Fjmoya-uba/Taller-de-Circuitos-Grupo-5/Checkpoint 5/Informe/main.tex

\documentclass[a4paper,12pt]{article}

%\documentclass[draft, 12pt]{article}
% ================================================== DATOS ==================================================

% Información de la materia
\newcommand{\codMateria}{TA138}
\newcommand{\nombreMateria}{Taller de Diseño de}
\newcommand{\cuatrimestre}{1.\textsuperscript{er} Cuatrimestre}

% Información del TP
\newcommand{\TpTitulo}{Proyecto Integrador -- Checkpoint 5}
\newcommand{\fecha}{\today}
\newcommand{\group}{Grupo 5}

% Información de alumnos
\newcommand{\nombreA}{Lautaro García Vitale}
\newcommand{\padronA}{110.028}
\newcommand{\emailA}{lagarciav@fi.uba.ar}

\newcommand{\nombreB}{Santiago Manuel Cabrera}
\newcommand{\padronB}{110.445}
\newcommand{\emailB}{smcabrera@fi.uba.ar}

\newcommand{\nombreC}{Francisco Javier Moya}
\newcommand{\padronC}{109.899}
\newcommand{\emailC}{fjmoya@fi.uba.ar}

% ================================================== PAQUETES =================================================

% Codificación y lenguaje
\usepackage[utf8]{inputenc}
\usepackage{siunitx}
\usepackage[ddmmyy]{datetime}
\usepackage[language=spanish]{lipsum}
\usepackage[spanish]{datetime2}
\usepackage[T1]{fontenc}
\usepackage[spanish,es-nodecimaldot]{babel}

% -------- CAMBIAR "CUADRO" POR "TABLA" --------
\addto\captionsspanish{
    \renewcommand{\tablename}{Tabla}
}

\usepackage[a4paper,margin=2.5cm]{geometry}
\usepackage{amsmath,amssymb,amsthm,mathtools}
\usepackage{bm}
\usepackage{setspace}
\usepackage{hyperref}
\usepackage{enumitem}

% Márgenes y página
\usepackage{geometry}
\usepackage{fancyhdr}
\usepackage{emptypage}
%\usepackage{parskip}

% Encabezado personalizado
\pagestyle{fancy}
\fancyhf{}
\rhead{\group}
\lhead{\TpTitulo}
\cfoot{\thepage}
\setlength{\headheight}{14.5pt}

% Tipografía matemática
\usepackage{mathtools}
\usepackage{amssymb}
\usepackage{amsfonts}
\usepackage{amsthm}
\usepackage{yhmath}
\usepackage{dsfont}
\usepackage{esdiff}
\usepackage{xfrac}
\usepackage{upgreek}
\usepackage{siunitx}
\sisetup{output-decimal-marker = {,}} % Configura la coma como separador
\sisetup{per-mode=reciprocal, separate-uncertainty=true}

% Gráficos y tablas
\usepackage{graphicx}
\usepackage{float}
\usepackage{booktabs}
\usepackage{caption}
\usepackage{subcaption}
\usepackage{multirow}
\usepackage{adjustbox}
\usepackage{hyperref}

% TikZ y gráficos avanzados
\usepackage{pgfplots}
\pgfplotsset{compat=1.18}
\usepackage{tikz}

% Código fuente y resaltado
\usepackage{minted}
\usepackage{tcolorbox}
\definecolor{codebg}{rgb}{0.95,0.95,0.95}  % Color de fondo del código
\usemintedstyle{friendly}                  % Estilo del resaltado de sintaxis
\setminted{
    linenos=true,                          % Numeración de líneas
    bgcolor=codebg,                        % Color de fondo del código
    fontsize=\footnotesize,                % Tamaño de la fuente
    frame=lines,                           % Estilo del marco
    framesep=2mm,                          % Separación del marco
    baselinestretch=1.2,                   % Espaciado entre líneas
    breaklines=true,                       % Romper líneas largas automáticamente
    encoding=utf8,                         % Codificación del archivo
    tabsize=4,                             % Tamaño de la tabulación
}

% Misceláneo
\usepackage{anyfontsize}
\usepackage{xcolor}
\usepackage{url}
\usepackage{comment}
\usepackage{multicol}
\usepackage[numbers,square]{natbib}

% Estilo de bibliografía
\bibliographystyle{IEEEtran}

% ==============================================================================================================
% ==============================================================================================================

\begin{document}

% ================================================== CARÁTULA ==================================================

\pagenumbering{arabic} % Comienza la numeración

\vspace{-1 cm} % La primera hoja tiene que tener menos espaciado

\begin{center}
  \begin{minipage}{0.8 cm}
    
  \end{minipage}
  \begin{minipage}{\widthof{\large{\textsc{Universidad de Buenos Aires}}}}
    \centering
    \large{\textsc{Universidad de Buenos Aires}}\\
    \large{\textsc{Facultad de Ingeniería}}\\
    \small{Año 2026 -- \cuatrimestre}
  \end{minipage}
\end{center}
\vspace{10mm}
\begin{center}
  \huge{\underline{\textsc{\nombreMateria}}} \\
  \huge{\underline{\textsc{Circuitos Electrónicos}}} \\
  \vspace{7 pt}
  \Large{\TpTitulo \\}
  \vspace{3mm}
  \large{\group}
\end{center}

\newcommand{\anchopadron}{\widthof{000 000}}
\begin{center}
  \begin{tabular}{l l l}
    \nombreA & \parbox{\anchopadron}{\raggedleft \padronA} & \texttt{\emailA} \\
    \nombreB & \parbox{\anchopadron}{\raggedleft \padronB} & \texttt{\emailB} \\
    \nombreC & \parbox{\anchopadron}{\raggedleft \padronC} & \texttt{\emailC} 
  \end{tabular}
\end{center}
\vspace{8mm}

\begin{center}
\renewcommand{\arraystretch}{1.3}
\begin{tabular}{@{}r p{0.62\textwidth}@{}}
\textbf{Tutor:} & Ing. Federico Gabriel D'Angiolo. \\ 
\textbf{Docentes:} & Ing.Julio Guillermo Zola, Ing. Marcelo Adrián Bruno, Ing. Sergio Quinteros e Ing. Juan Guido Salaya.
\end{tabular}
\end{center}

\vspace{2em}
\thispagestyle{empty}

\begin{abstract}
En este informe se presenta el diseño, implementación y validación experimental de una fuente conmutada tipo \textit{buck} a lazo cerrado, desarrollada como etapa final del proyecto integrador. Se aborda la caracterización del inductor, el ajuste del generador PWM, la selección de componentes de la etapa de potencia, la implementación del \textit{gate driver}, el diseño de la red de compensación y la fabricación del PCB. También se incluyen simulaciones de estabilidad y mediciones sobre el prototipo final, junto con la integración de la etapa reguladora LDO. Los resultados obtenidos verifican un funcionamiento estable de la fuente, con buena regulación de línea y de carga, eficiencias superiores al $90\%$ para $V_{in}=12\,$V en el rango ensayado y un desempeño adecuado frente a variaciones de entrada y carga. A partir de la comparación entre el modelo teórico, las simulaciones y las mediciones experimentales, se identificaron y corrigieron diferencias propias de la implementación práctica, obteniéndose finalmente una fuente funcional, eficiente y experimentalmente validada.
\end{abstract}

\newpage
\tableofcontents
\newpage

\section{Introducción}
\input{sections/intro.tex}

\section{Caracterización del inductor}
% Incluir recálculos del inductor y sus mediciones.
\input{sections/inductor.tex}

\section{Diseño de la \textit{buck} a lazo cerrado}
\subsection{Modificación del circuito generador del PWM}
\input{sections/diseño_buck/modif_pwm.tex}
% Indicar la medición del tiempo de propagación del comparador y su debida corrección en LTspice. Indicar nuevos valores de resistencia y/o capacitor para obtener una frecuencia de 120-140 kHz. Indicar modificaciones en el circuito (se cambia el potenciómetro por Vc). No hace falta una nueva etapa que garantice 4 V < Vc < 5 V porque como el comparador integra el error, en algun momento llegara a los valores de la triangular.
\subsection{Diodos de rueda libre}
% Incluir análisis de los diodos en el switching.
\input{sections/diseño_buck/diodos.tex}
\subsection{Carga fantasma}
% Mencionar para qué sirve y el agregado del led.
\input{sections/diseño_buck/fantasma.tex}
\subsection{Capacitores}
% Incluir gráfico de la capacidad vs. la frecuencia. Mencionar que se escoge un capacitor más grande. Incluir capacitor cerámico en paralelo para disminuir la ESR.
\input{sections/diseño_buck/capacitores.tex}
\subsection{\textit{Gate driver}}
% Explicar para que funciona e incluir los cálculos del diodo y capacitor de boostrap.

\input{sections/diseño_buck/Gate driver.tex}

\subsection{Red de compensación}
% Hablar de la red de compensación tipo III y cómo se calcularon sus componentes (Agregar en un apéndice los cálculos matriciales).
\input{sections/diseño_buck/compensacion.tex}
\subsection{Circuito final}
% Incluir un esquemático del diseño final del circuito.
\input{sections/diseño_buck/circuito-final.tex}

\section{Simulaciones}
% Incluir gráficos de simulaciones.
\input{sections/Simulaciones.tex}

\section{Diseño e implementación del PCB}
\input{sections/PCB.tex}

\section{Mediciones}
% Incluir gráficos de mediciones.
\input{sections/mediciones.tex}

\section{Integración final con el LDO}
\input{sections/ldo.tex}

\section{Conclusiones}
\input{sections/conclusiones.tex}

\input{sections/bibliografia.tex}

\end{document}
