Fjmoya-uba/Taller-de-Circuitos-Grupo-5/Checkpoint 5/Informe/sections/bibliografia.tex

\begin{thebibliography}{9}

\bibitem{CosmoFerrites_CF196}
Cosmo Ferrites Ltd.,
\textit{Material Specifications CF196},
Material Data Sheet,
4 August 2017.

\bibitem{CosmoFerrites_EE3007}
Cosmo Ferrites Ltd.,
\textit{Product Data Sheet: Core EE3007},
Product Data Sheet.

\bibitem{Zhang2015}
H. J. Zhang,
``Modelado y diseño de compensación de lazo en fuentes de alimentación conmutadas. Parte 1ª'',
\textit{Revista Española de Electrónica (REE)},
n.º 96, pp. 96--101, octubre de 2015.
Artículo cedido por Linear Technology.

\bibitem{IR2104_datasheet}
International Rectifier,
\textit{IR2104(S) \& IR2104S(PbF) Half-Bridge Driver Datasheet},
Data Sheet No. PD60046-S, Abril 2004.

\bibitem{LM2576_datasheet}
Texas Instruments,
\emph{LM2576, LM2576HV SIMPLE SWITCHER (R) 3-A Step-Down Voltage Regulator Datasheet},
Document No.~SNVS107G,
Revision~G, March~2023.

\bibitem{Vishay_030031AS}
Vishay BCcomponents,
\textit{030/031 AS Aluminum Electrolytic Capacitors, Axial Standard},
Document Number~28327,
Revision: 16 September 2016.

\end{thebibliography}
