Fjmoya-uba/Taller-de-Circuitos-Grupo-5/Checkpoint 5/Informe/sections/diseño_buck/circuito-final.tex

En base a todo lo comentado en las secciones anteriores, el circuito final queda como se observa en la Figura~\ref{fig:circuito-final}.

\newpage

\begin{figure}[H]
    \centering
    
    \caption{Circuito final hecho en KiCad.}
    \label{fig:circuito-final}
\end{figure}

\newpage
