Fjmoya-uba/Taller-de-Circuitos-Grupo-5/Checkpoint 5/Informe/sections/diseño_buck/fantasma.tex

Con el fin de garantizar una corriente mínima de salida durante los ensayos experimentales, se incorporó una carga fantasma compuesta por un diodo LED y su correspondiente resistencia limitadora de corriente. En los convertidores \textit{buck}, especialmente cuando operan en lazo cerrado, una carga mínima contribuye a mantener una regulación estable de la tensión de salida y evita comportamientos indeseados asociados al funcionamiento en vacío, como oscilaciones o una regulación deficiente. Además, el LED proporciona una indicación visual inmediata del correcto funcionamiento de la fuente, permitiendo verificar de manera sencilla la presencia de tensión en la salida durante las pruebas.
