Fjmoya-uba/Taller-de-Circuitos-Grupo-5/Checkpoint 5/Informe/img/Mediciones imagenes/Regulación de carga.pdf

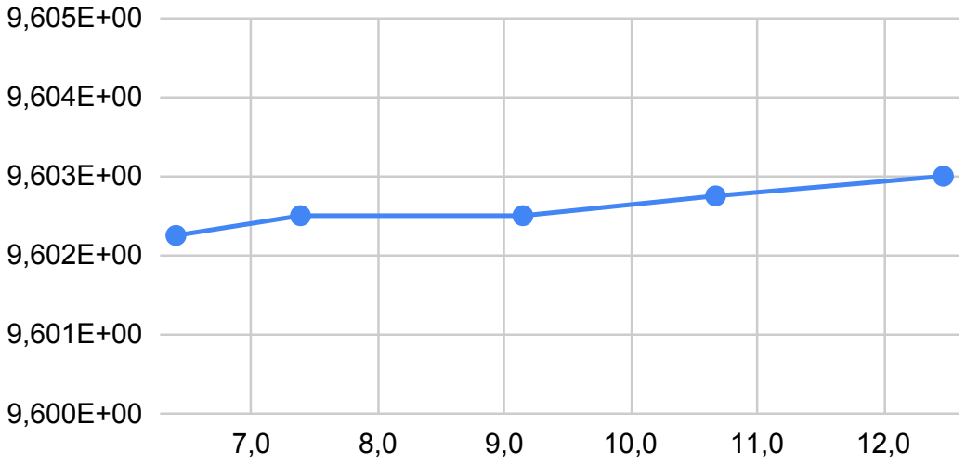
[picture p64: figure]

RL [Ohm]

Vo[V]

## Regulación de carga
