Fjmoya-uba/Taller-de-Circuitos-Grupo-5/Checkpoint 5/Mediciones imagenes/Eficiencia vs. corriente de salida.pdf

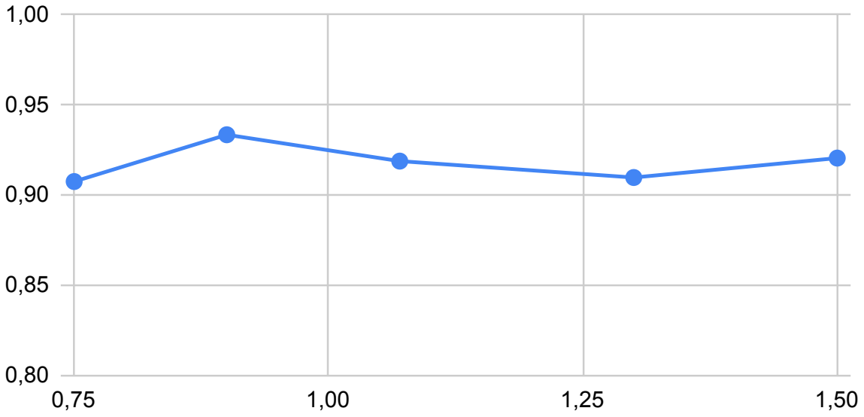
[picture p65: figure]

Io[A]

Eficiencia

## Eficiencia vs. corriente de salida
