Fjmoya-uba/Taller-de-Circuitos-Grupo-5/Checkpoint 5/Mediciones imagenes/Regulacion de carga.pdf

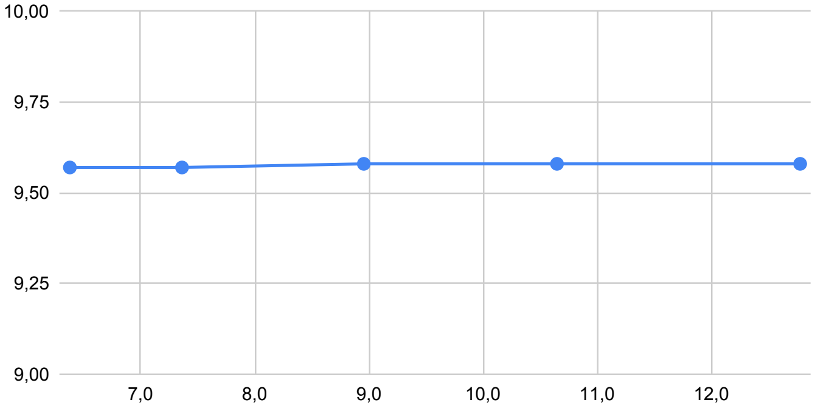
[picture p66: figure]

RL [Ohm]

Vo[V]

## Regulación de carga
