Fjmoya-uba/Taller-de-Circuitos-Grupo-5/Checkpoint 5/Mediciones imagenes/Eficiencia vs. tensión de entrada.pdf

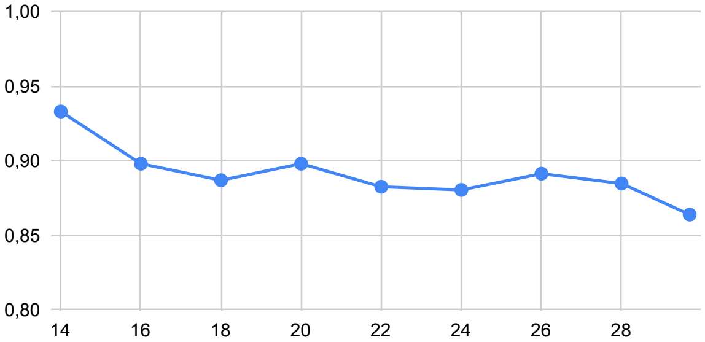
[picture p67: figure]

Vin[V]

Eficiencia

## Eficiencia vs. tensión de entrada
