Fjmoya-uba/Taller-de-Circuitos-Grupo-5/Checkpoint 5/Mediciones imagenes/Regulación de linea.pdf

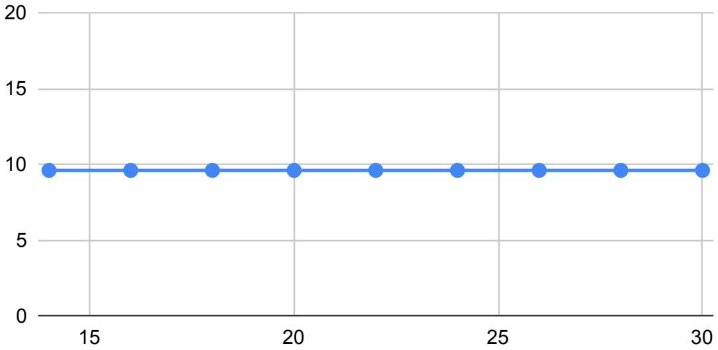
[picture p68: figure]

Vin[V]

Vout[V]

## Regulación de línea
