Fjmoya-uba/Taller-de-Circuitos-Grupo-5/Checkpoint 5/Compensación - Cuentas.pdf

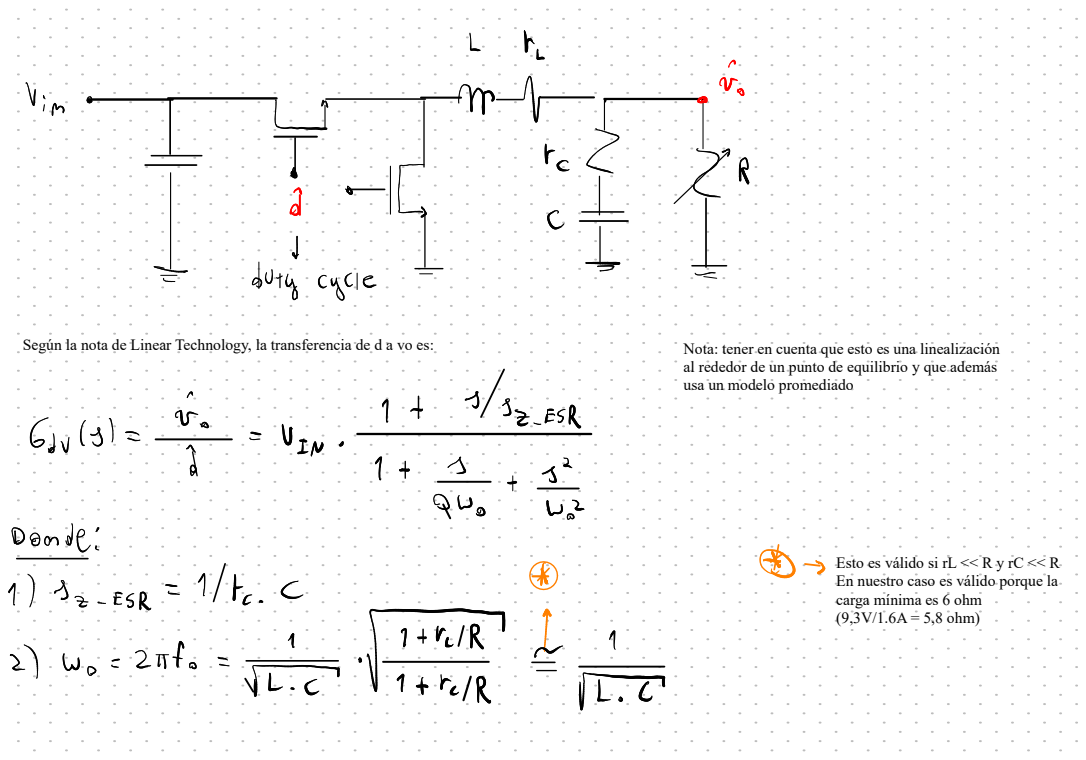
[picture p69: page 1]
Según la nota de Linear Technology, la transferencia de d a vo es:; Nota: tener en cuenta que esto es una linealización

al rededor de un punto de equilibrio y que además
usa un modelo promediado

Esto es válido si rL << R y rC << R
En nuestro caso es válido porque la
carga mínima es 6 ohm
(9,3V/1.6A = 5,8 ohm)

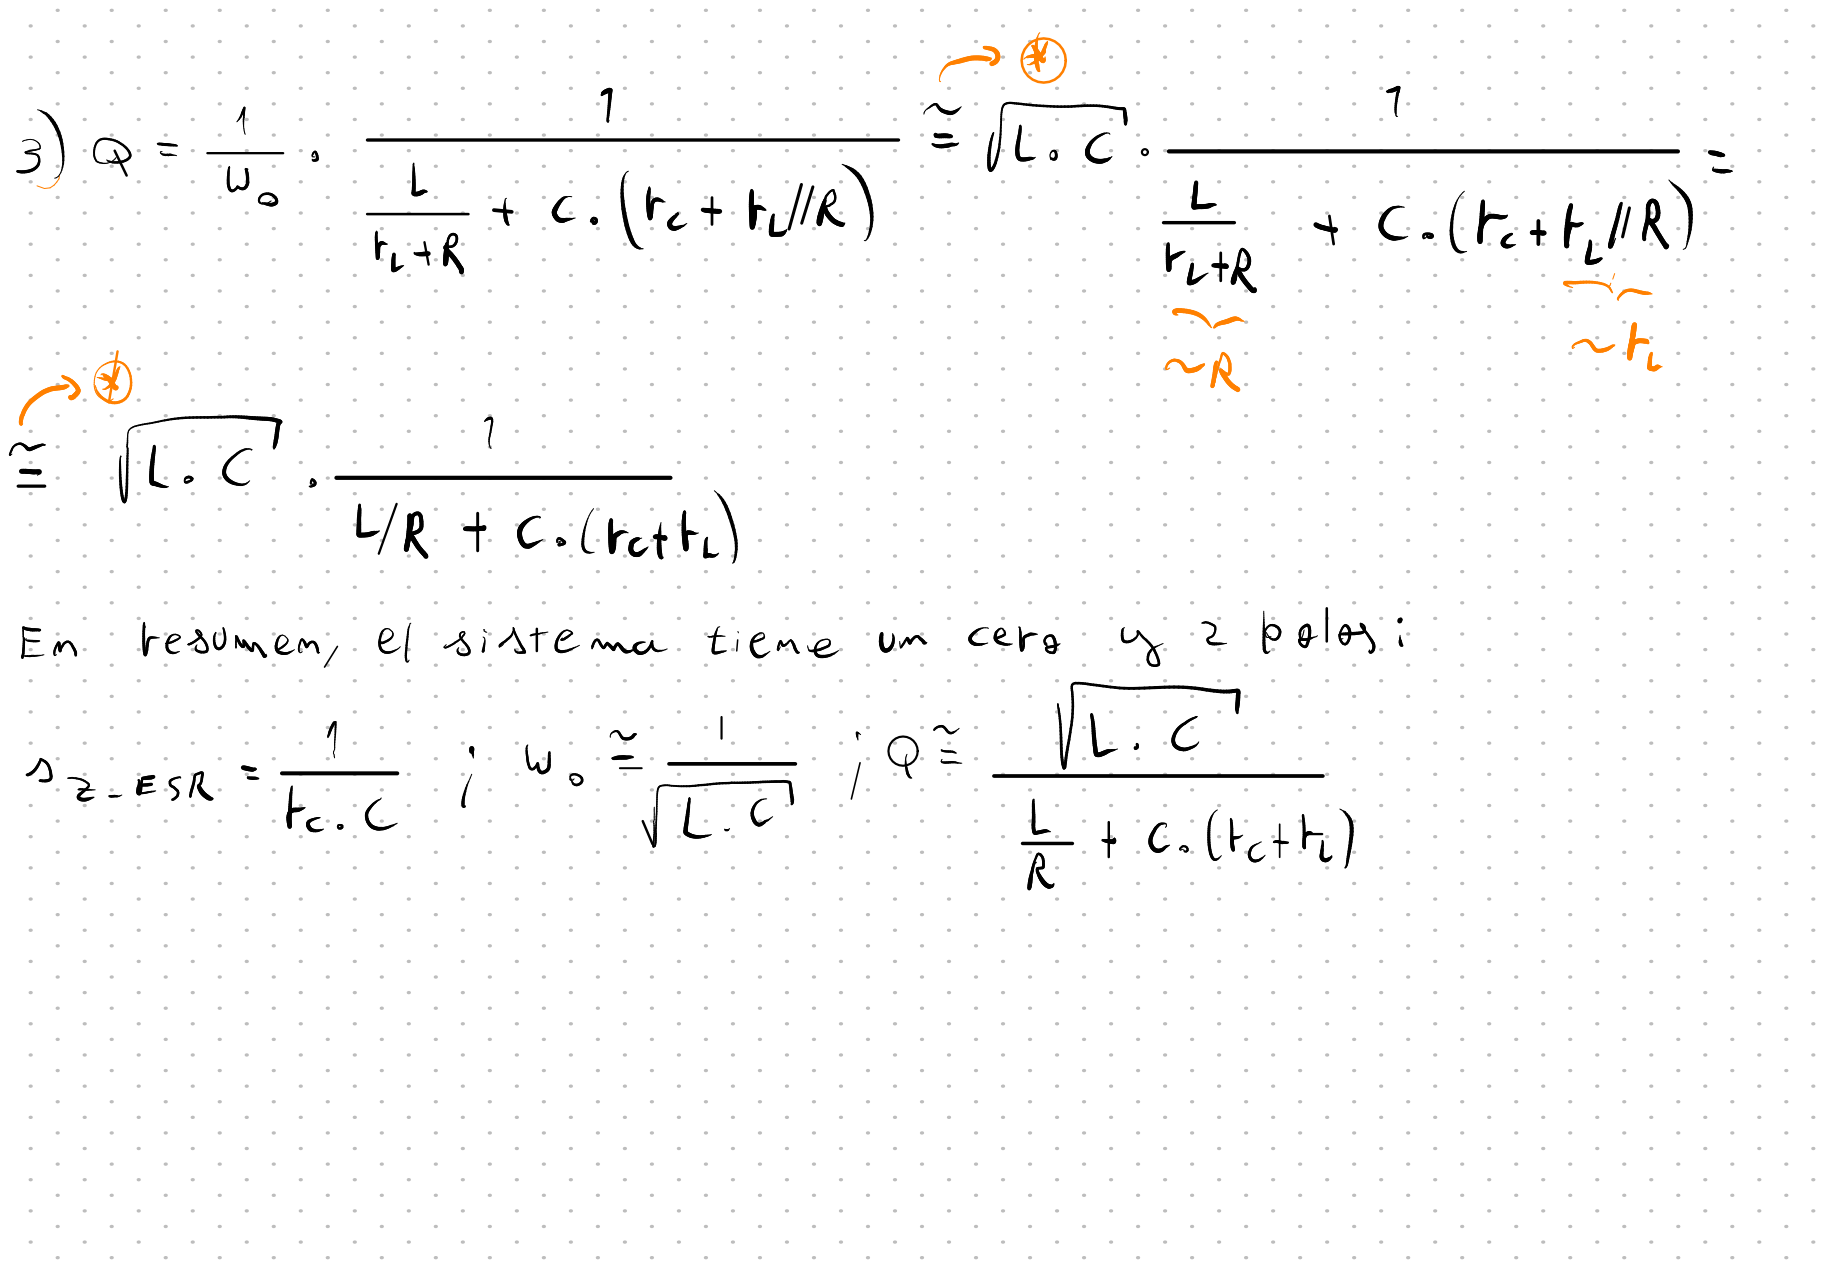
[picture p70: page 2]

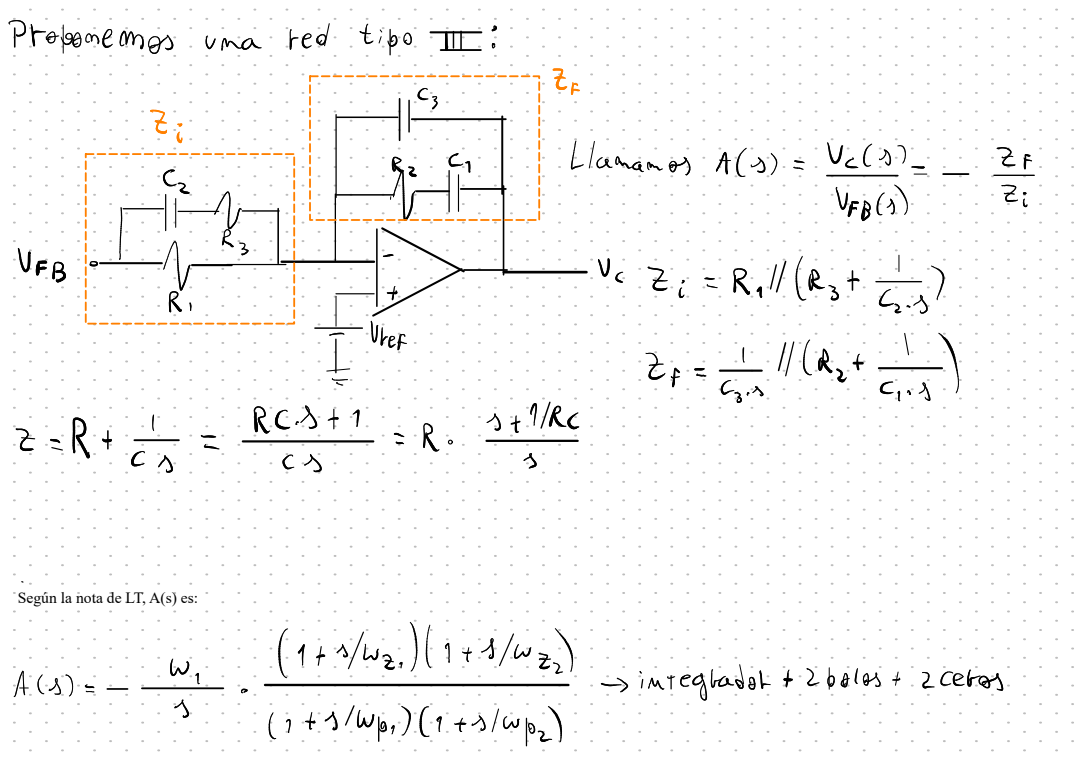
[picture p71: page 3]

Según la nota de LT, A(s) es:

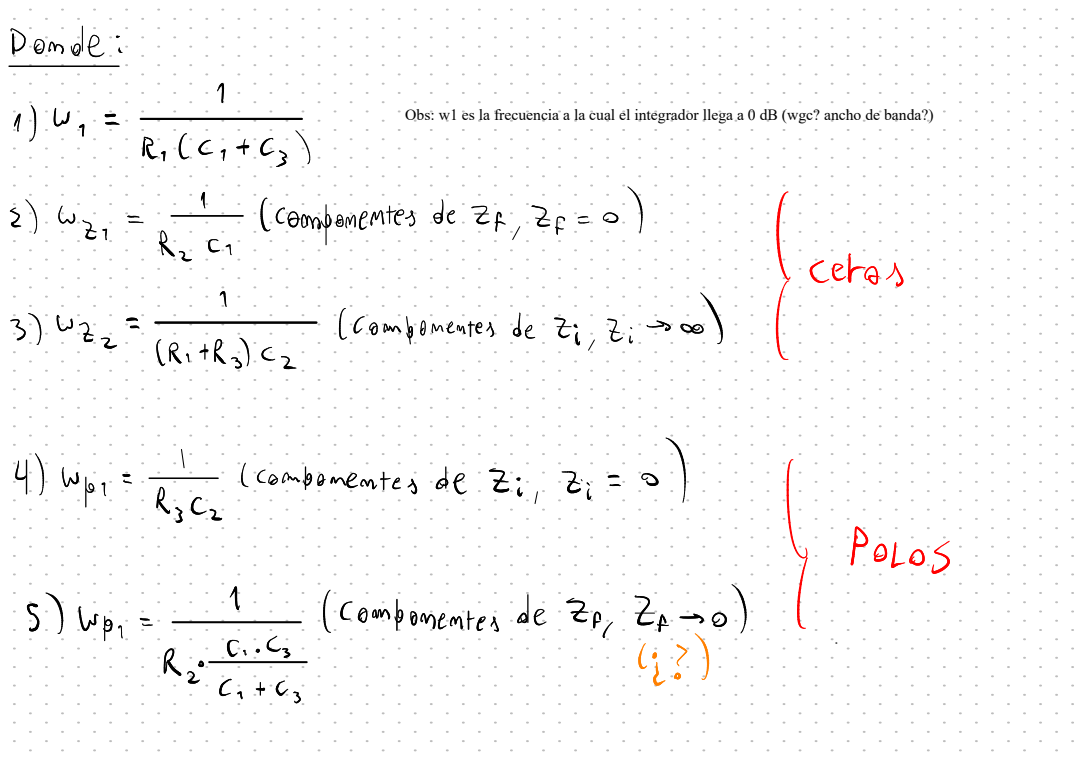
[picture p72: page 4]

Obs: w1 es la frecuencia a la cual el integrador llega a 0 dB (wgc? ancho de banda?)

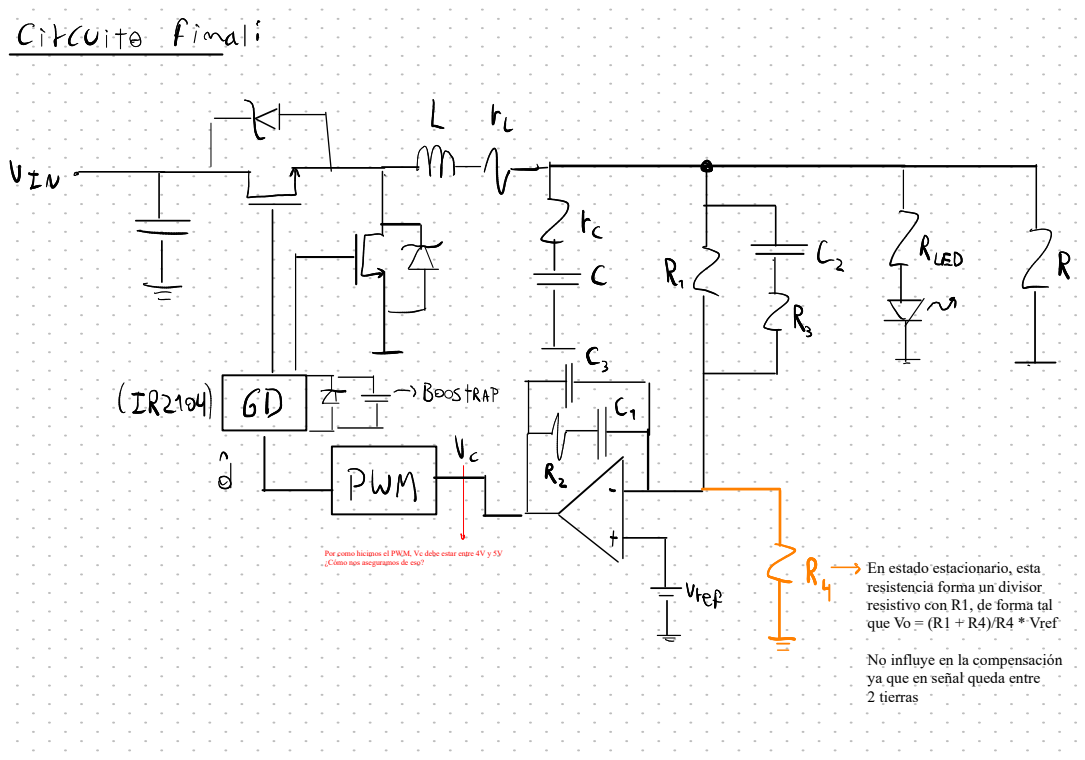
[picture p73: page 5]
¿Cómo nos aseguramos de eso?; En estado estacionario, esta

Por como hicimos el PWM, Vc debe estar entre 4V y 5V

resistencia forma un divisor
resistivo con R1, de forma tal
que Vo = (R1 + R4)/R4 * Vref

No influye en la compensación
ya que en señal queda entre
2 tierras

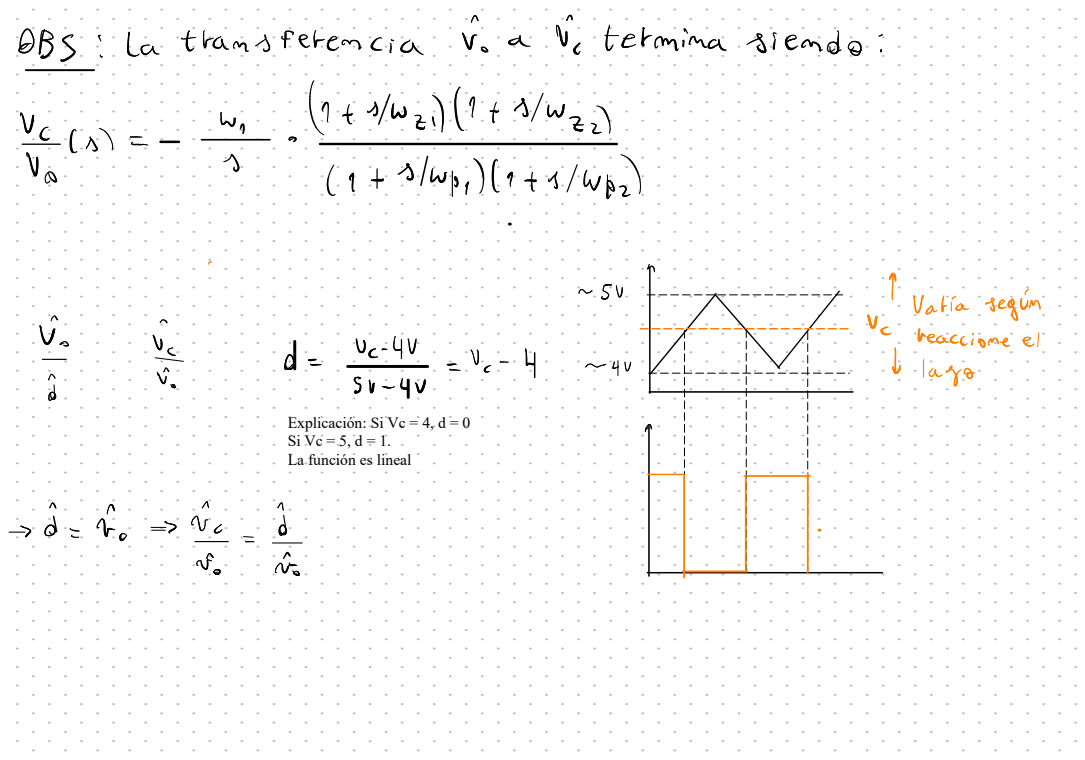
[picture p74: page 6]

Explicación: Si Vc = 4, d = 0
La función es lineal

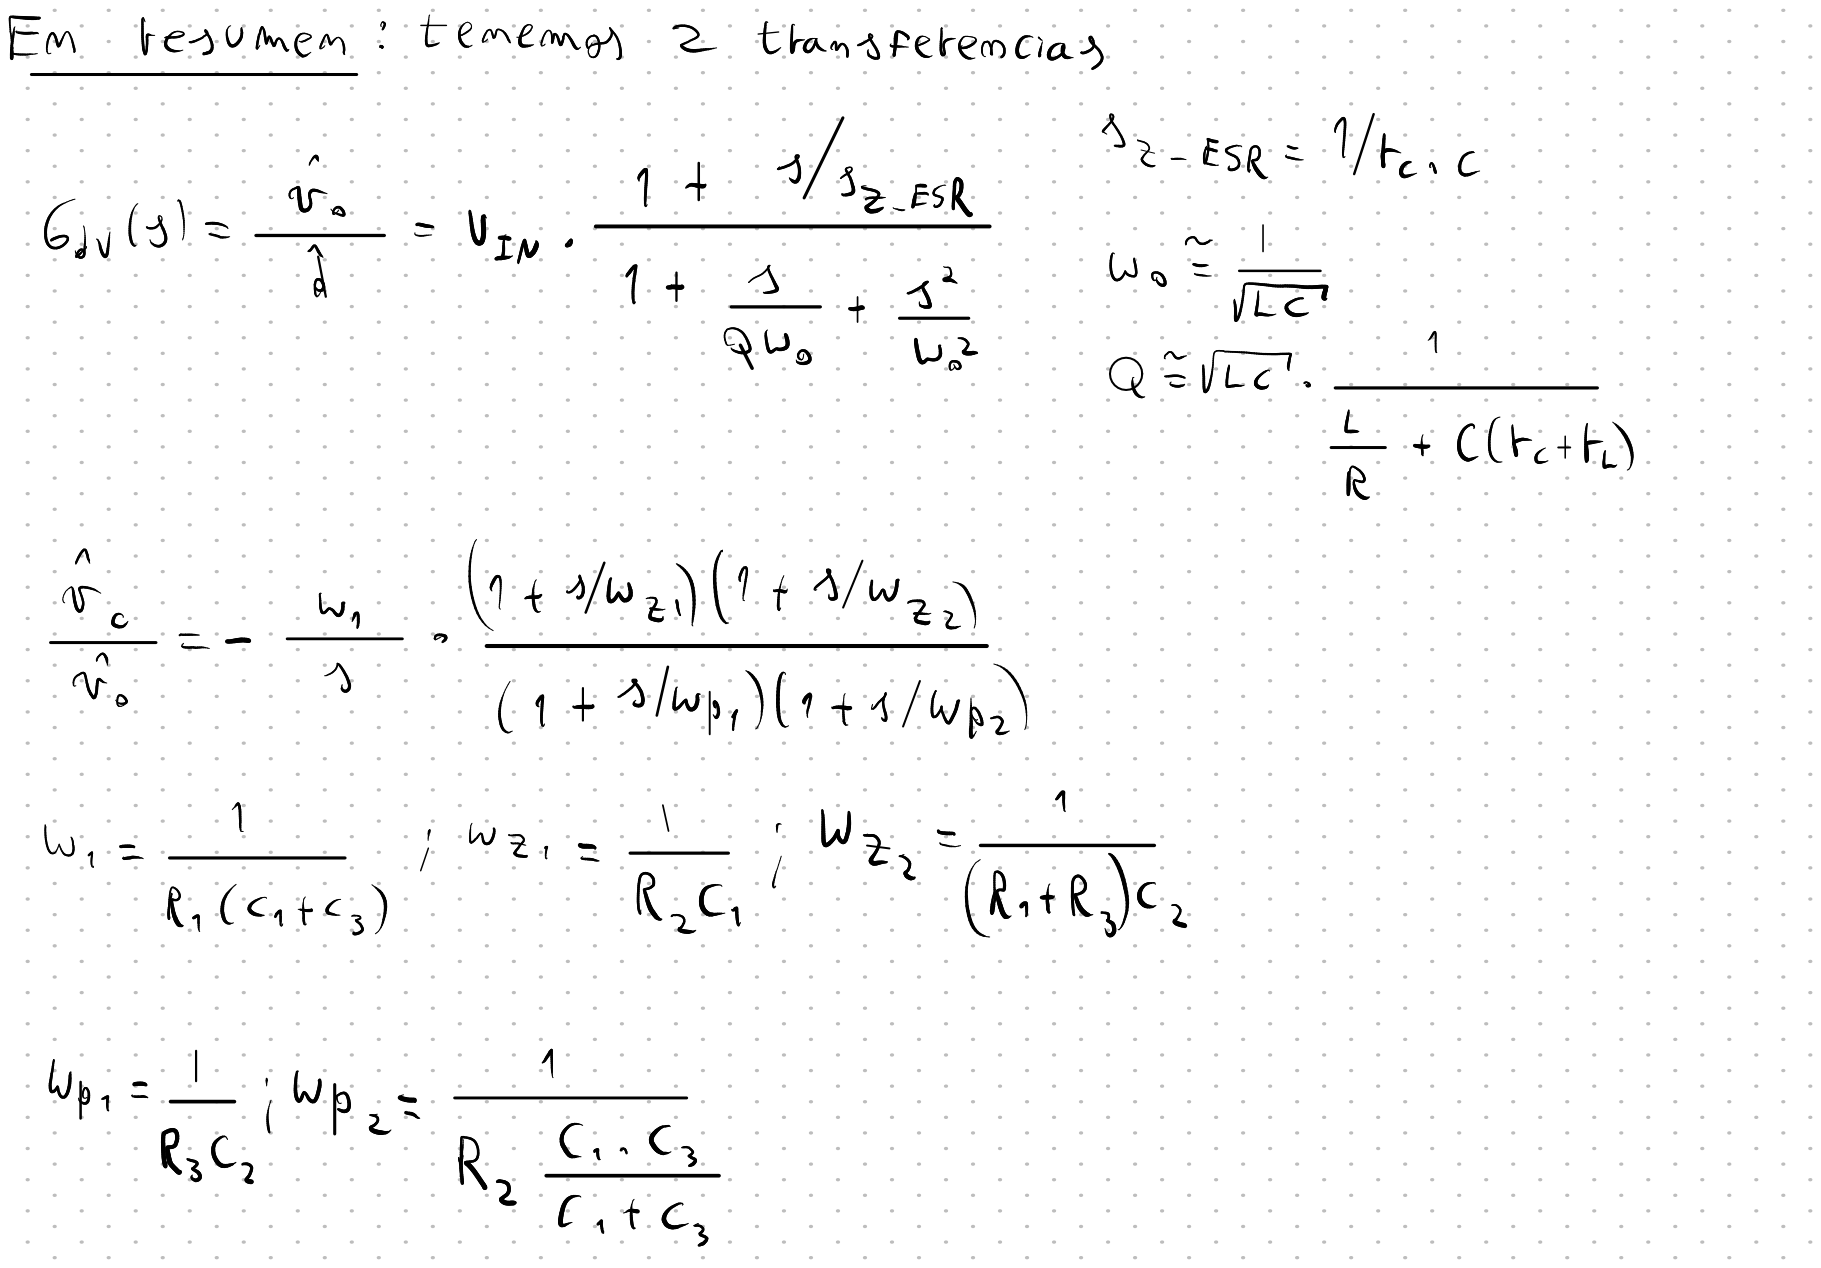
[picture p75: page 7]

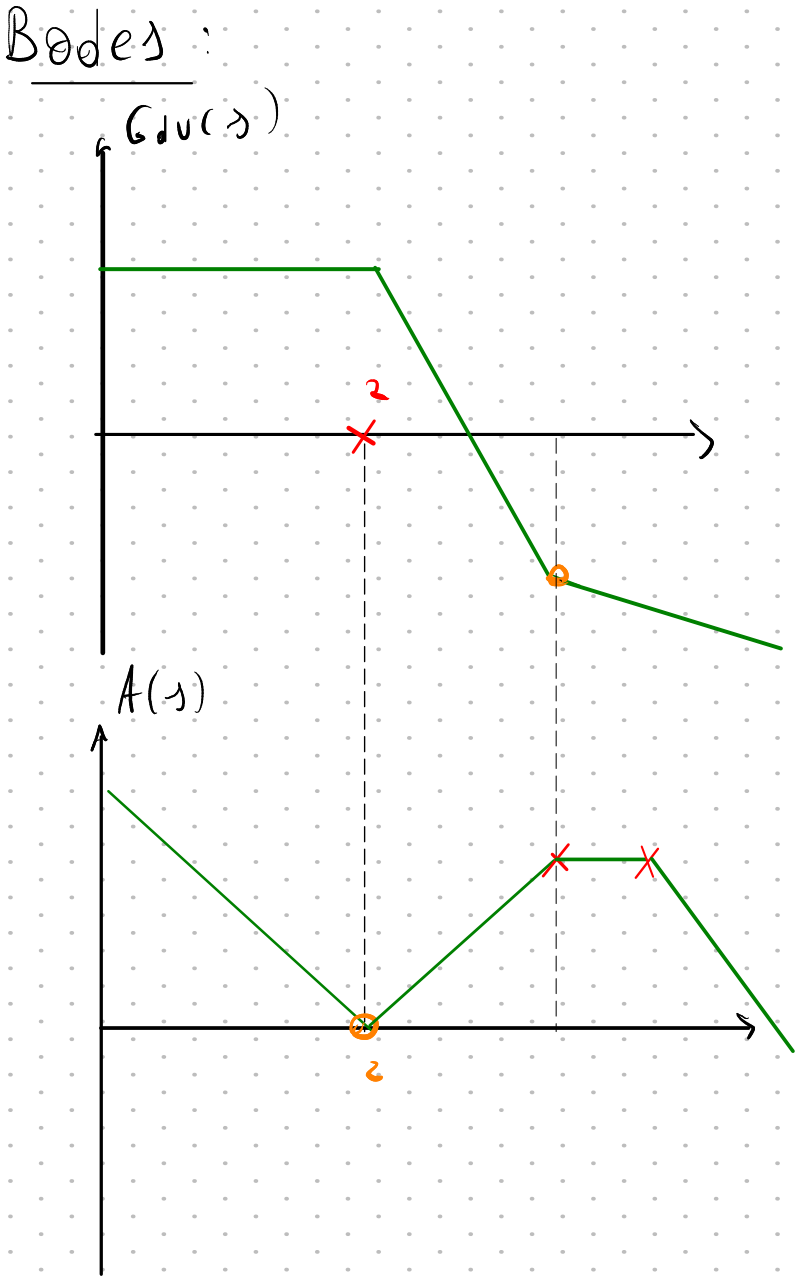
[picture p76: figure]

Estrategia de compensación:

1)Con los dos ceros del controlador, cancelar los 2 polos de la planta (los polos
de resonancia) Estos polos los conocemos si tenemos L y C
2) Con el primer polo del controlador, cancelar el cero de la rC
OJO: Primero hay que conocer con precisión el valor de rC ¿Cómo? ¿Lo medimos?
3) Con el segundo polo del controlador, establecer la frecuencia de corte y el
ancho de banda. Reducir el ruido de la conmutación.

Los pasos más fáciles son el 1) y el 3)

Preguntas: ¿qué componentes conviene elegir primero? ¿Hay alguno que se pueda despreciar frente a otro?

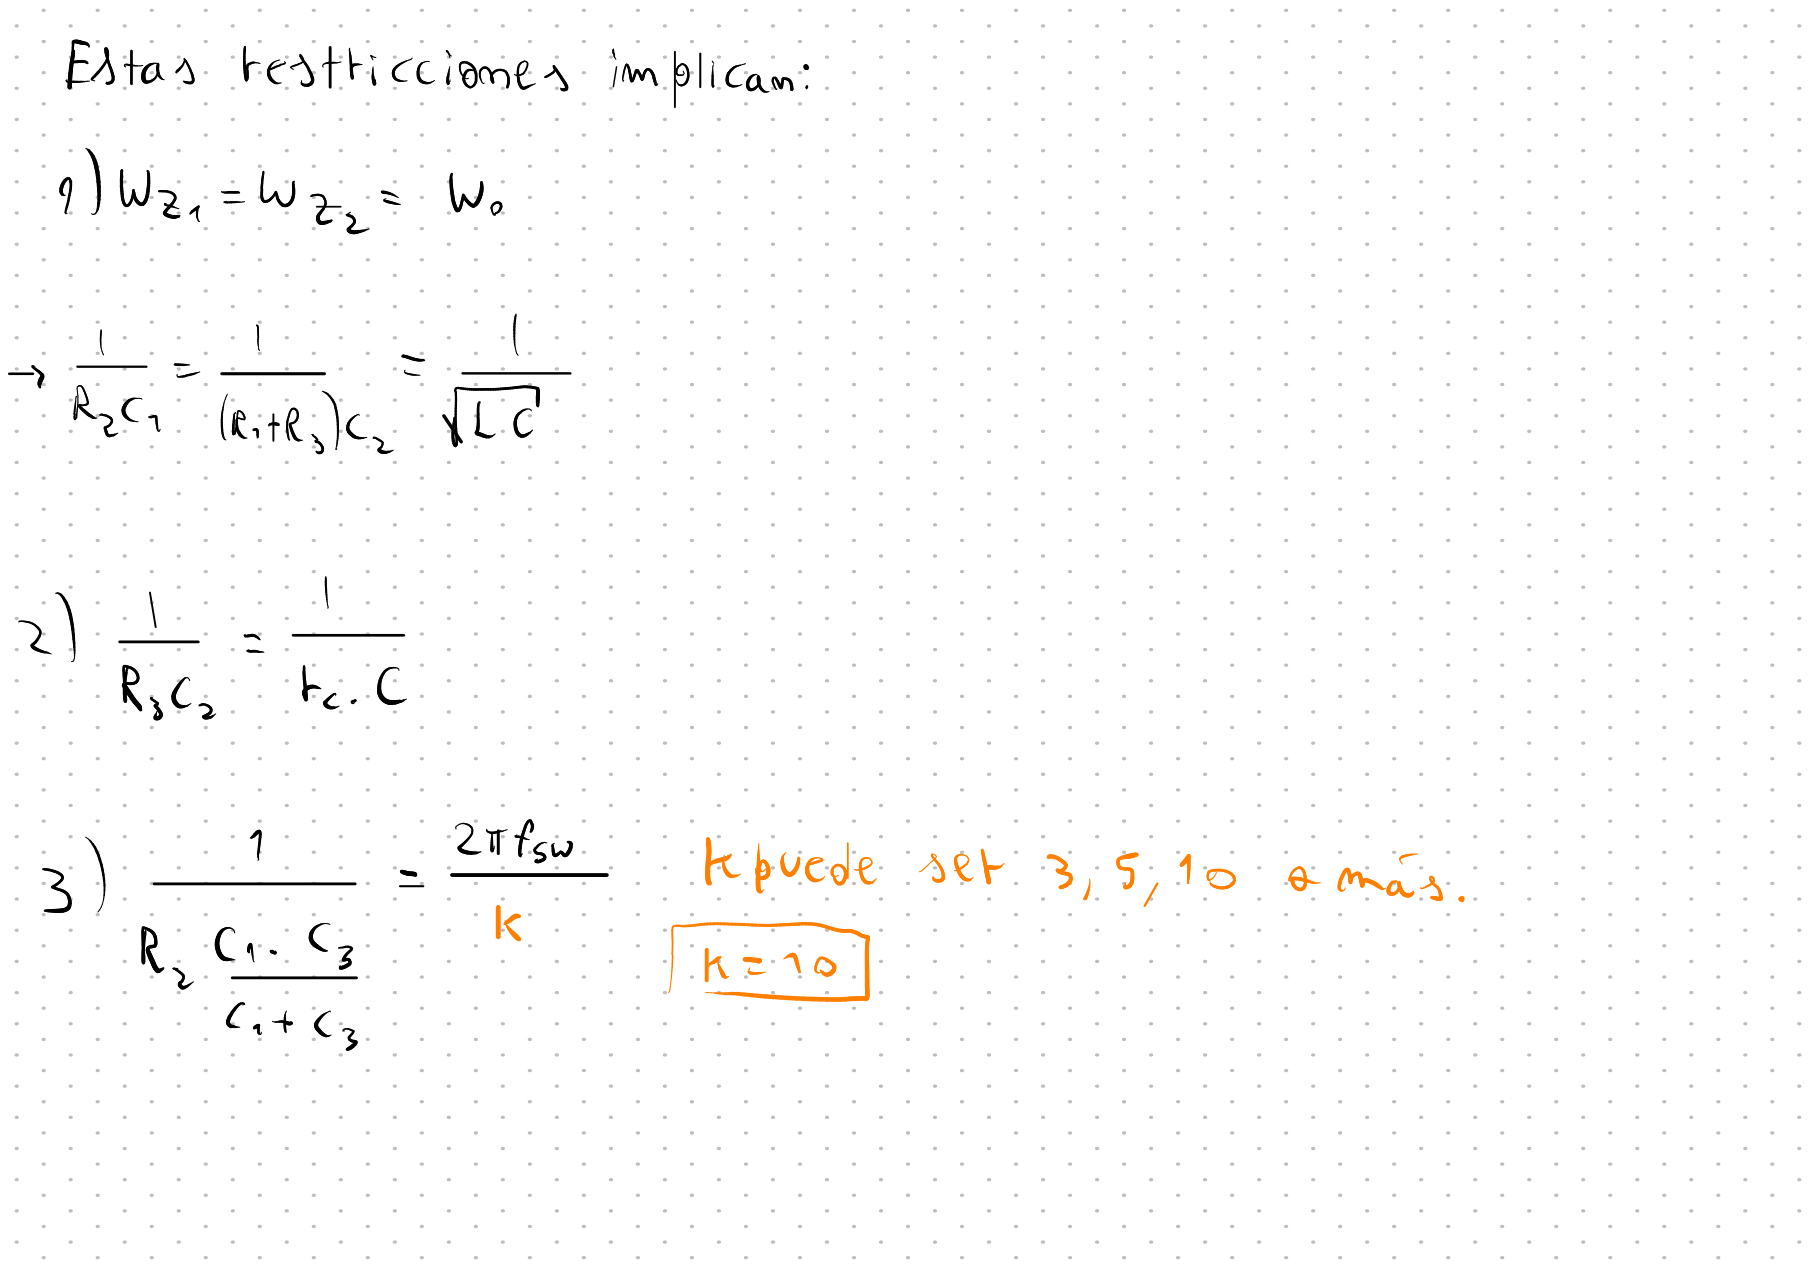
[picture p77: page 9]

Idea: hacer un script de python que tome los valores de los polos y ceros que quiero y devuelva los valores (¿comerciales?) de los componentes

Entradas:
1) w1: ancho de banda o ganancia del integrador
2) wz1: primer cero
3) wz2: segundo cero. Los ceros cancelan el polo doble de la planta
4) wp1: primer polo
5) wp2: segundo polo, define el ancho de banda y filtra ruido de switching.

Salidas:

C1, C2, C3, R1, R2, R3

5 restricciones, 6 variables, 1 grado de libertad?

Advertencia: no mezclar radianes/s con Hz!!!!!

Idea: puedo hacer el problema lineal aplicando un logaritmo?

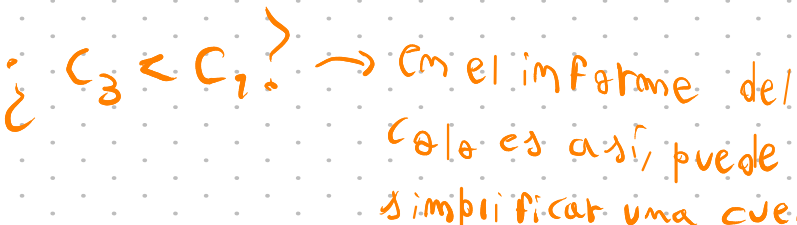
[picture p78: figure]

Quisera hacer las siguientes aproximaciones: R1 >> R3 o R1 << R3

y

C1 >> C3 o C1 << C3

Obs: Si R1 << R3, Wz2 y Wp1 coinciden y se cancelan. ¿Indeseable?

Es indeseable porque rompe con la estrategia de compensación.

Podría pensar que me conviene elegir R1 >> R3, pero si hiciera esa aproximación Wz2 << Wp1. Eso también es indeseable, ya que el cero de la ESR (que debe ser cancelado por Wp1) podría ser del orden de magnitud del polo doble, que debe ser cancelado por Wz2

O sea, no conviene ninguna de las dos aproximaciones. R1 y R3 deben ser similares

Obs2: Si C1 << C3, Wz1 y Wp2 se cancelan ¿Indeseable? Es indeseable por la misma razón.

Si en cambio elijo C1 >> C3, es necesario que Wz1 << Wp2
Yo necesito Wp2 = 2*pi*fsw/10 = 82 000 rad/s
y wz1 = 2*pi * 10kHz (aprox) = 62 000 rad/s
Wp2 tiene que ser 10 veces inferior a la frecuencia de switching, así que podría estar en el orden de magnitud de Wz1

Otra vez, pareciera que ninguna de las 2 aproximaciones conviene. C1 y C3 deben ser similares

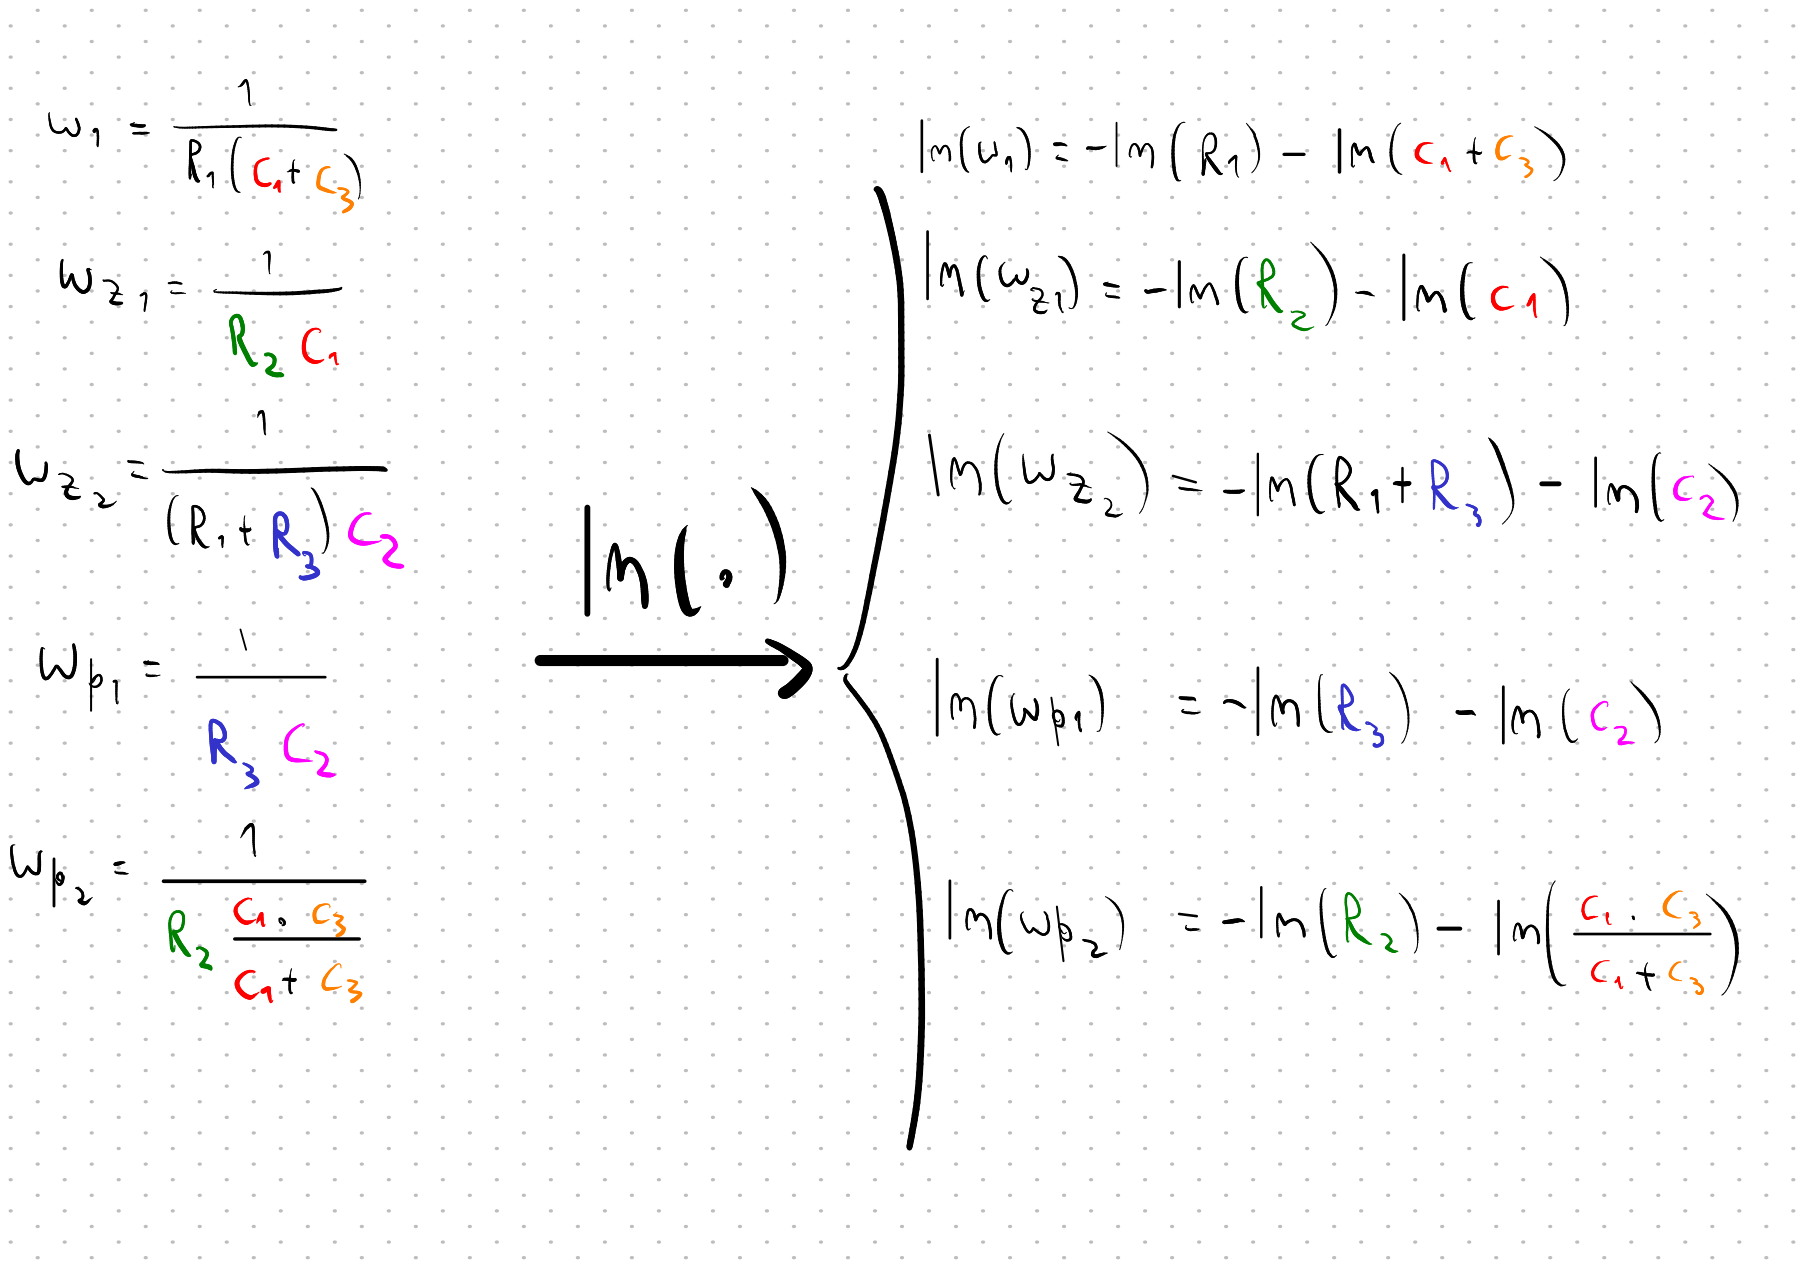
[picture p79: page 12]

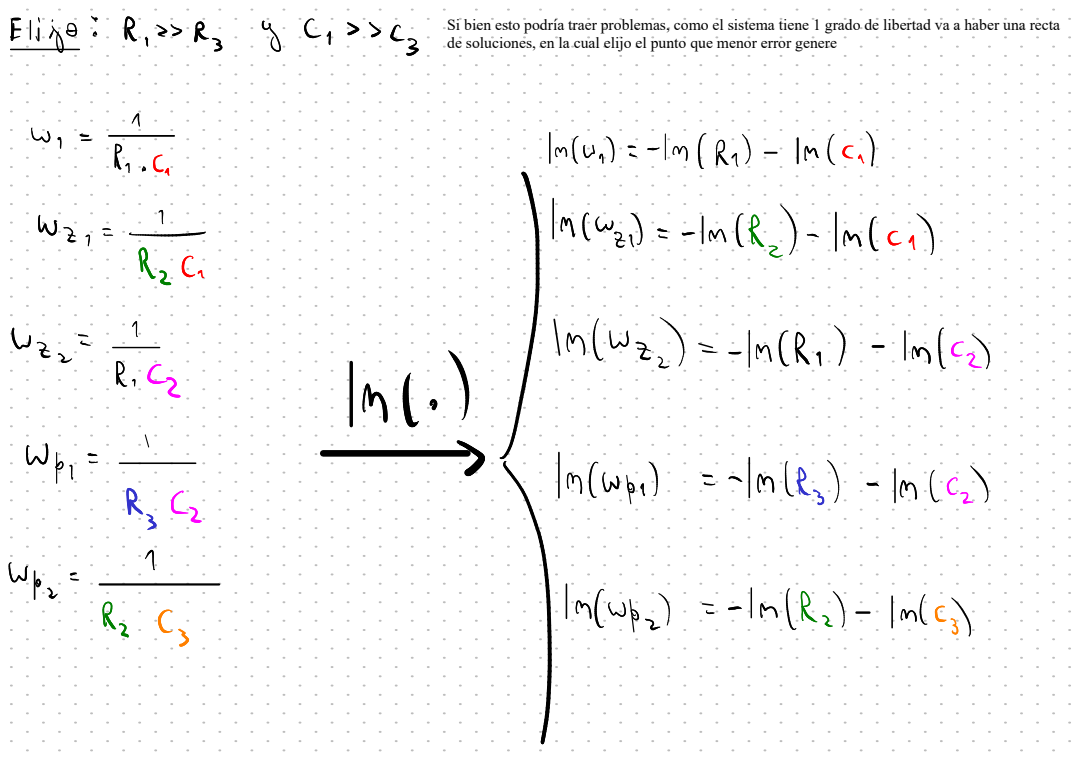
[picture p80: page 13]

Si bien esto podría traer problemas, como el sistema tiene 1 grado de libertad va a haber una recta
de soluciones, en la cual elijo el punto que menor error genere

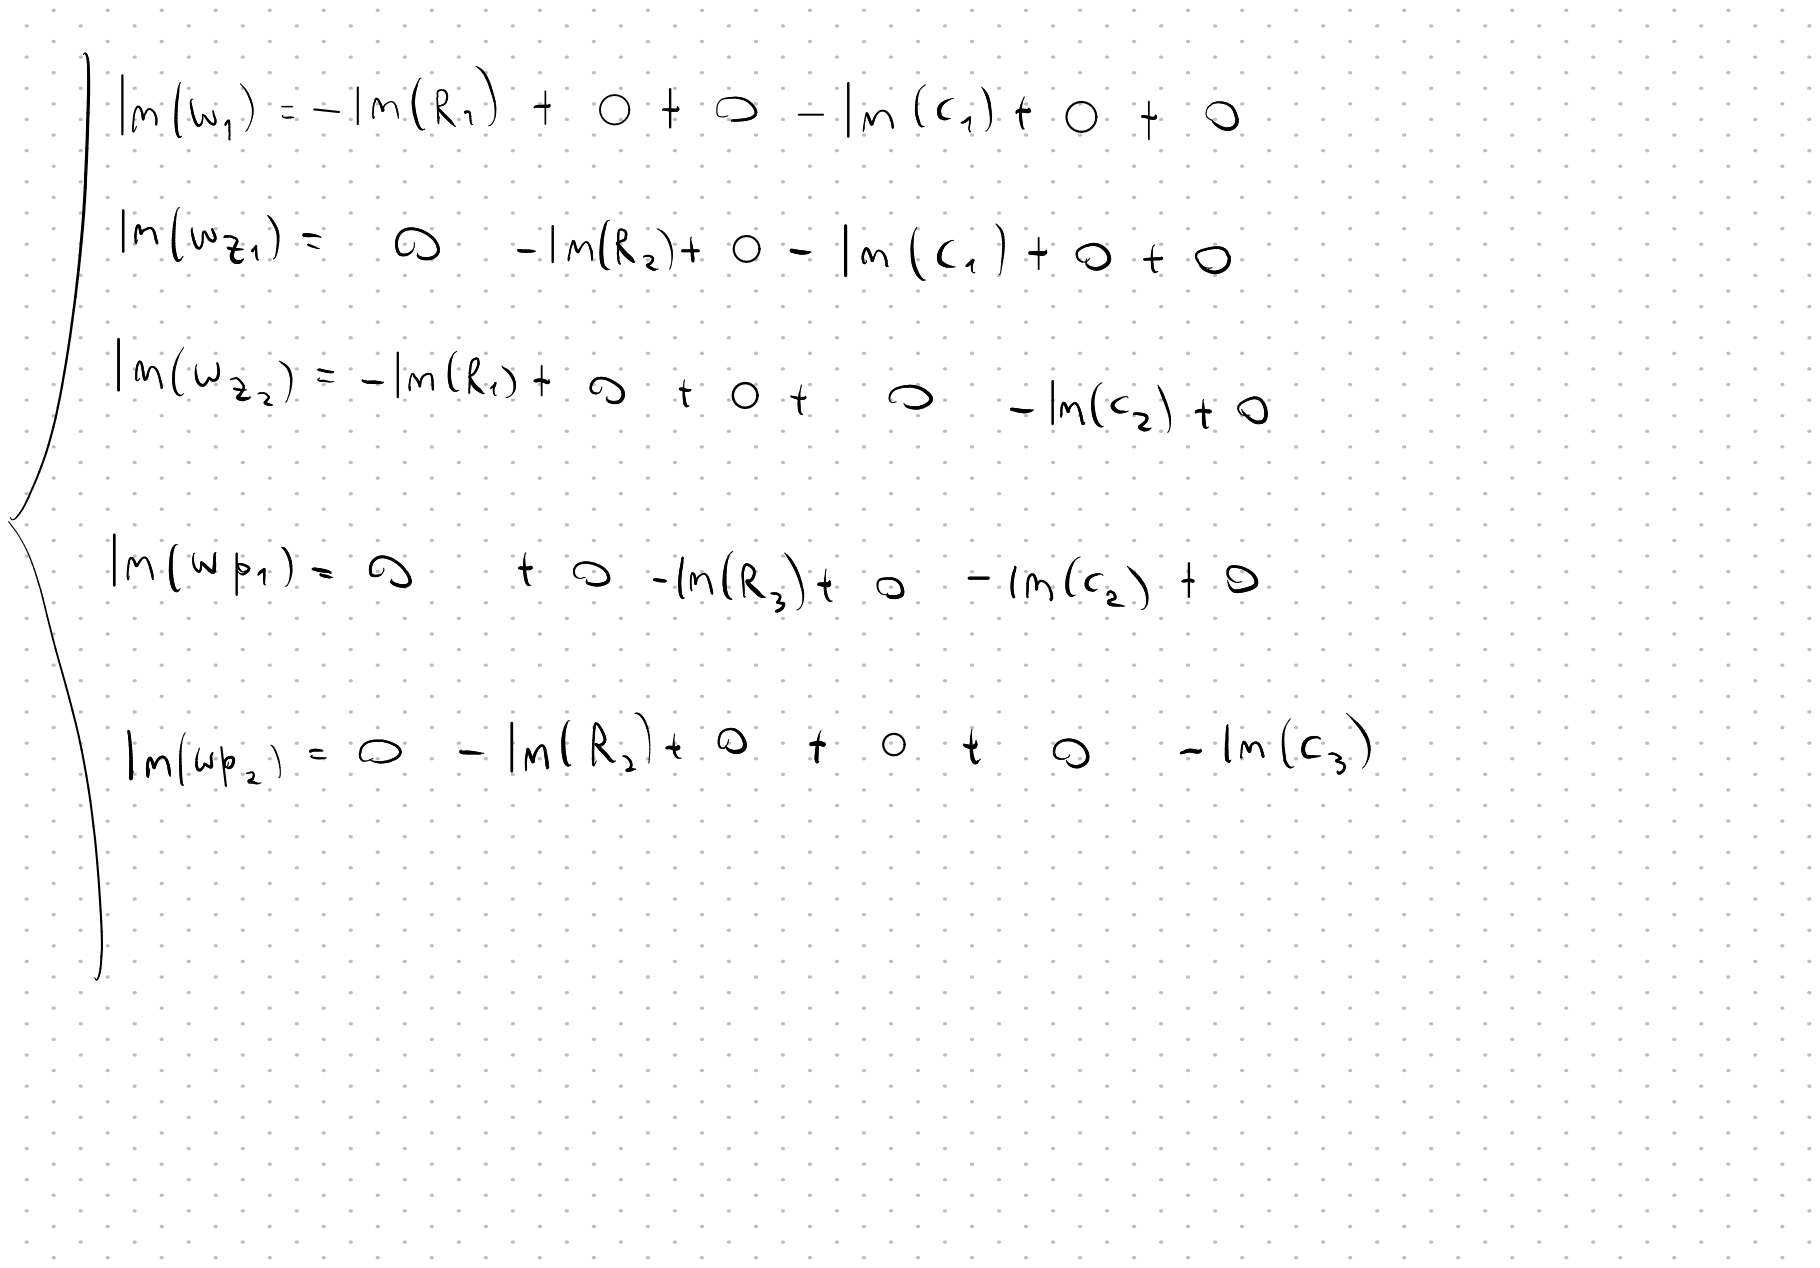
[picture p81: page 14]

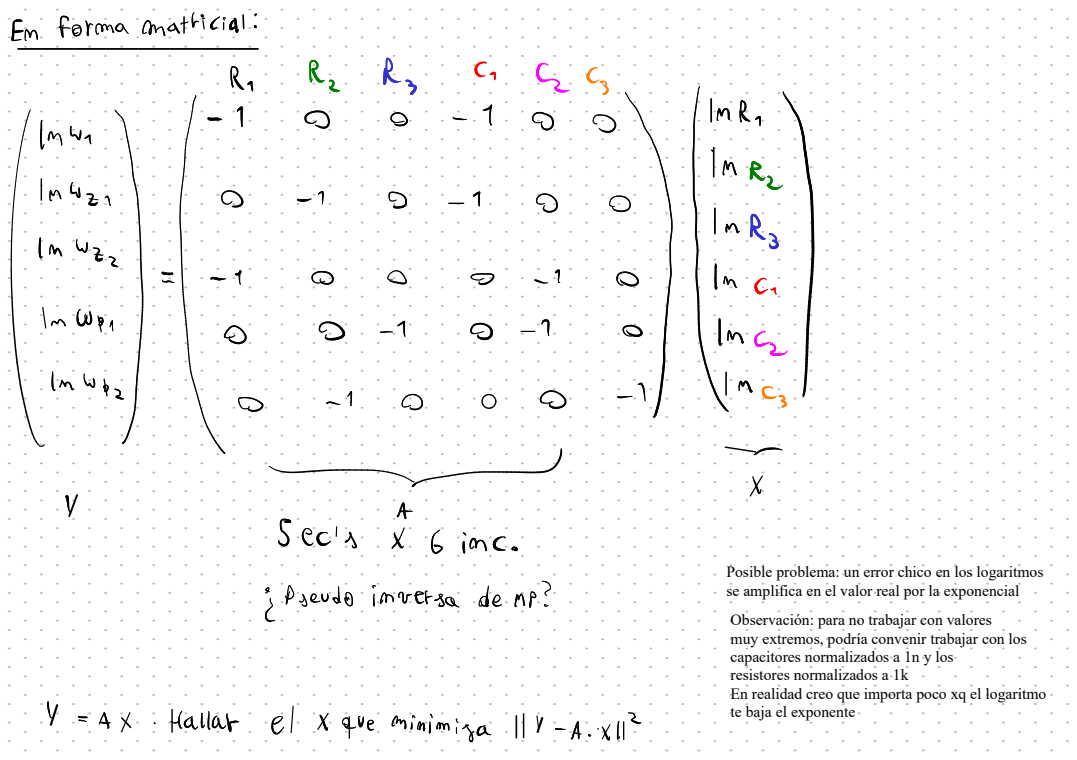
[picture p82: page 15]

Posible problema: un error chico en los logaritmos
se amplifica en el valor real por la exponencial
Observación: para no trabajar con valores
muy extremos, podría convenir trabajar con los
capacitores normalizados a 1n y los
resistores normalizados a 1k
En realidad creo que importa poco xq el logaritmo
te baja el exponente

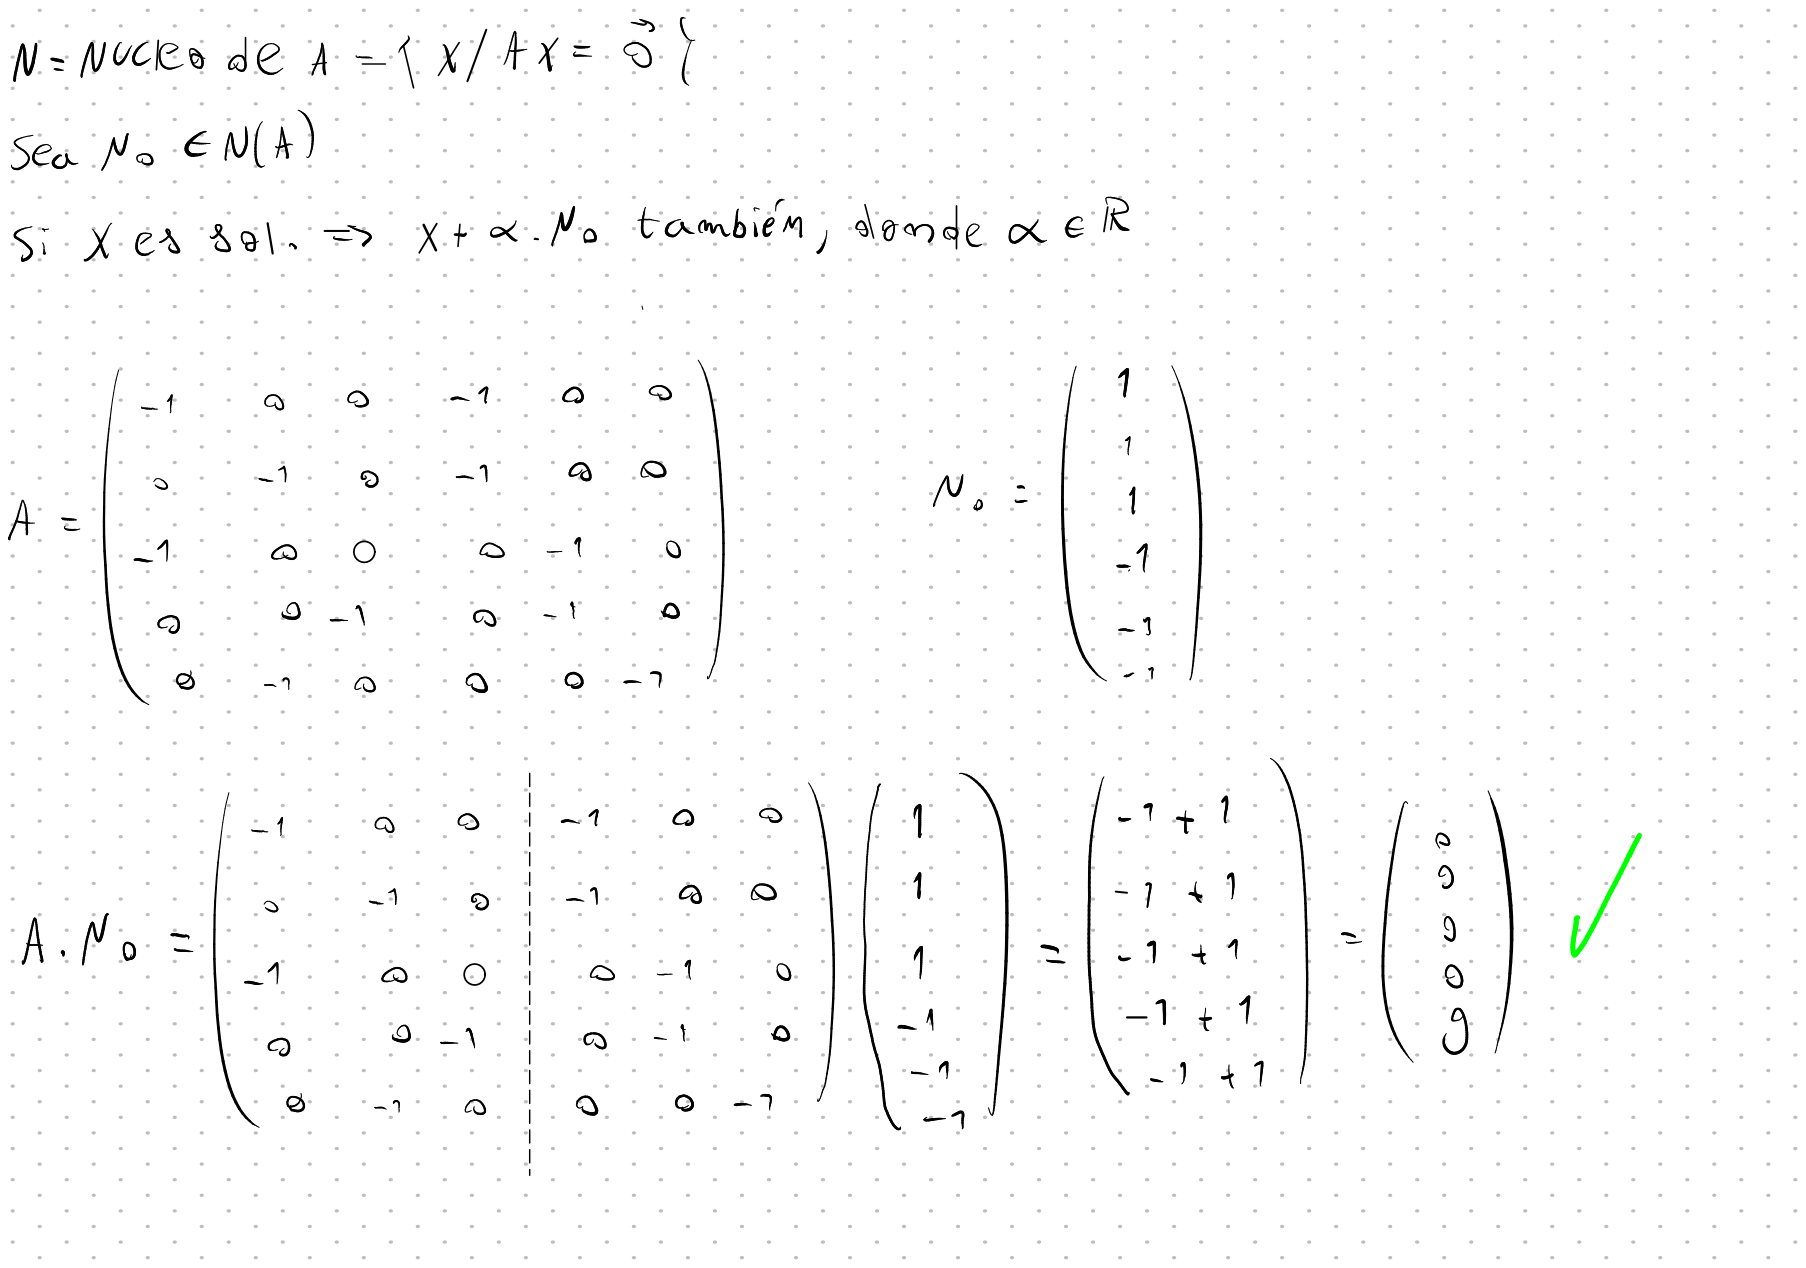
[picture p83: page 16]

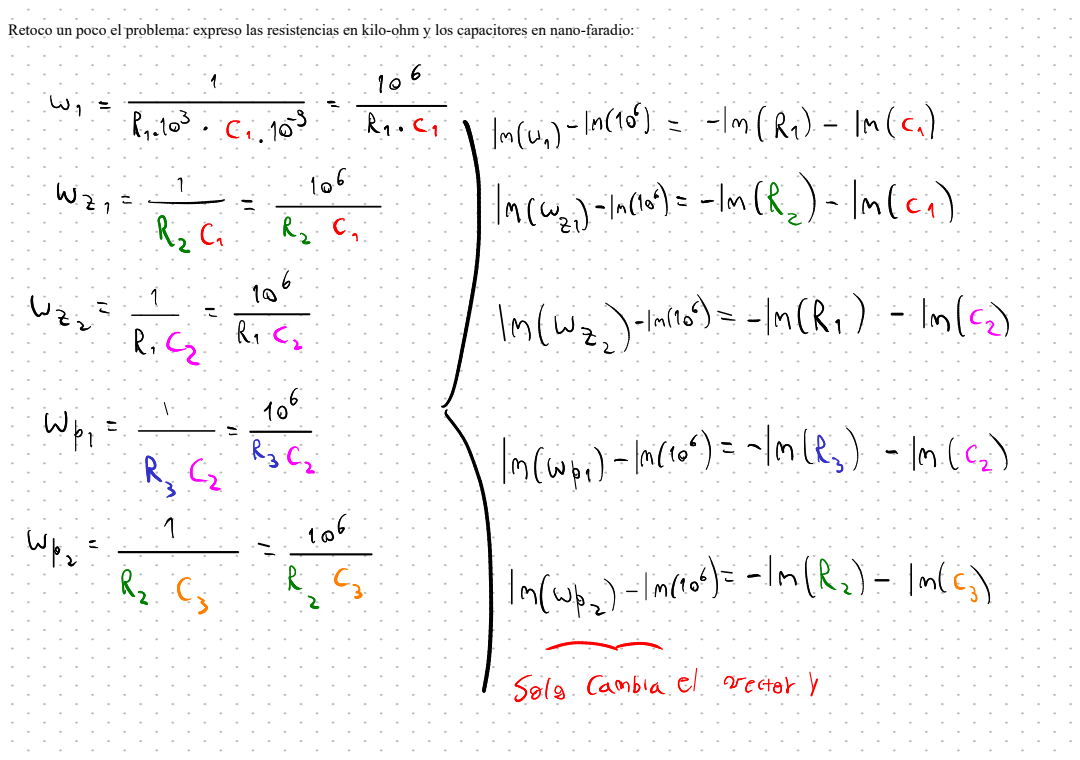
[picture p84: page 17]

Retoco un poco el problema: expreso las resistencias en kilo-ohm y los capacitores en nano-faradio:

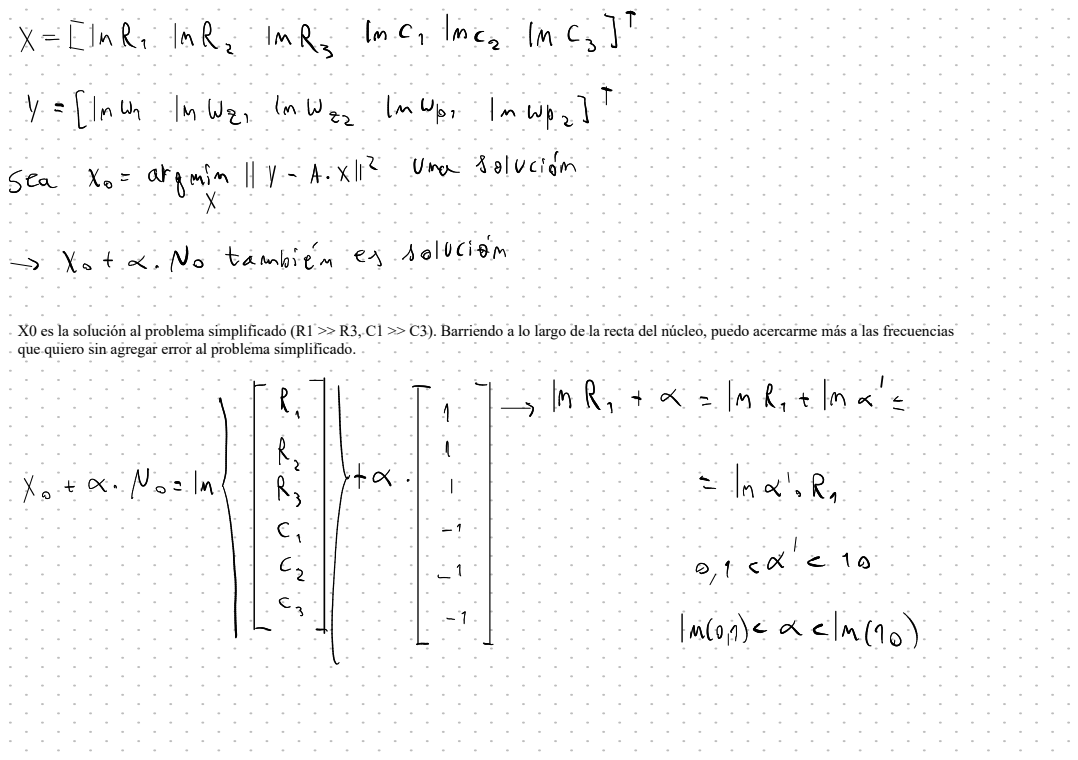
[picture p85: page 18]

X0 es la solución al problema simplificado (R1 >> R3, C1 >> C3). Barriendo a lo largo de la recta del núcleo, puedo acercarme más a las frecuencias
que quiero sin agregar error al problema simplificado.
