Fjmoya-uba/Taller-de-Circuitos-Grupo-5/Ckeckpoint 1/KiCAD/esquematico/esquematico.pdf

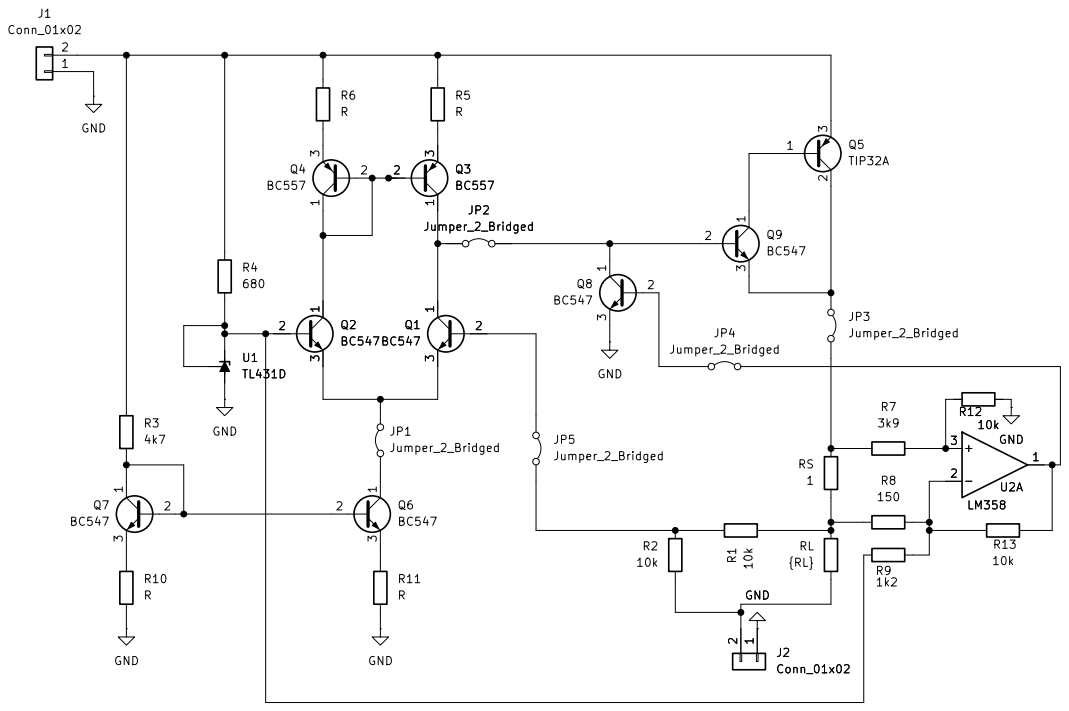
[picture p86: page 1]

Francisco Javier Moya - Padrón: 109899
Santiago Manuel Cabrera - Padrón: 110445
Lautaro García Vitale - Padrón: 110028
FIUBA - TA138
Sheet: /
D Date: 2026-04-10 KiCad E.D.A. 10.0.0
File: esquematico.kicad_sch
Title: Fuente Regulada con Protección Foldback - Grupo 5

Size: A4 | Rev:
