Fjmoya-uba/Taller-de-Circuitos-Grupo-5/Checkpoint 5/Informe/img/PCB/Circuito final.pdf

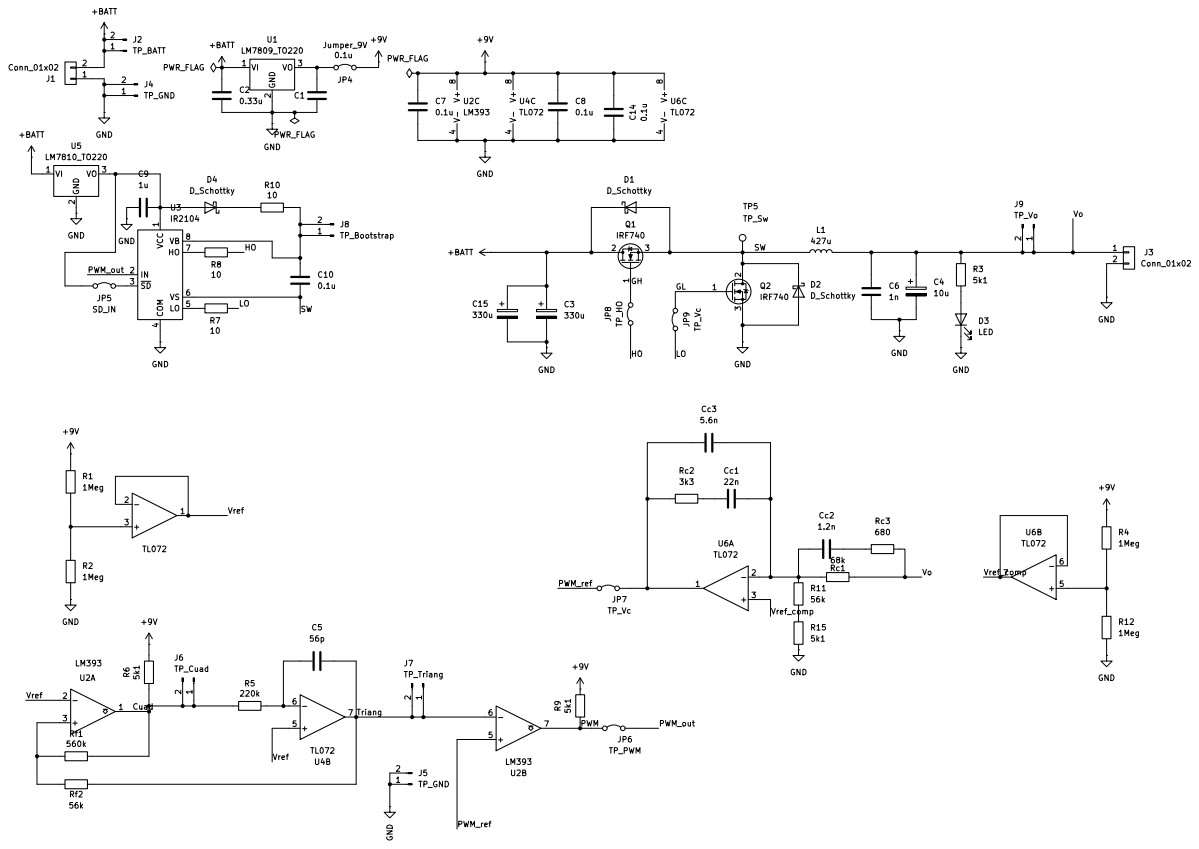
[picture p87: page 1]
