Fjmoya-uba/Taller-de-Circuitos-Grupo-5/Ckeckpoint 1/Foldback.pdf

# Regulador lineal

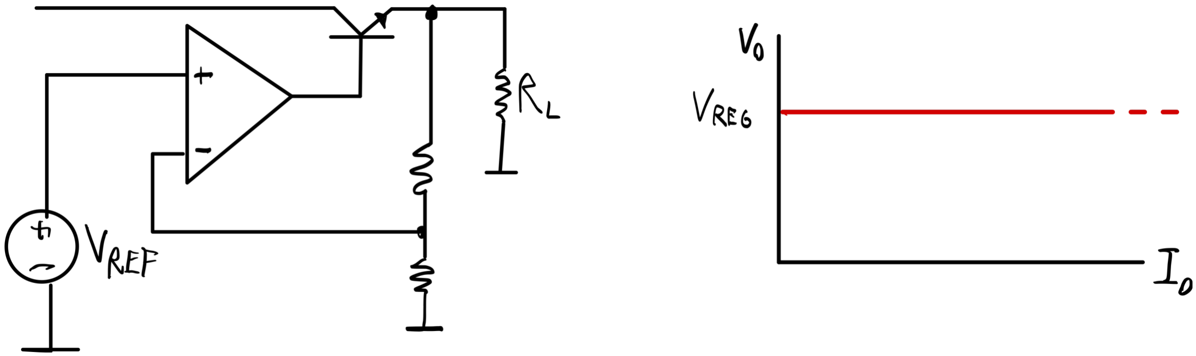
[picture p88: figure]

# Limitador de corriente

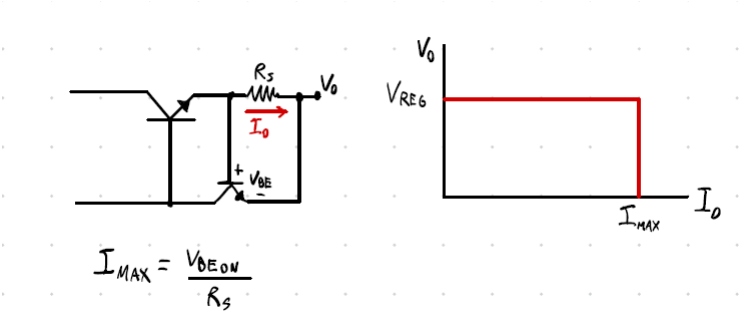
[picture p89: figure]

# Foldback

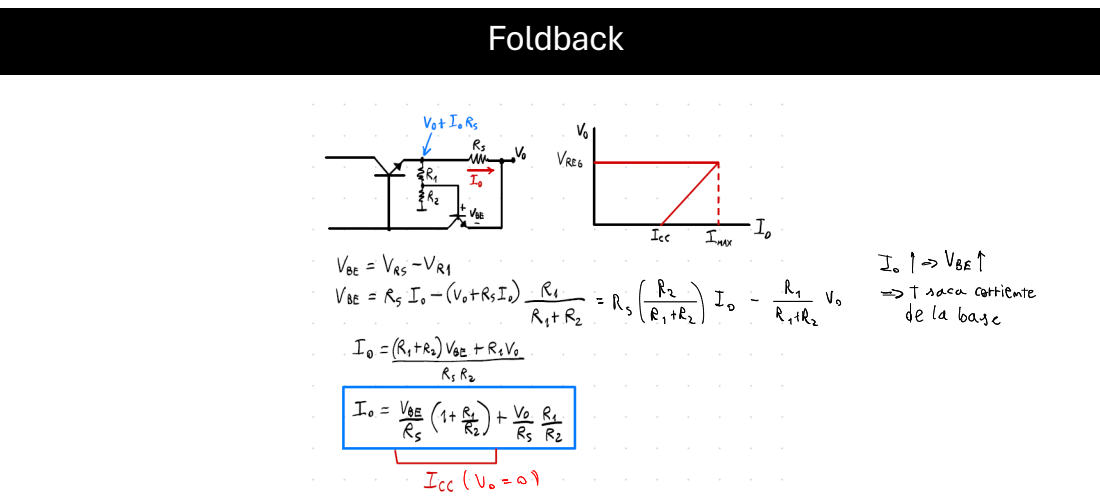
[picture p90: page 3]

# Calculos

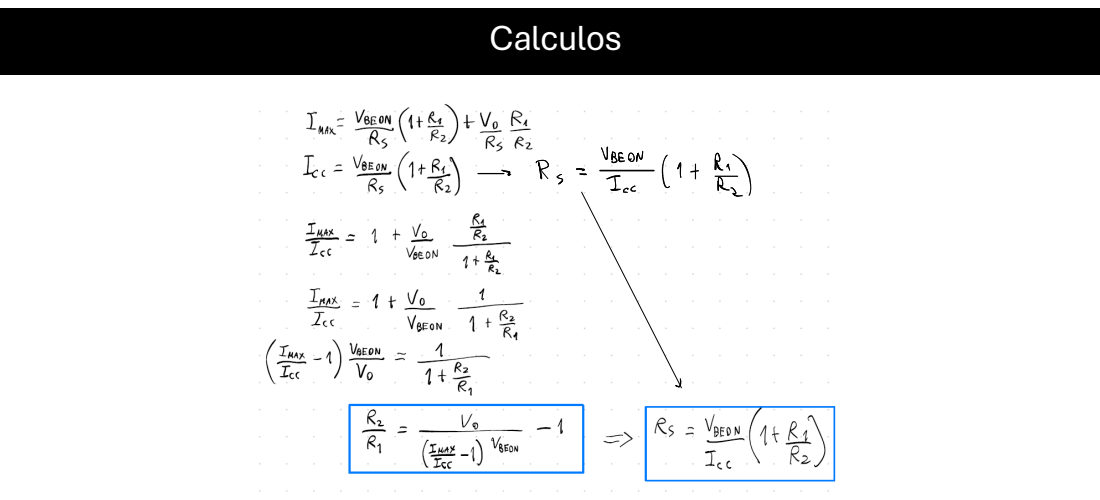
[picture p91: page 4]

# Sensor de corriente

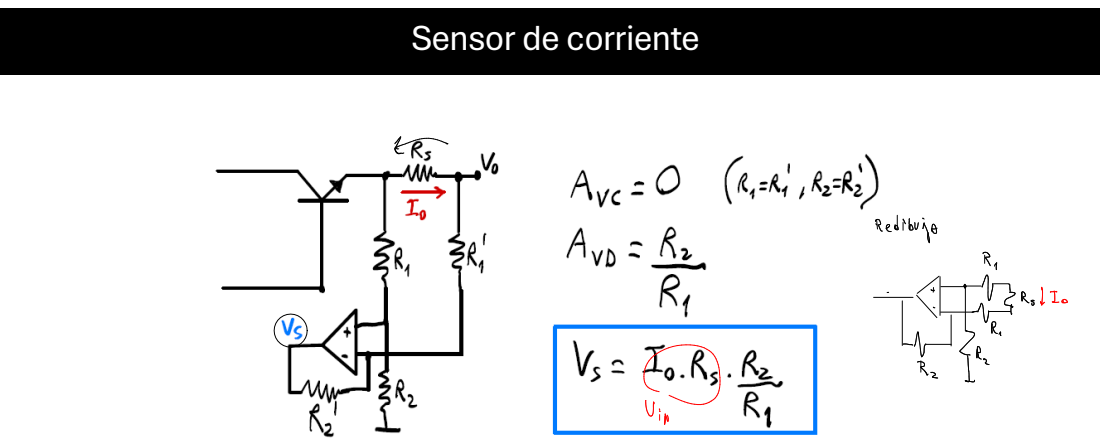
[picture p92: page 5]

# Limitador de corriente

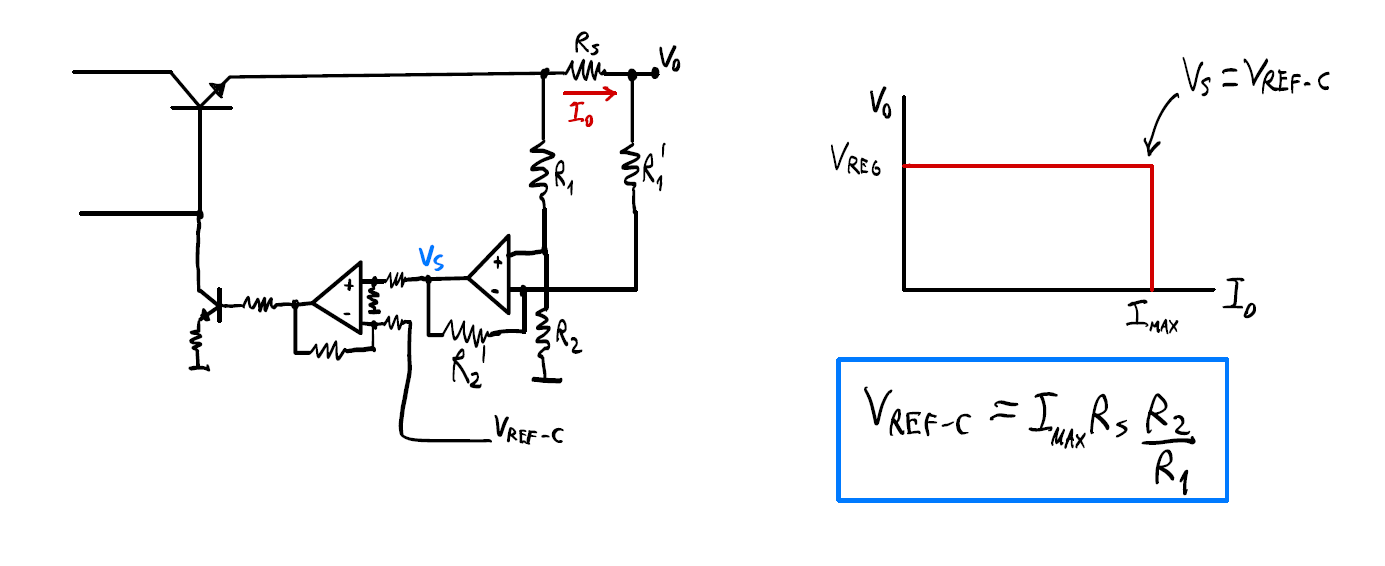
[picture p93: figure]

# Foldback

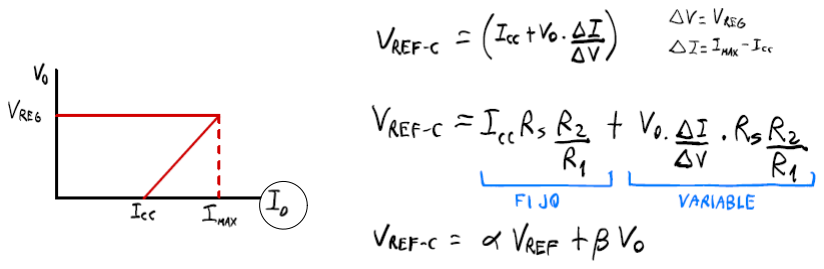
[picture p94: figure]

# Ejemplo

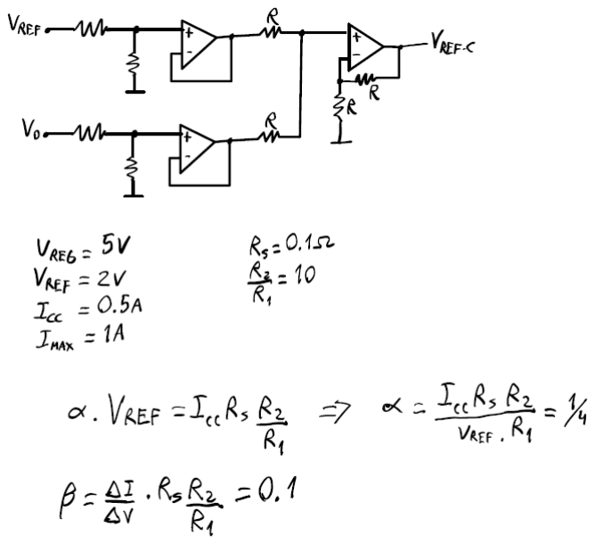
[picture p95: figure]

# Implementacion

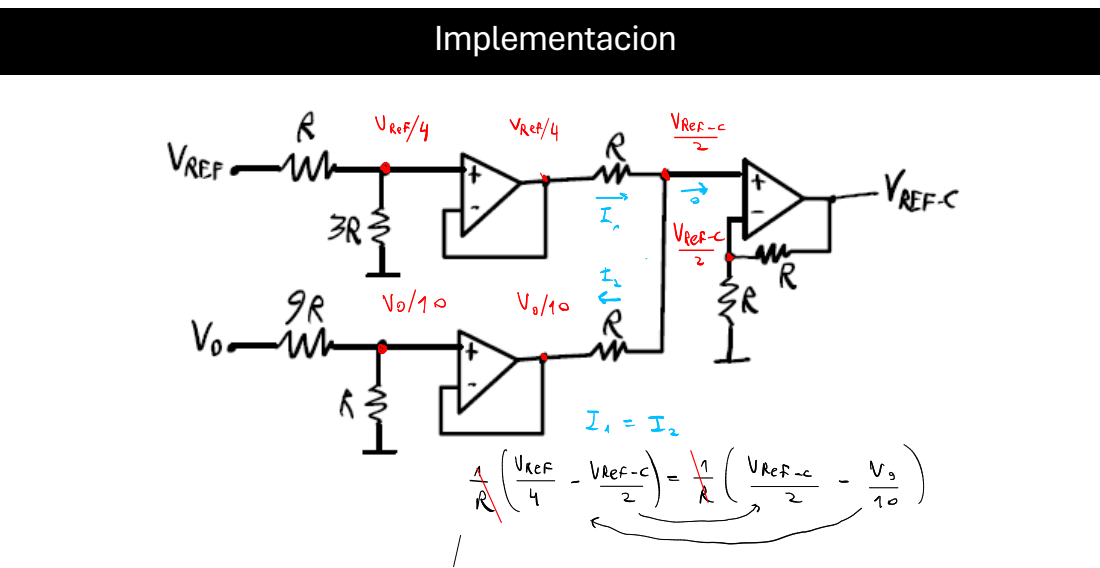
[picture p96: page 9]

# Consideraciones

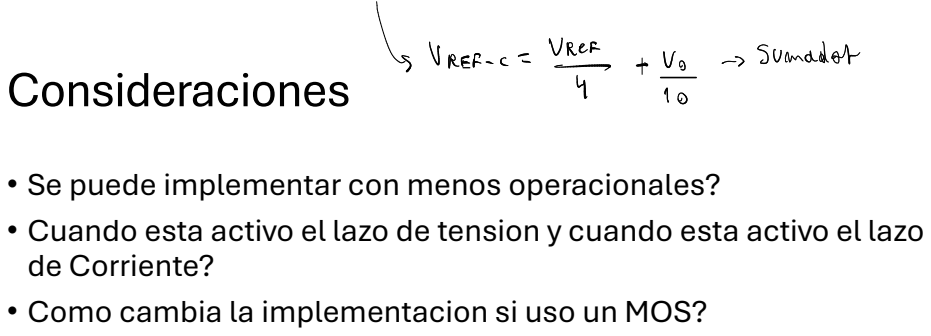
[picture p97: page 10]

• Se puede implementar con menos operacionales?
• Cuando esta activo el lazo de tension y cuando esta activo el lazo
de Corriente?
• Como cambia la implementacion si uso un MOS?

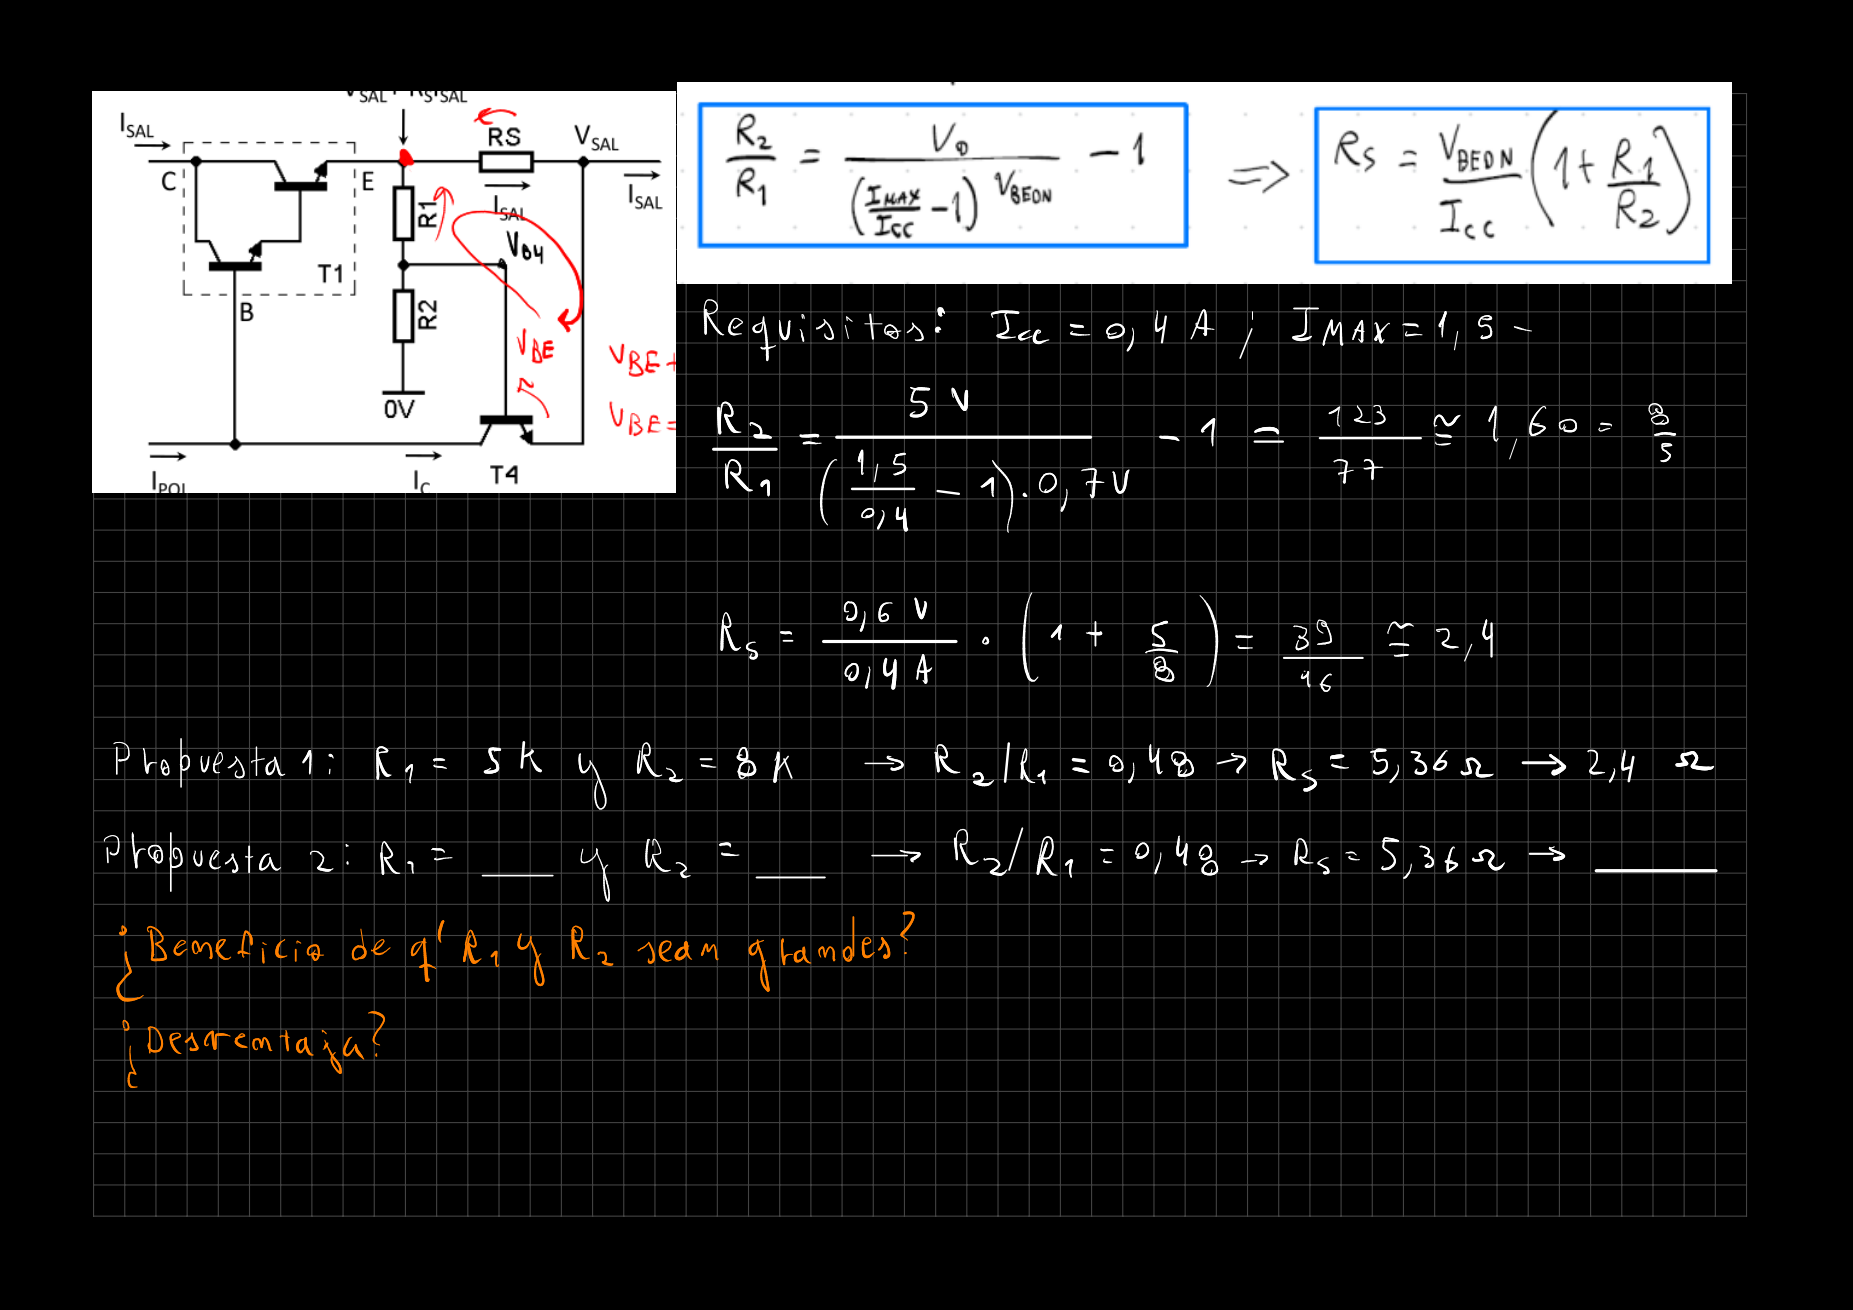
[picture p98: page 11]

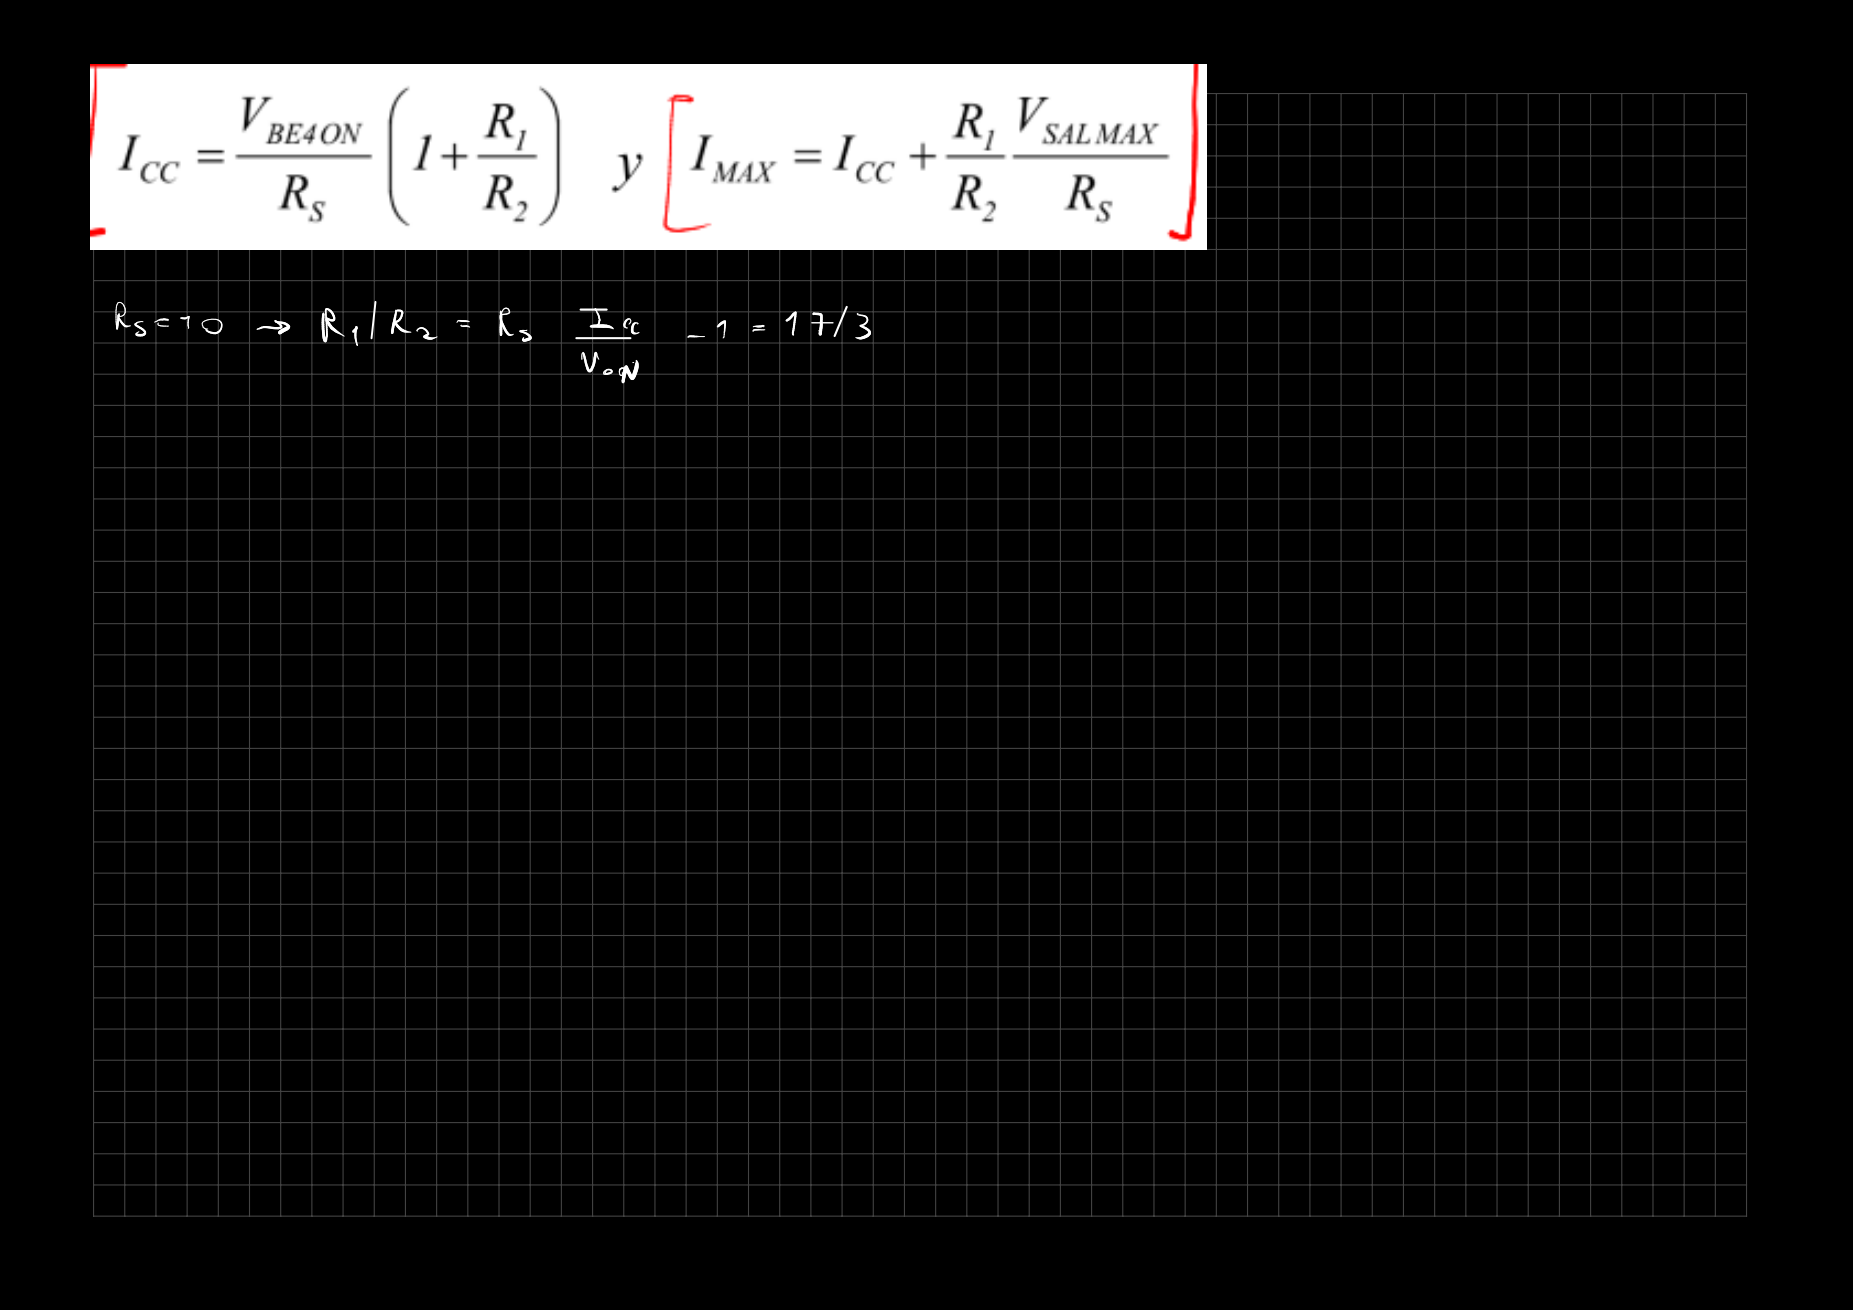
[picture p99: page 12]

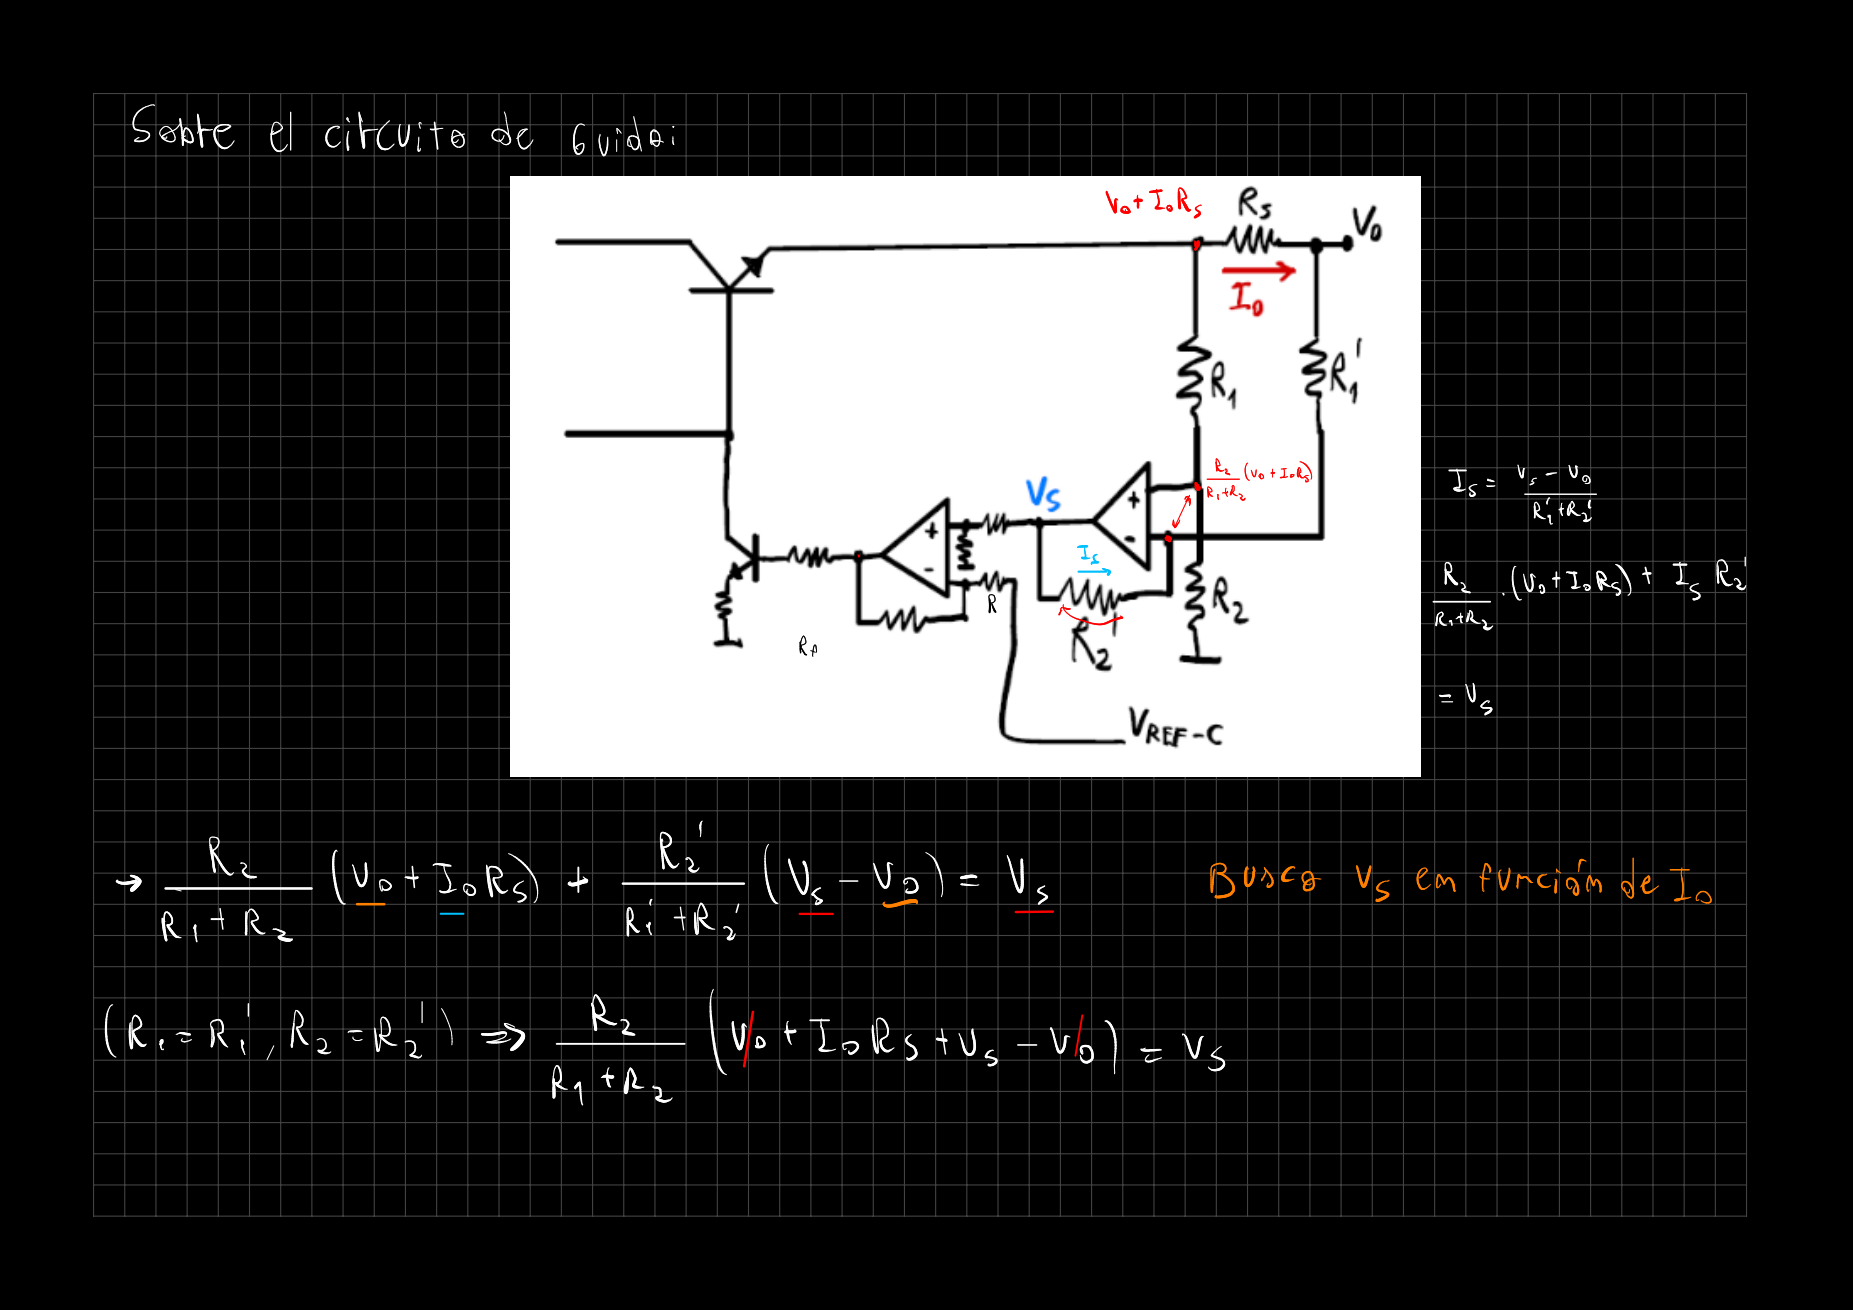
[picture p100: page 13]

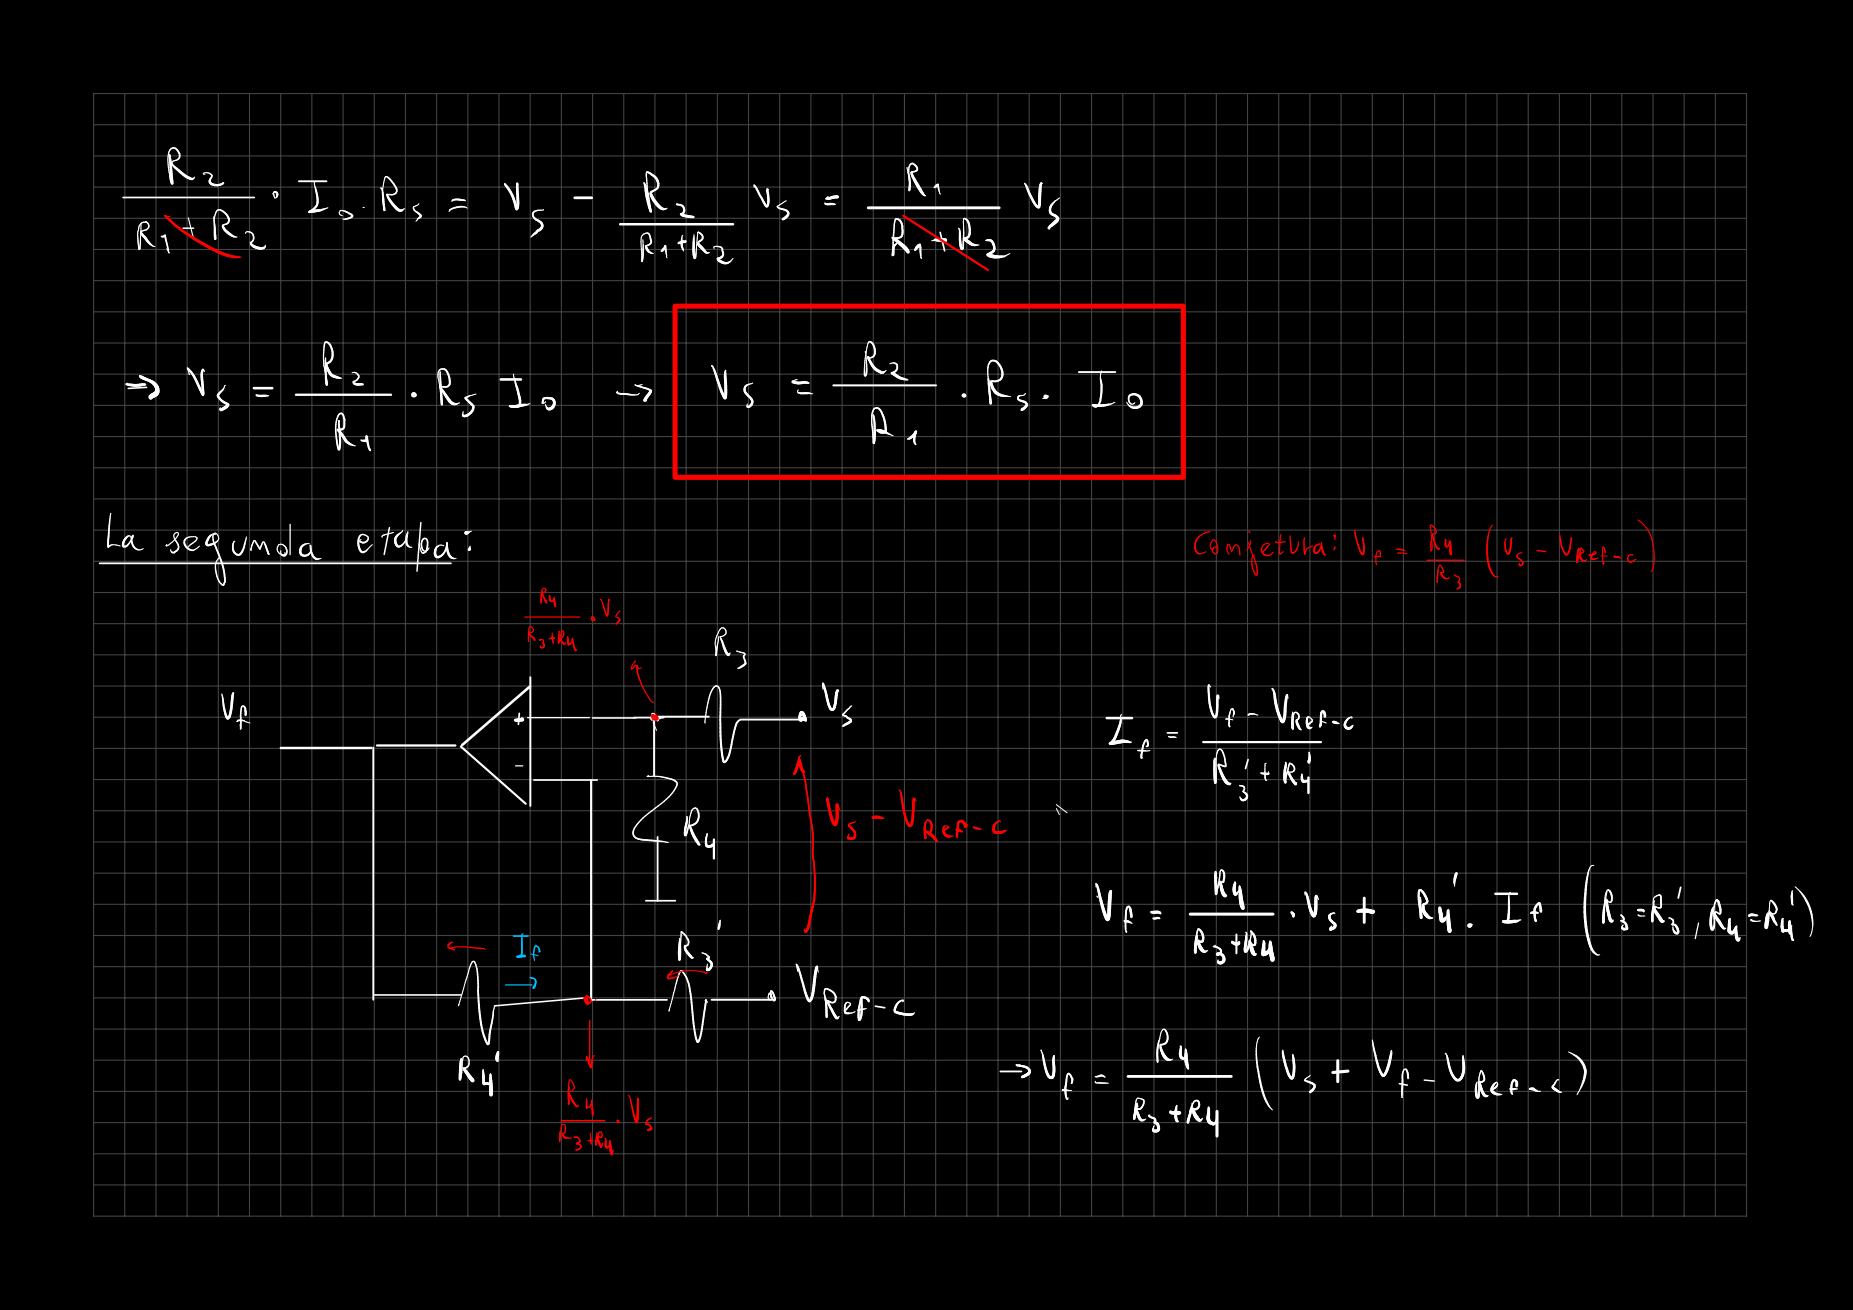
[picture p101: page 14]

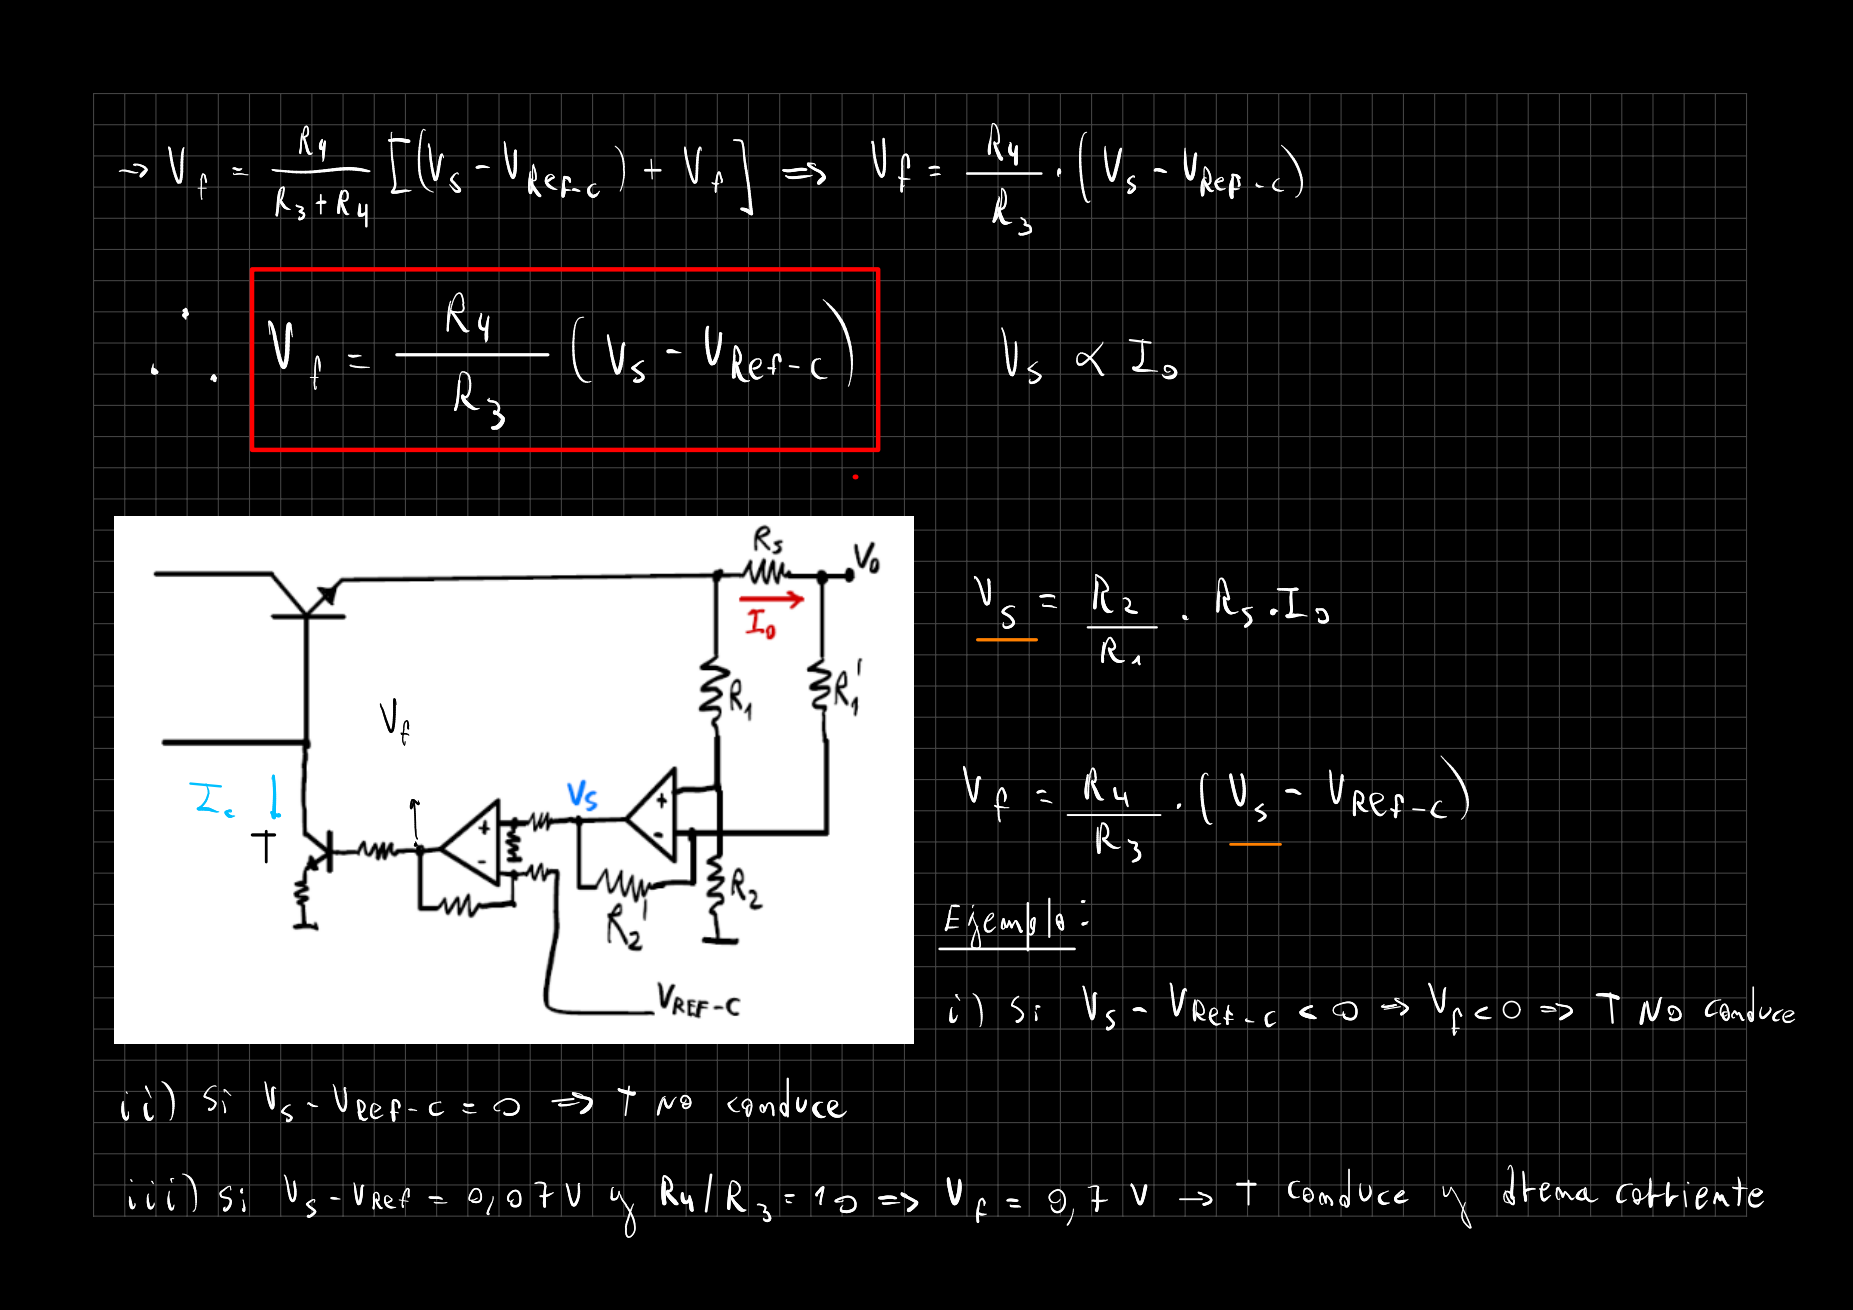
[picture p102: page 15]

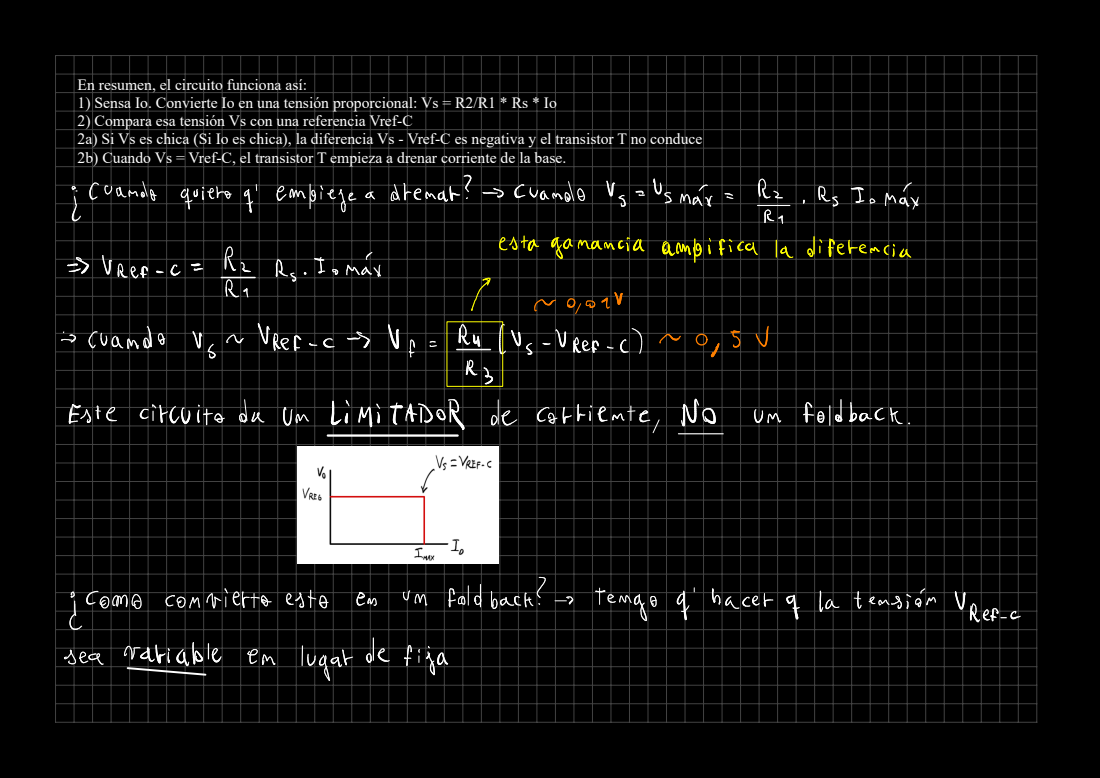
[picture p103: page 16]

En resumen, el circuito funciona así:
1) Sensa Io. Convierte Io en una tensión proporcional: Vs = R2/R1 * Rs * Io
2) Compara esa tensión Vs con una referencia Vref-C
2a) Si Vs es chica (Si Io es chica), la diferencia Vs - Vref-C es negativa y el transistor T no conduce
2b) Cuando Vs = Vref-C, el transistor T empieza a drenar corriente de la base.

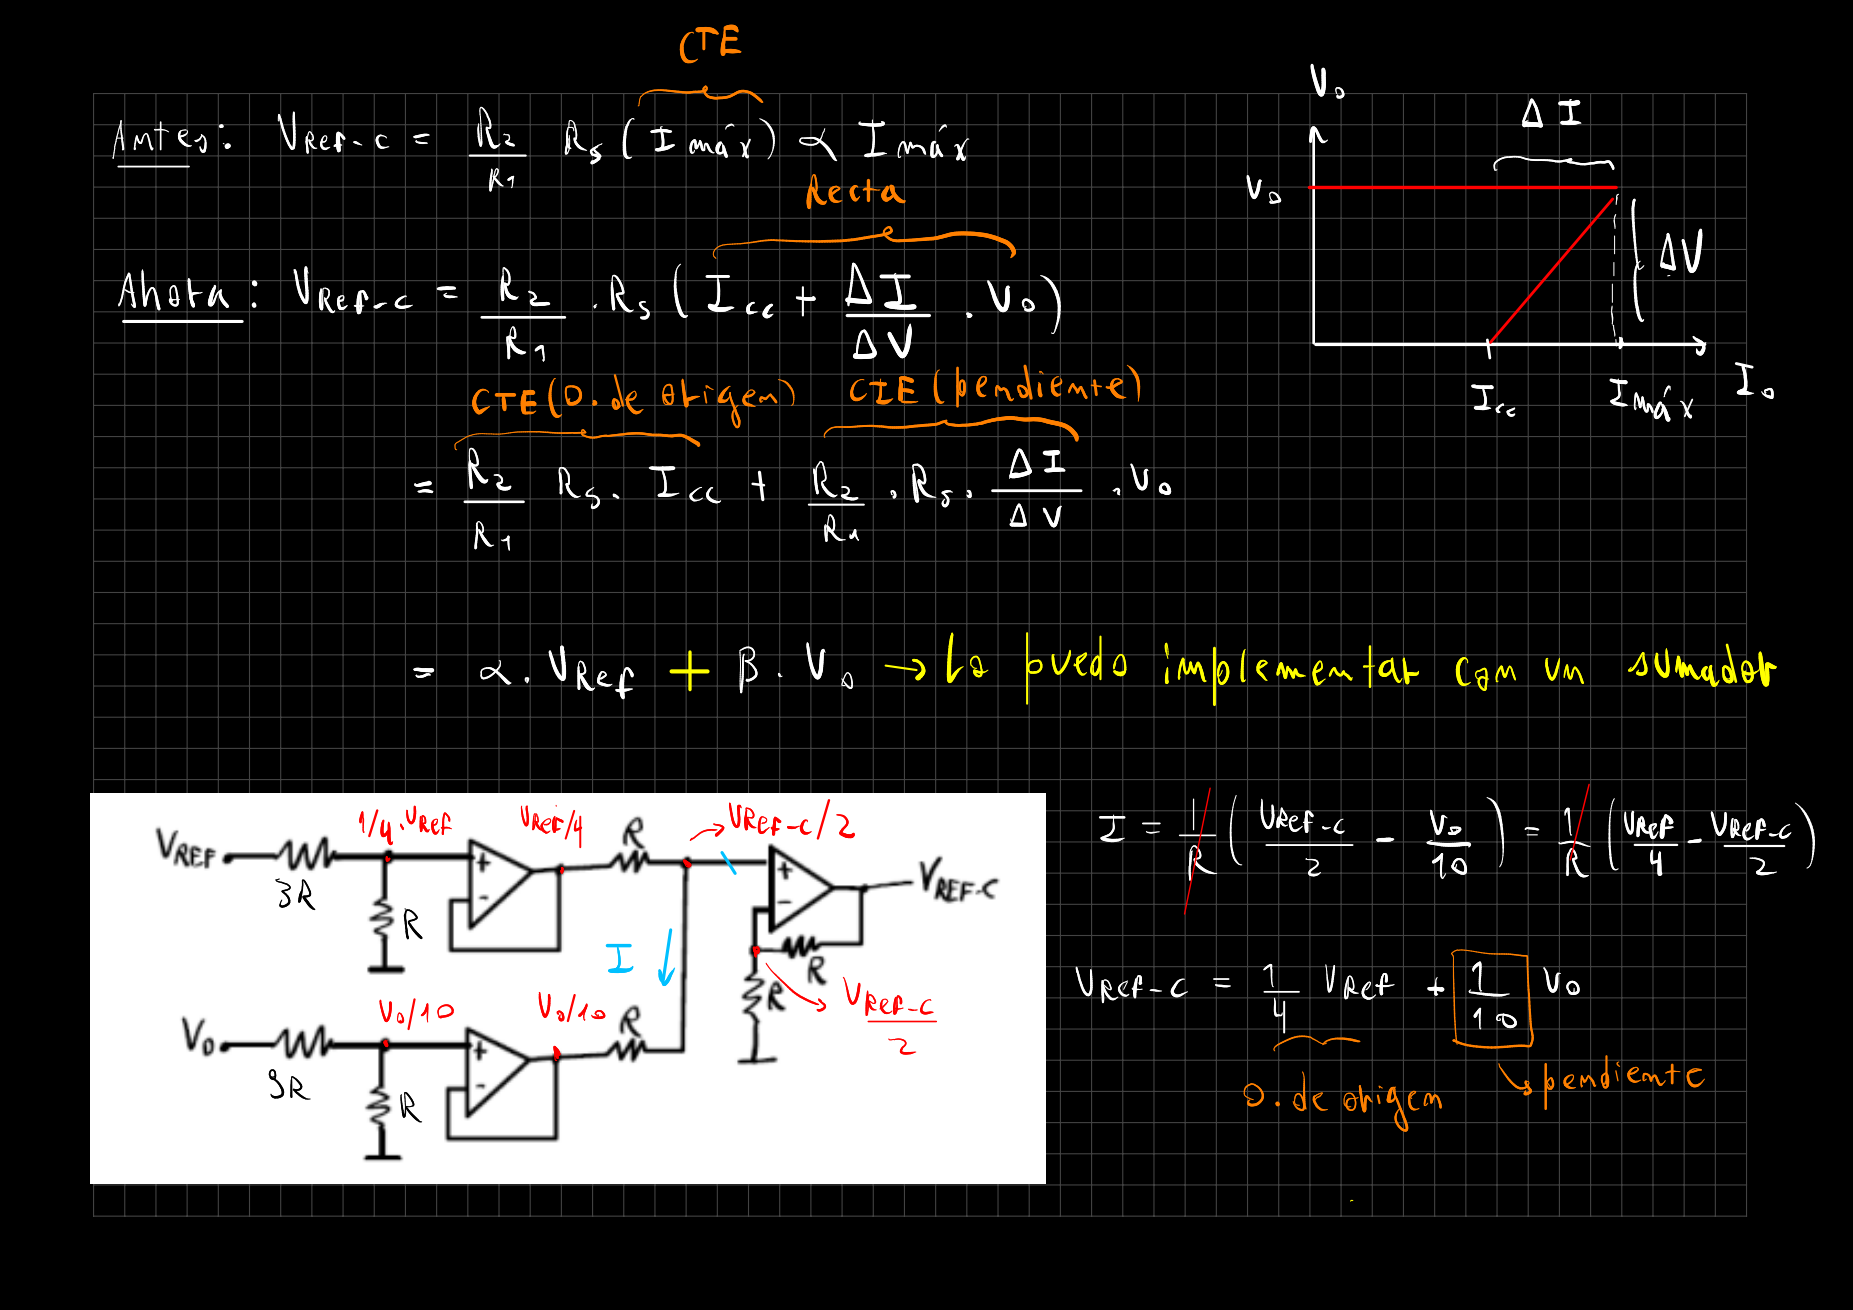
[picture p104: page 17]

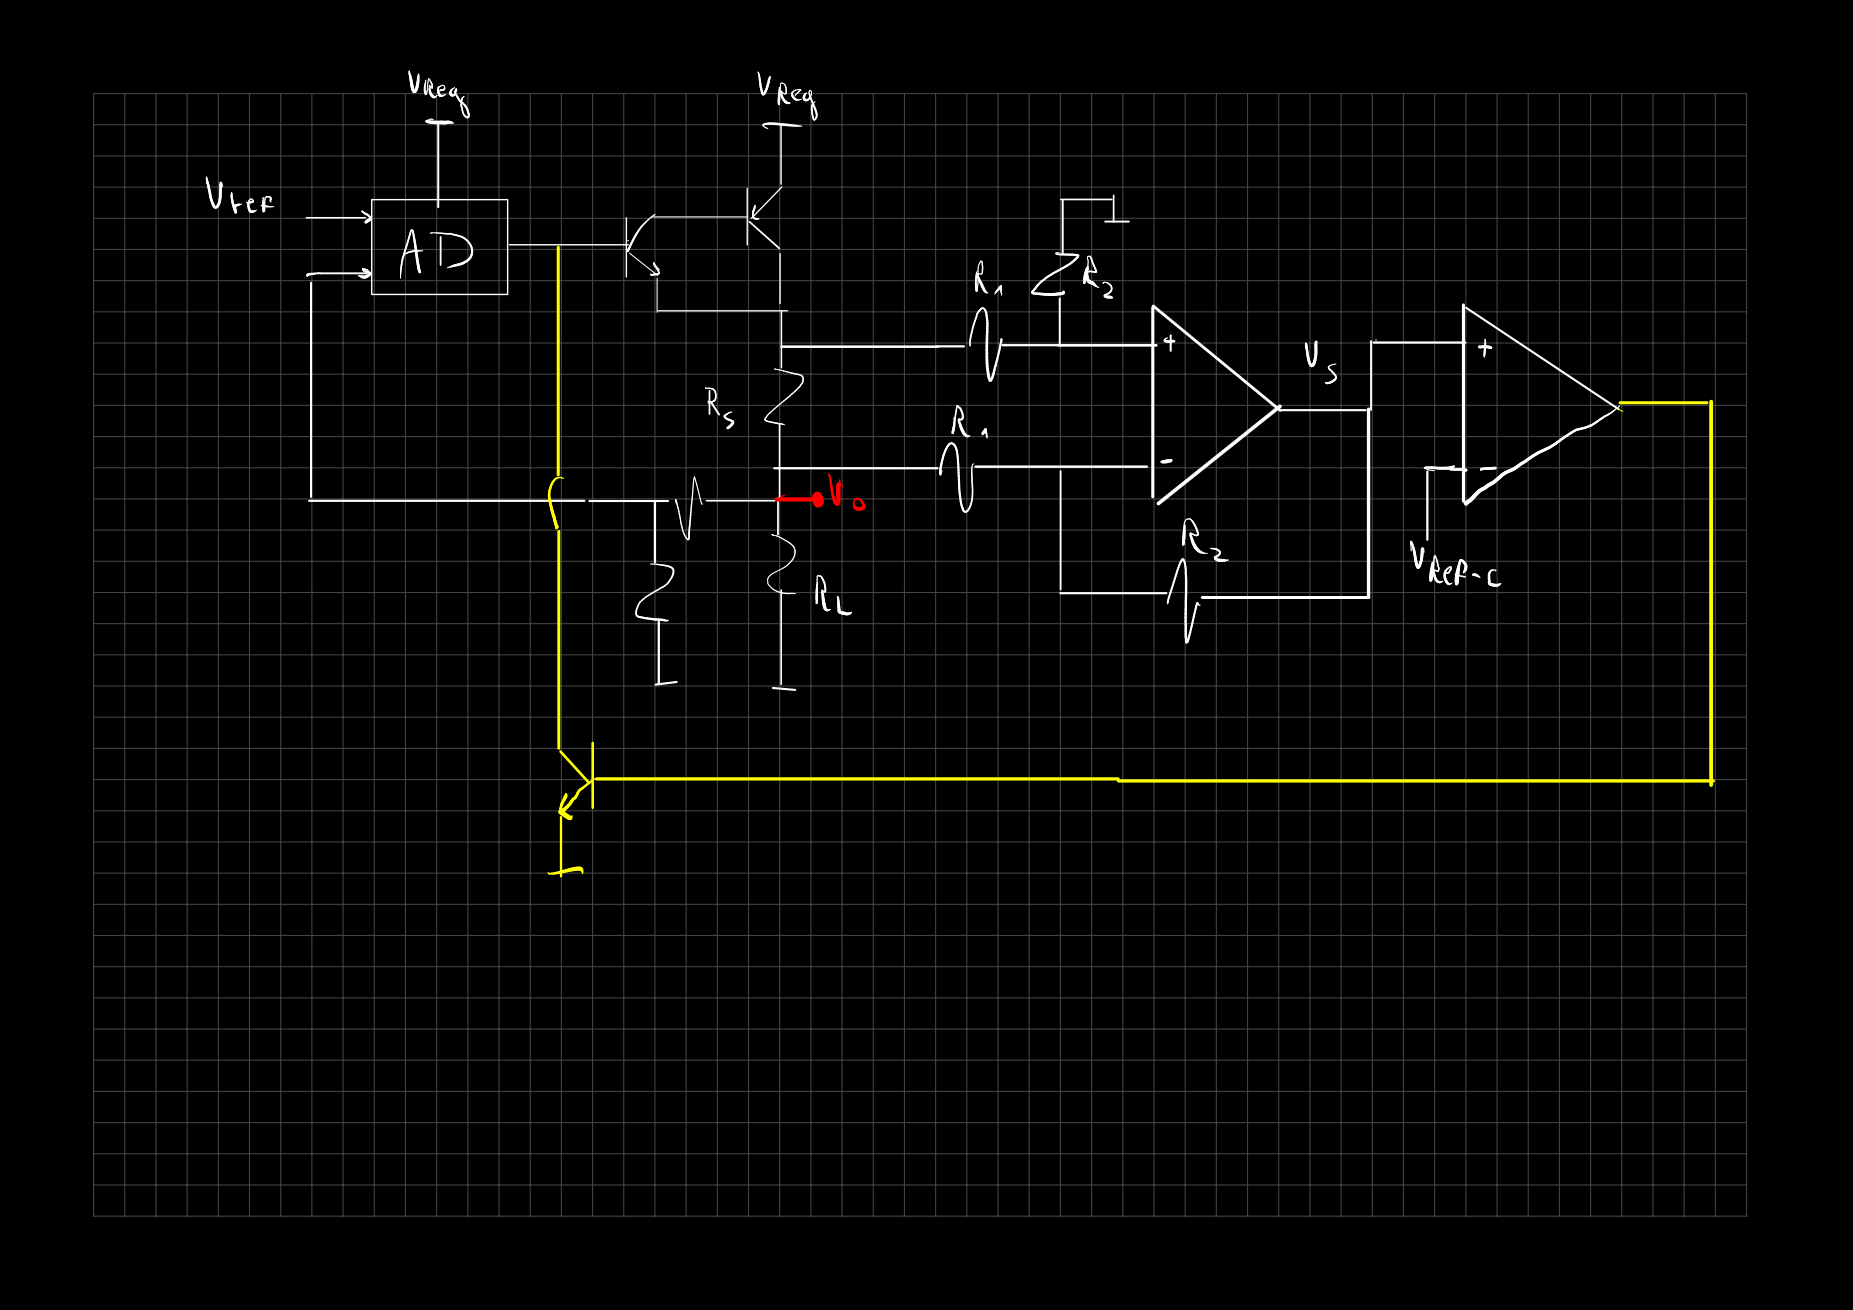
[picture p105: page 18]

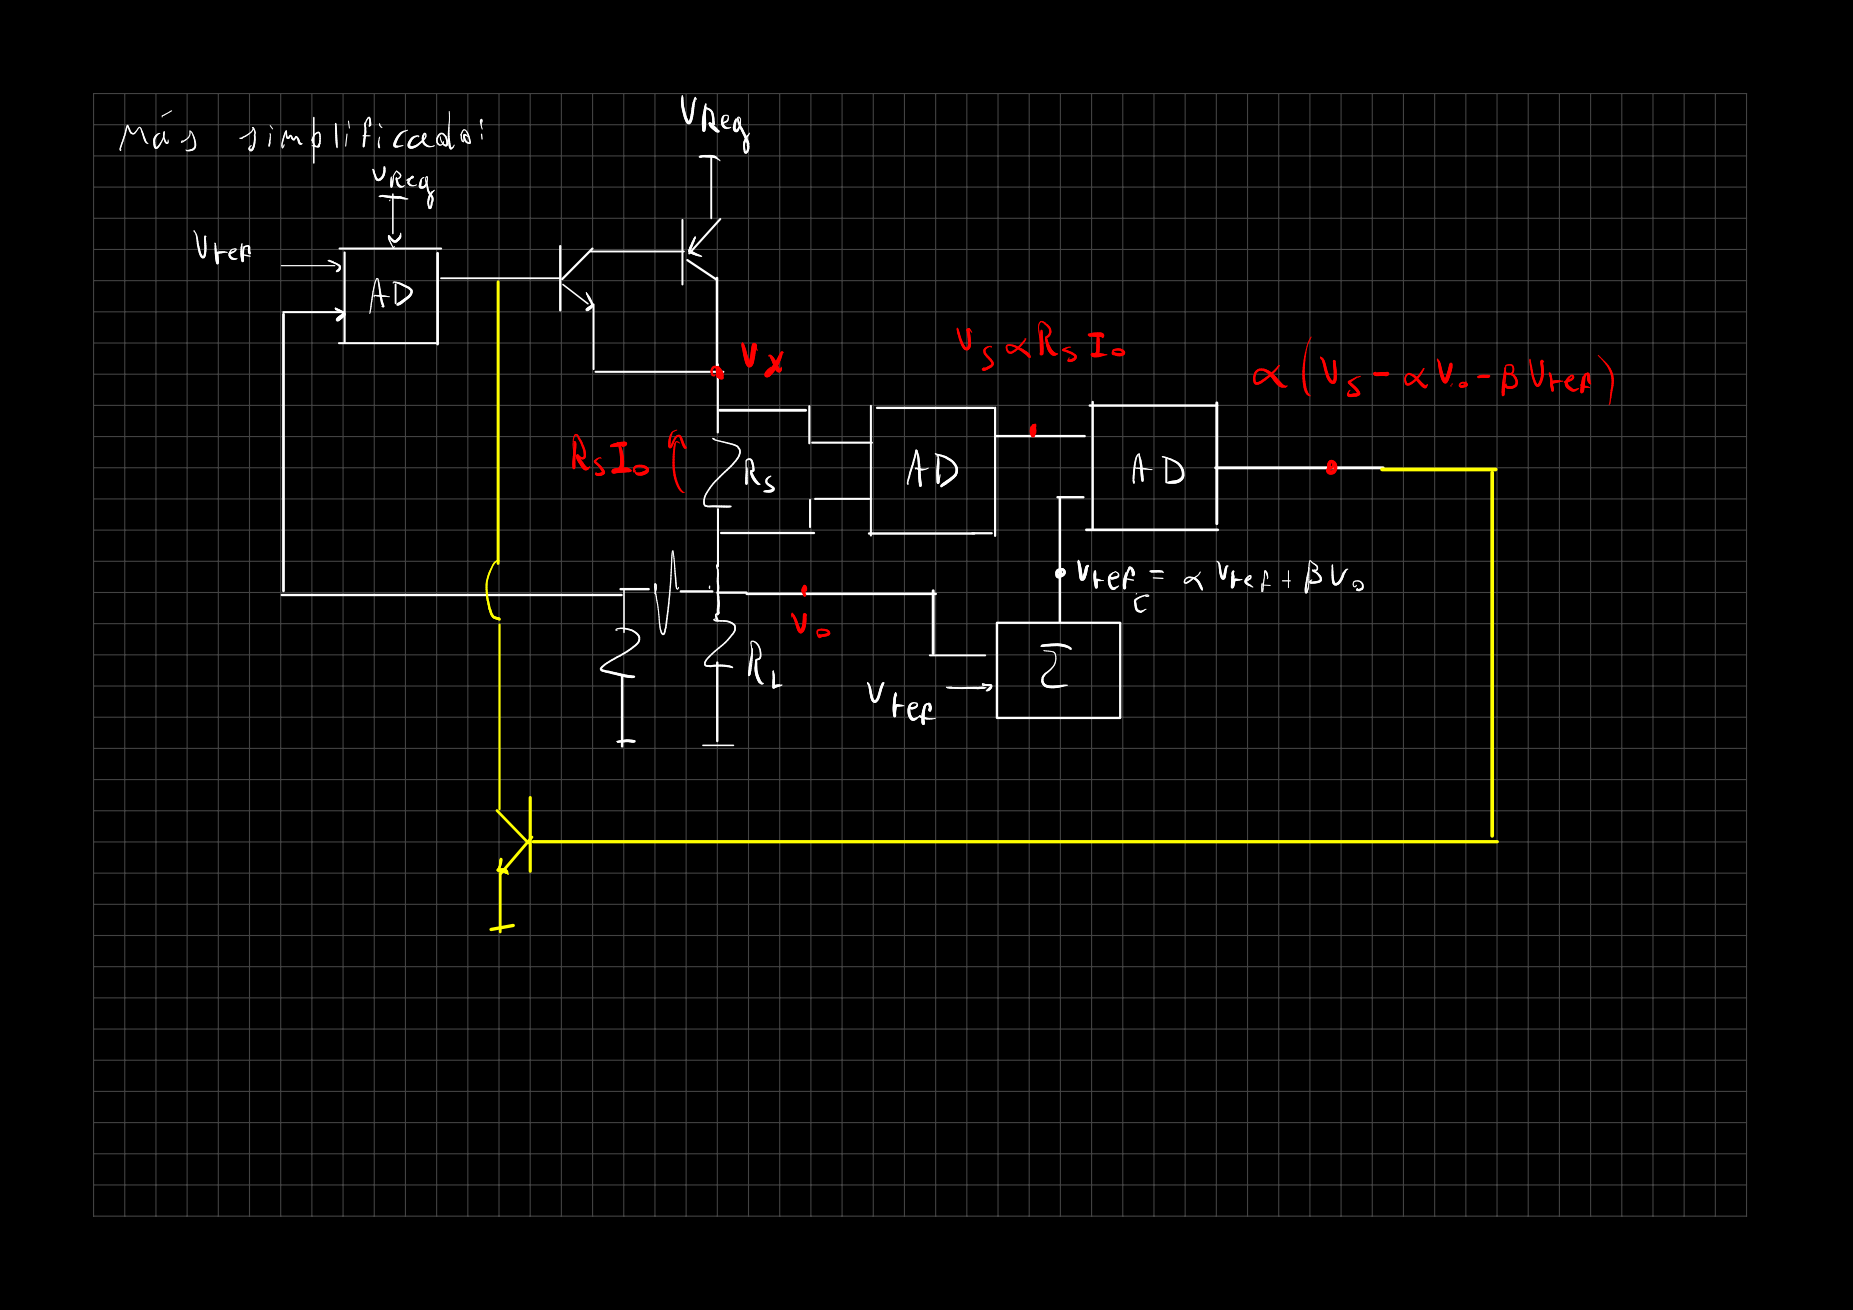
[picture p106: page 19]

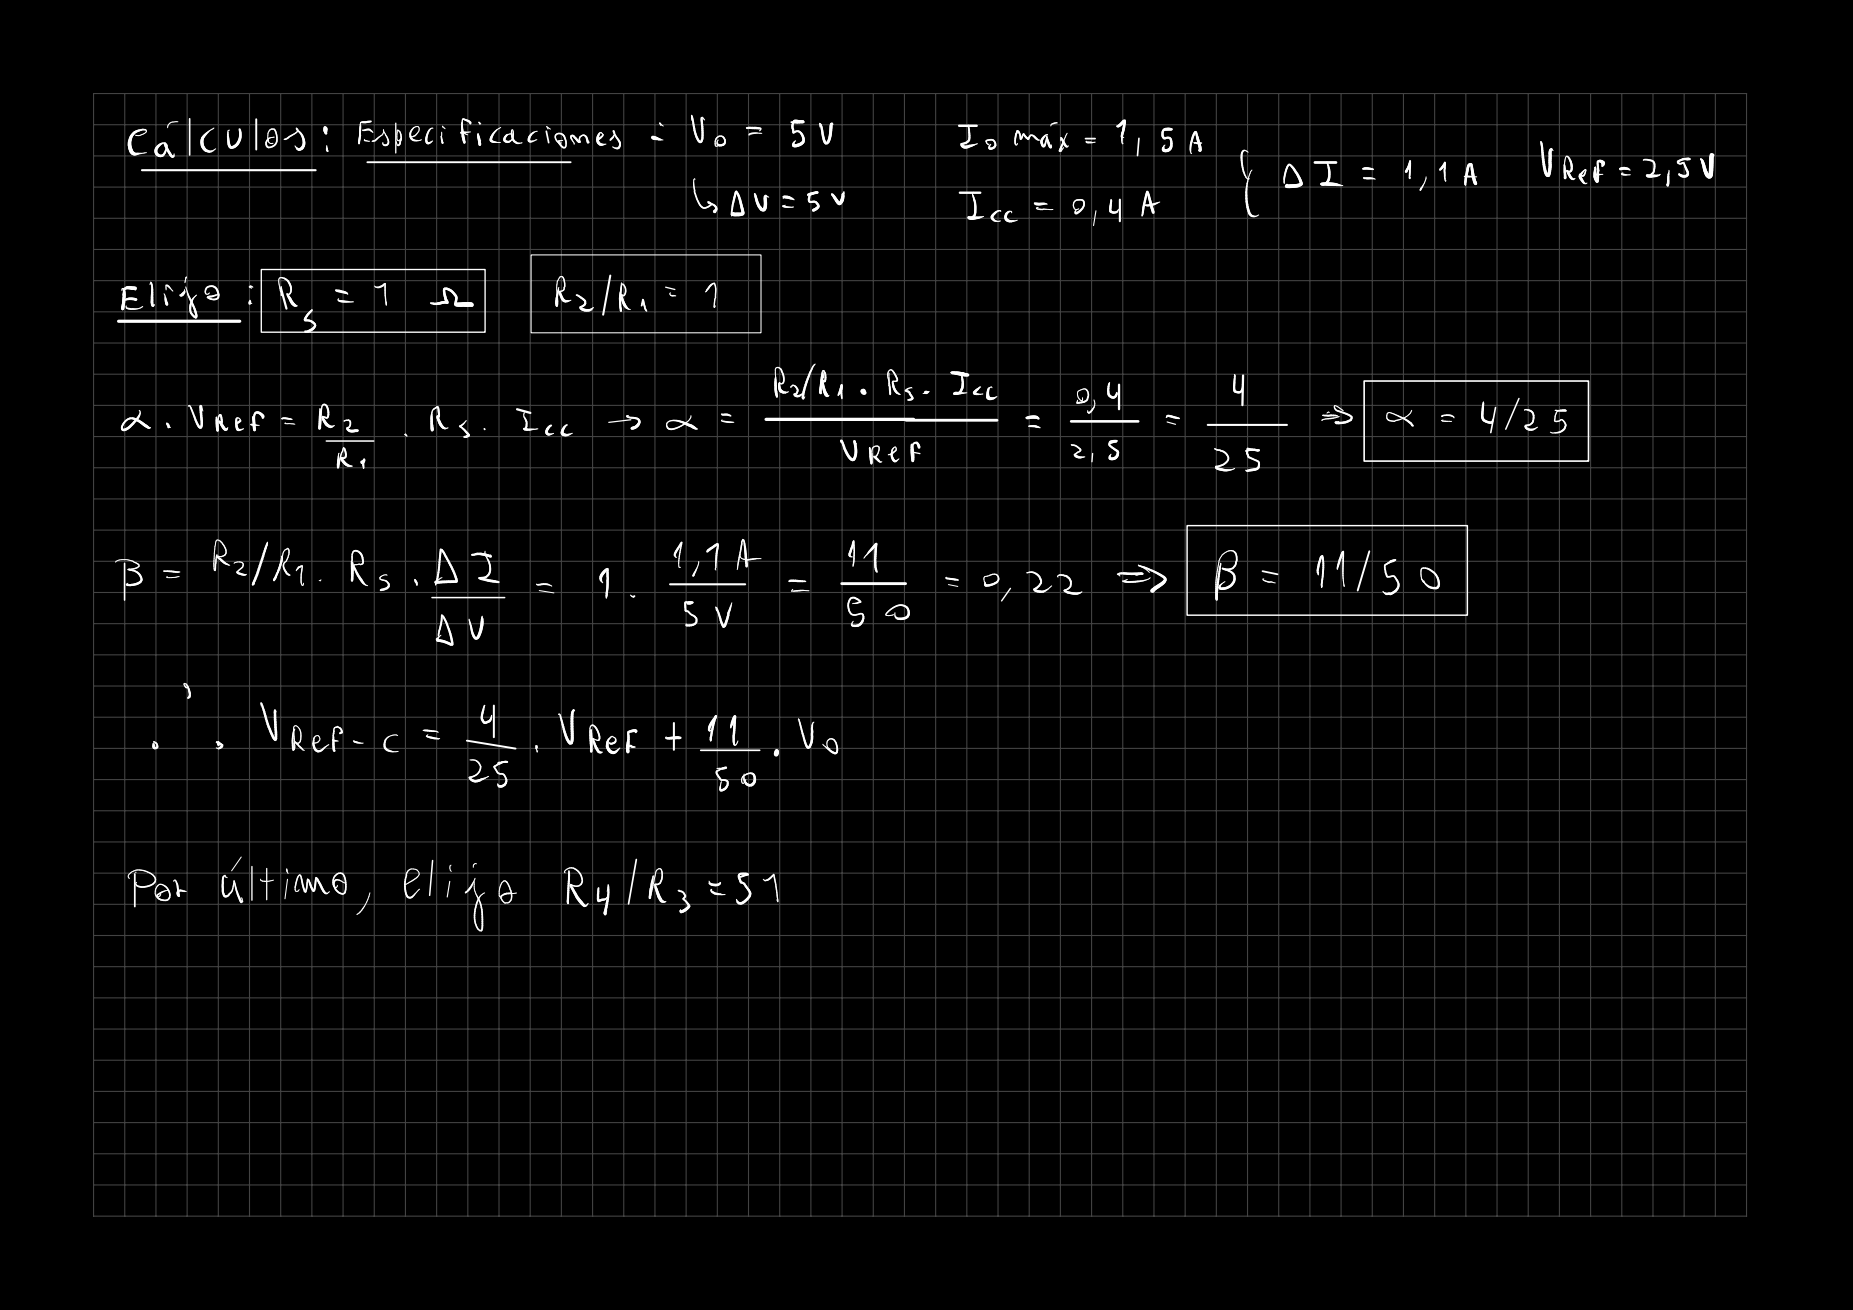
[picture p107: page 20]

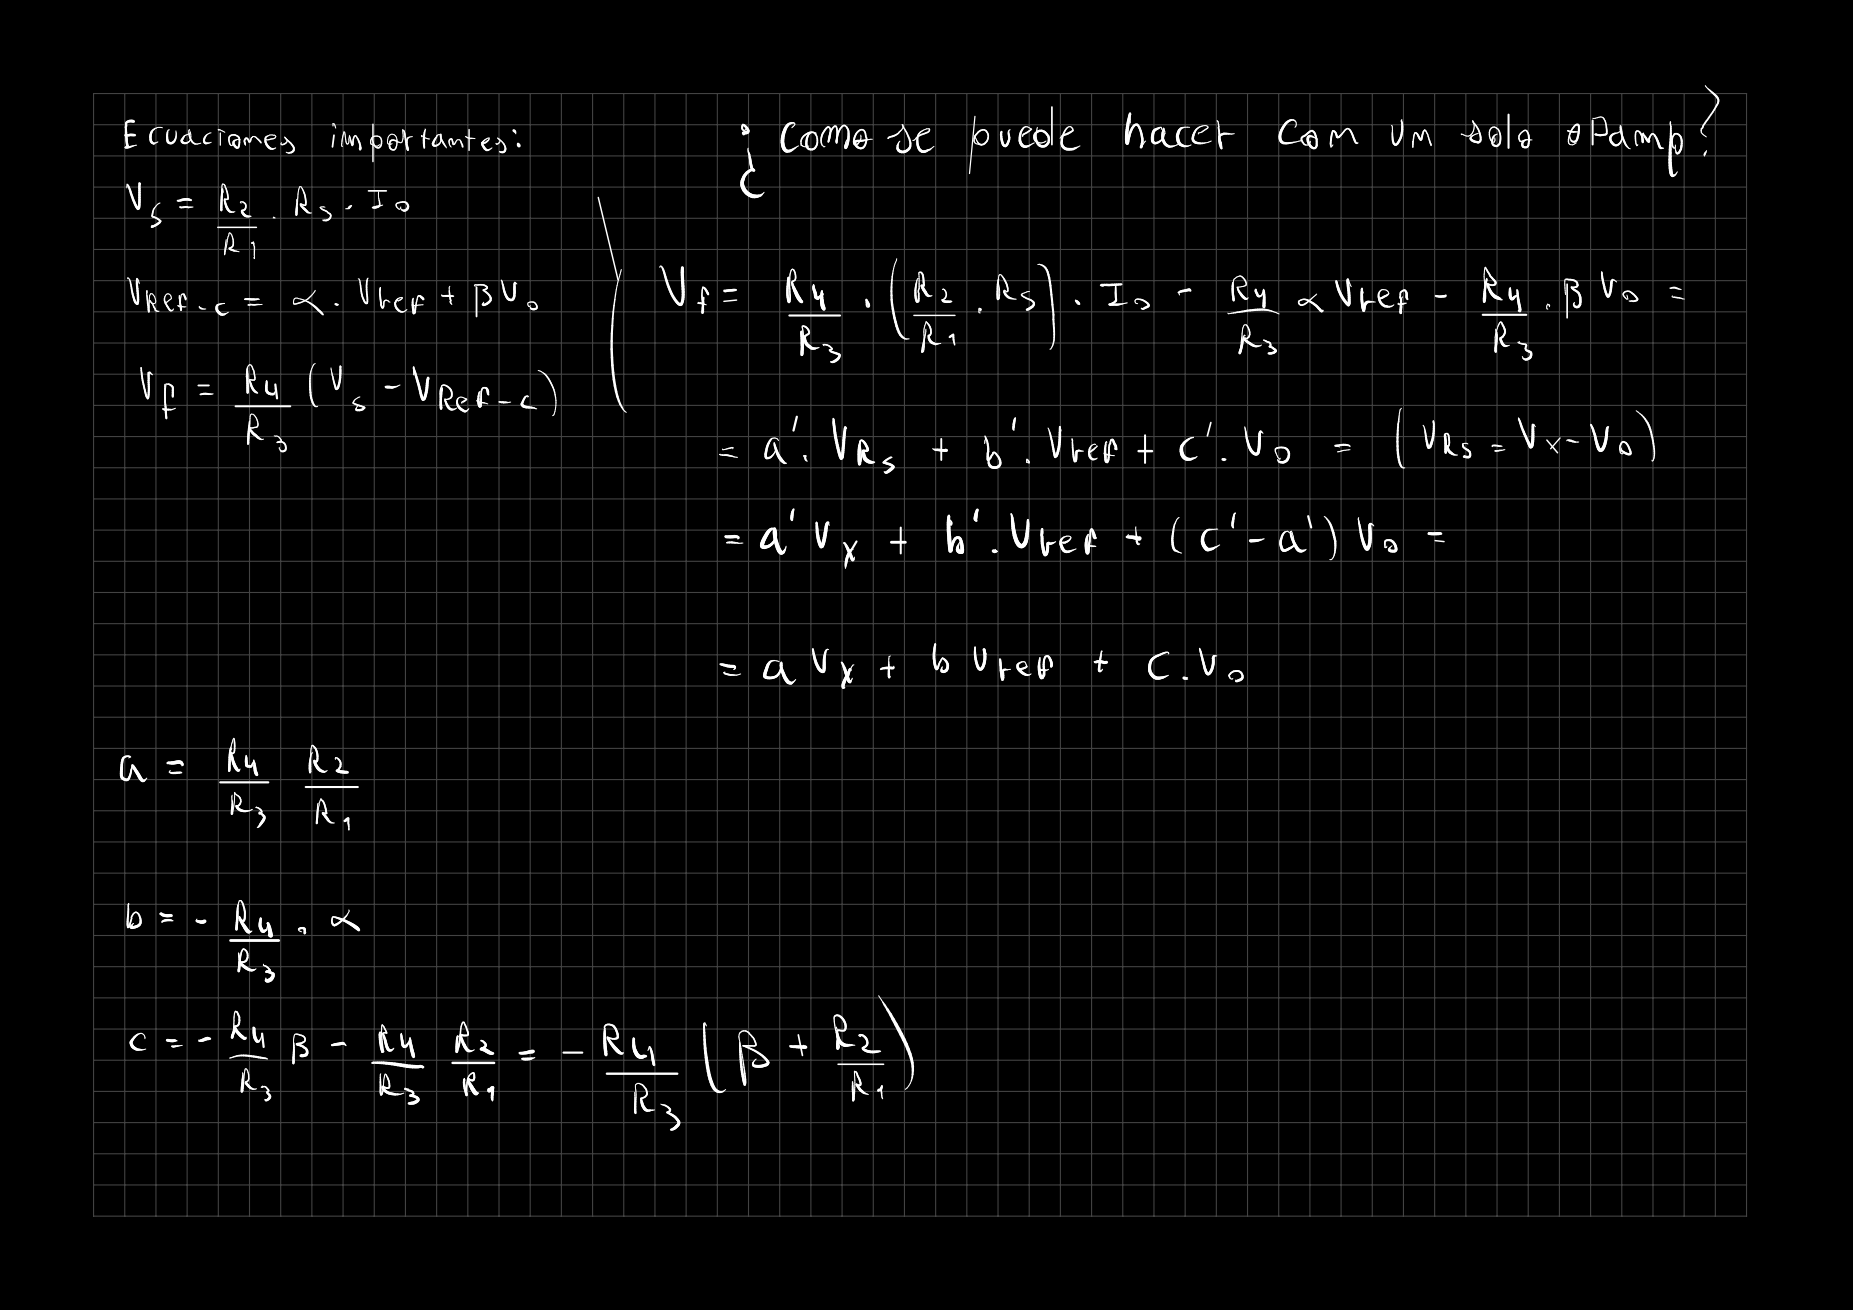
[picture p108: page 21]

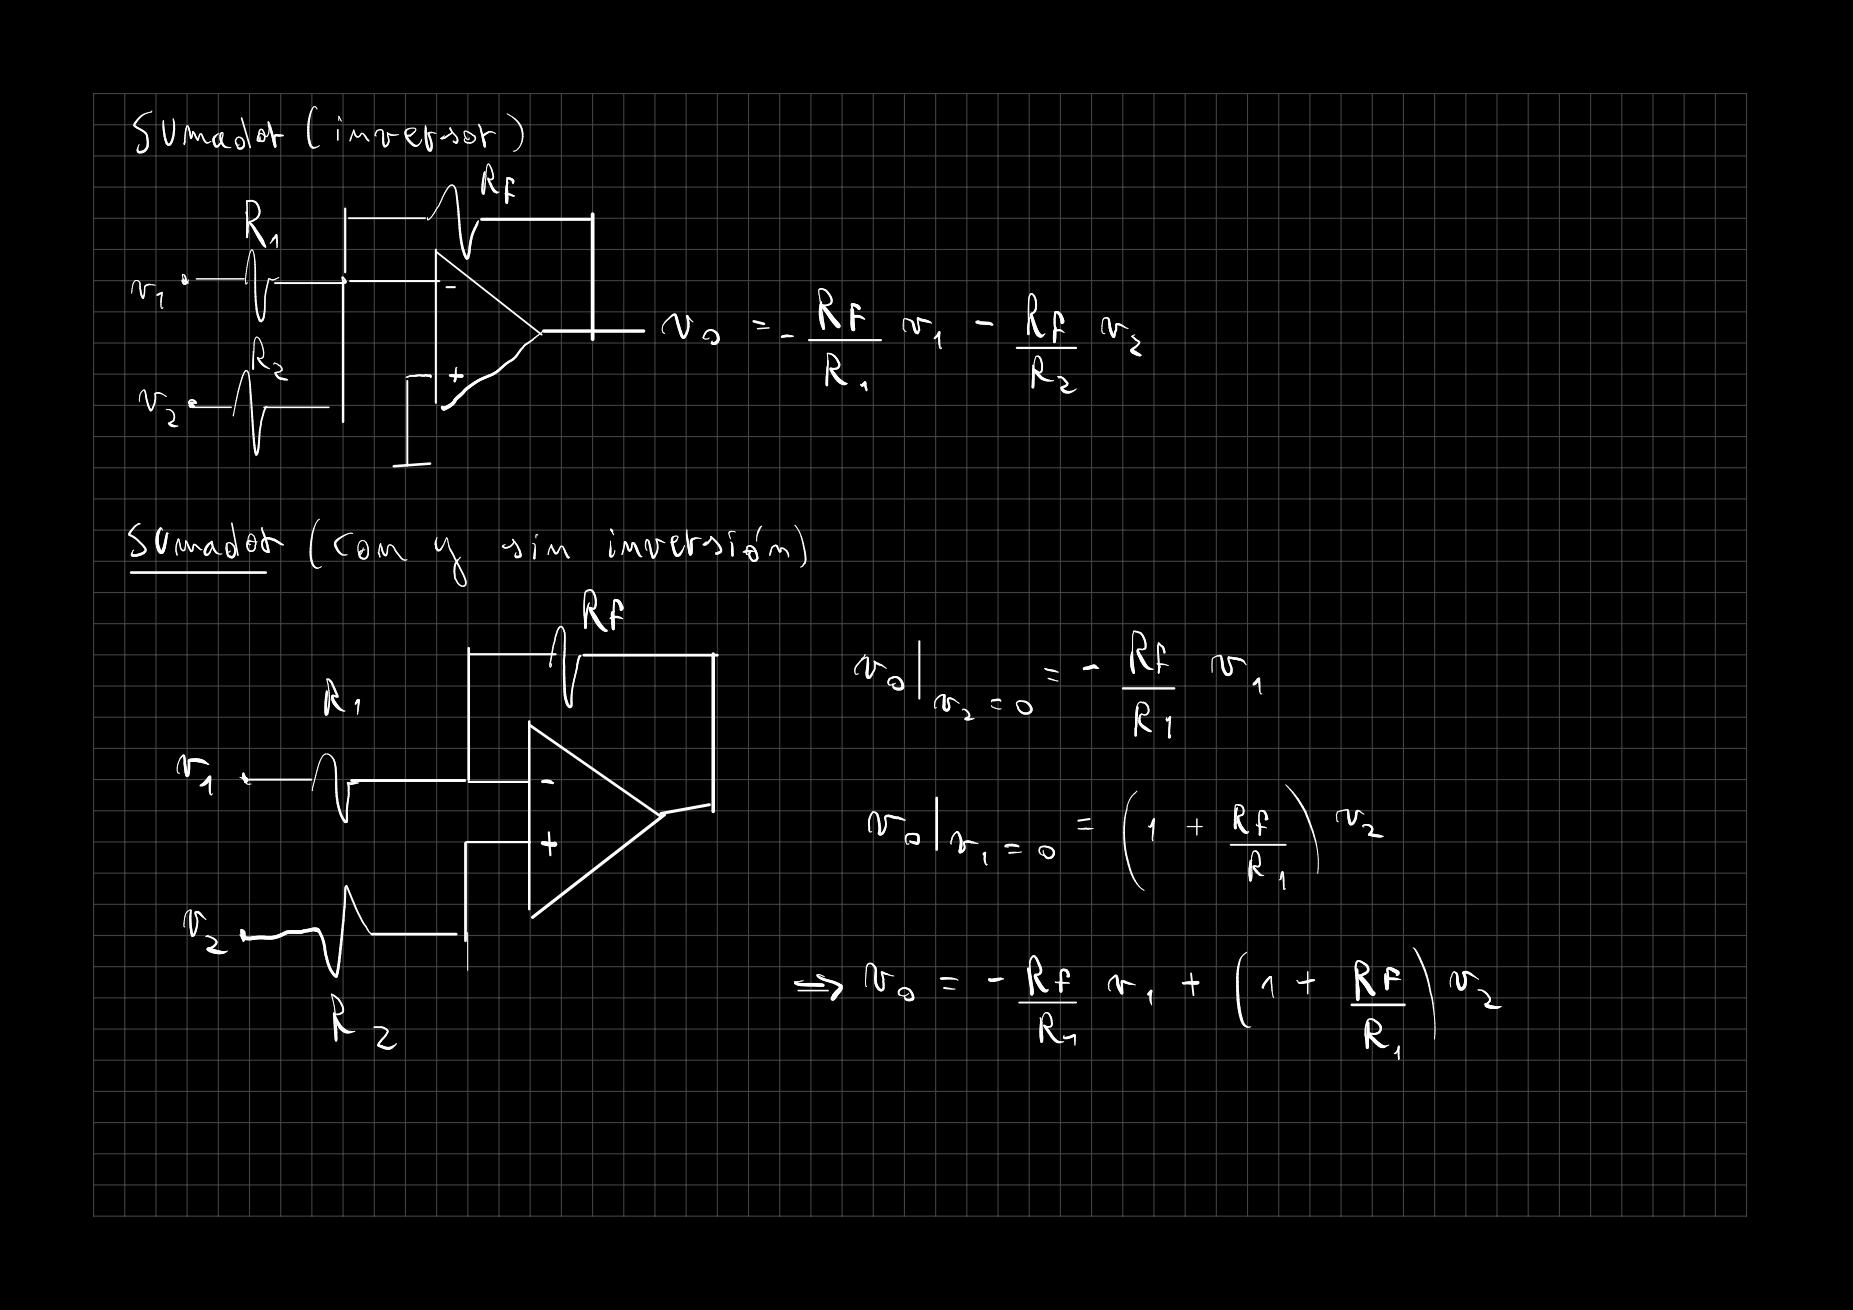
[picture p109: page 22]

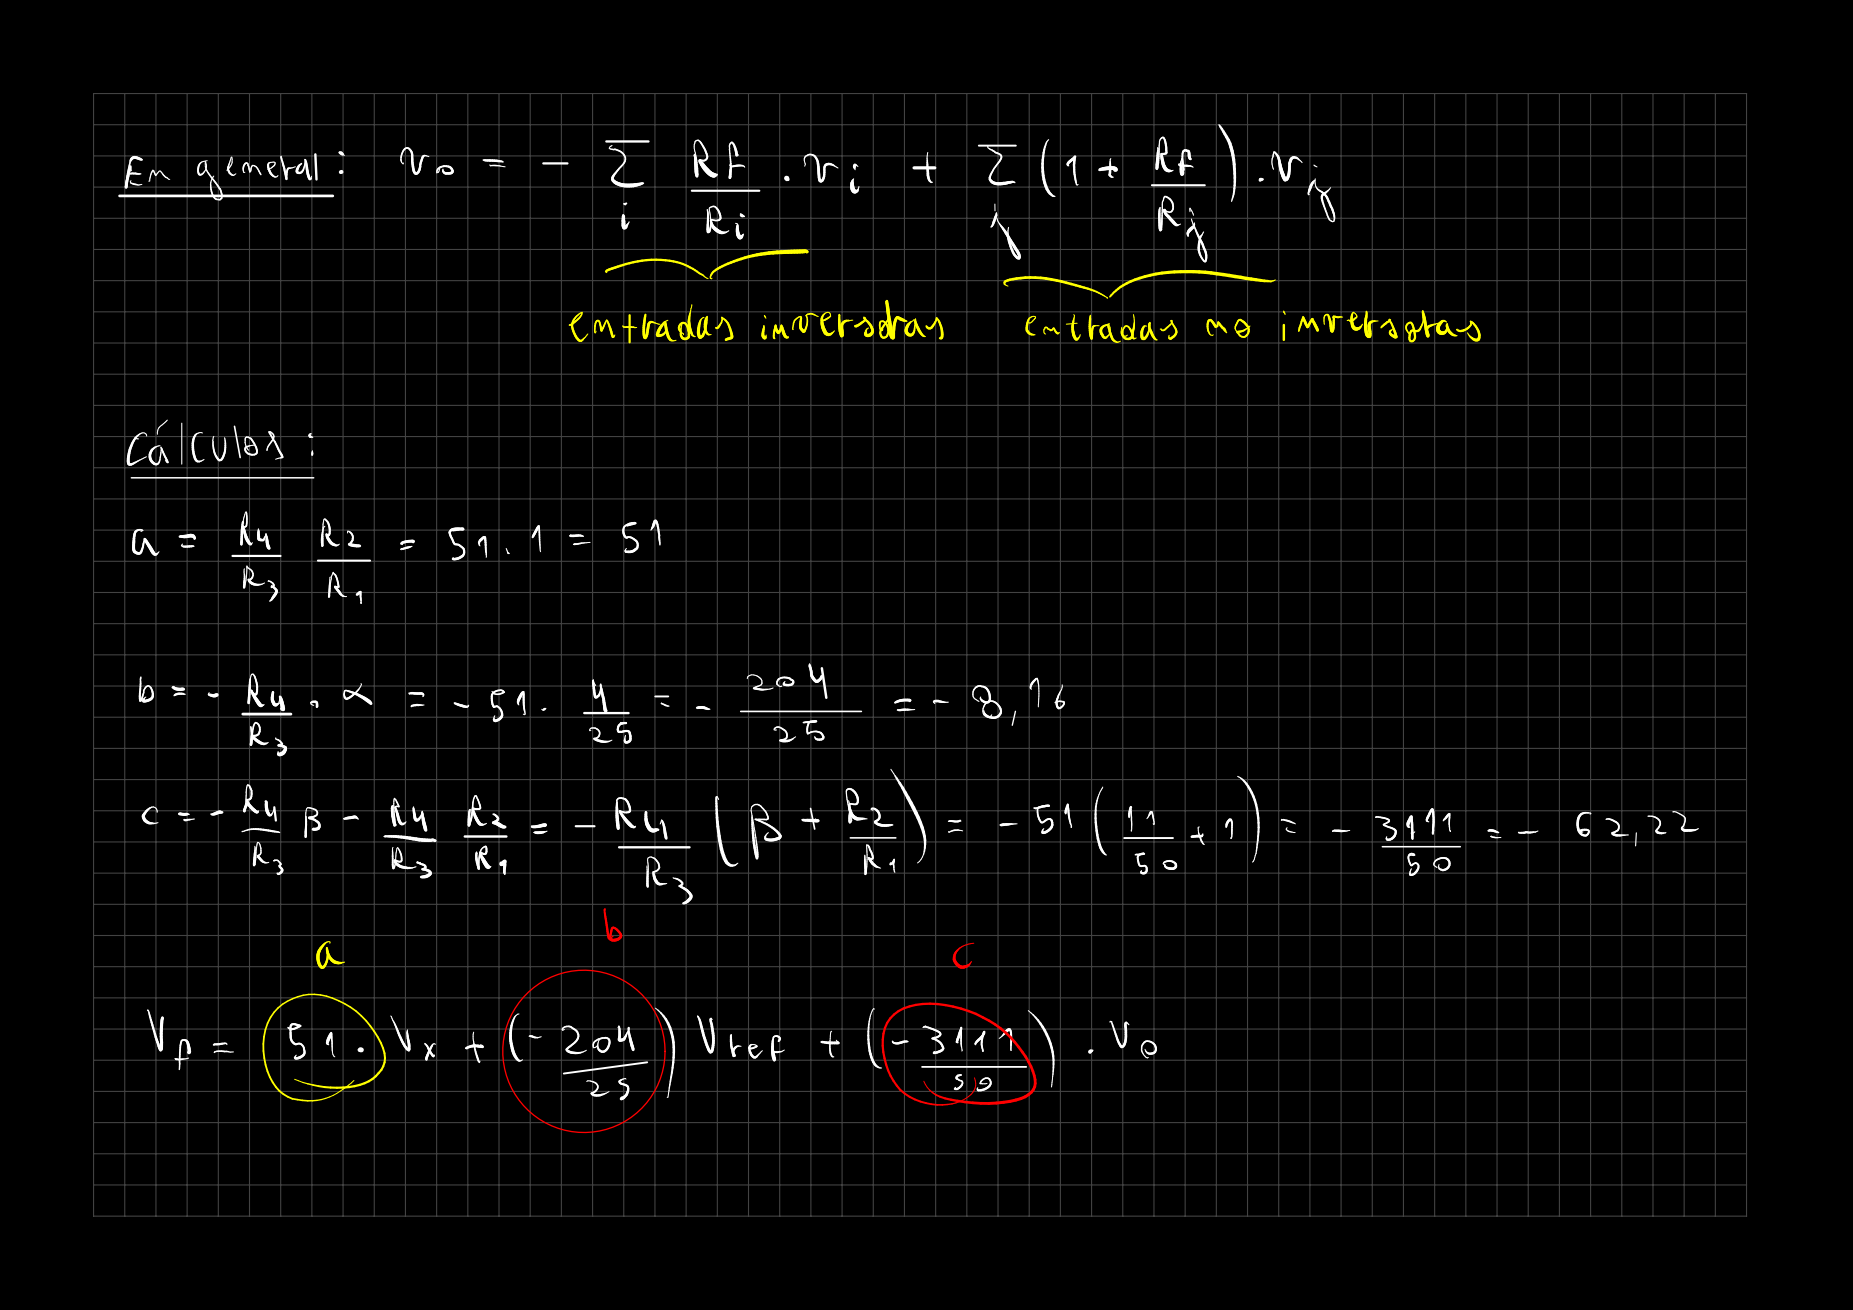
[picture p110: page 23]

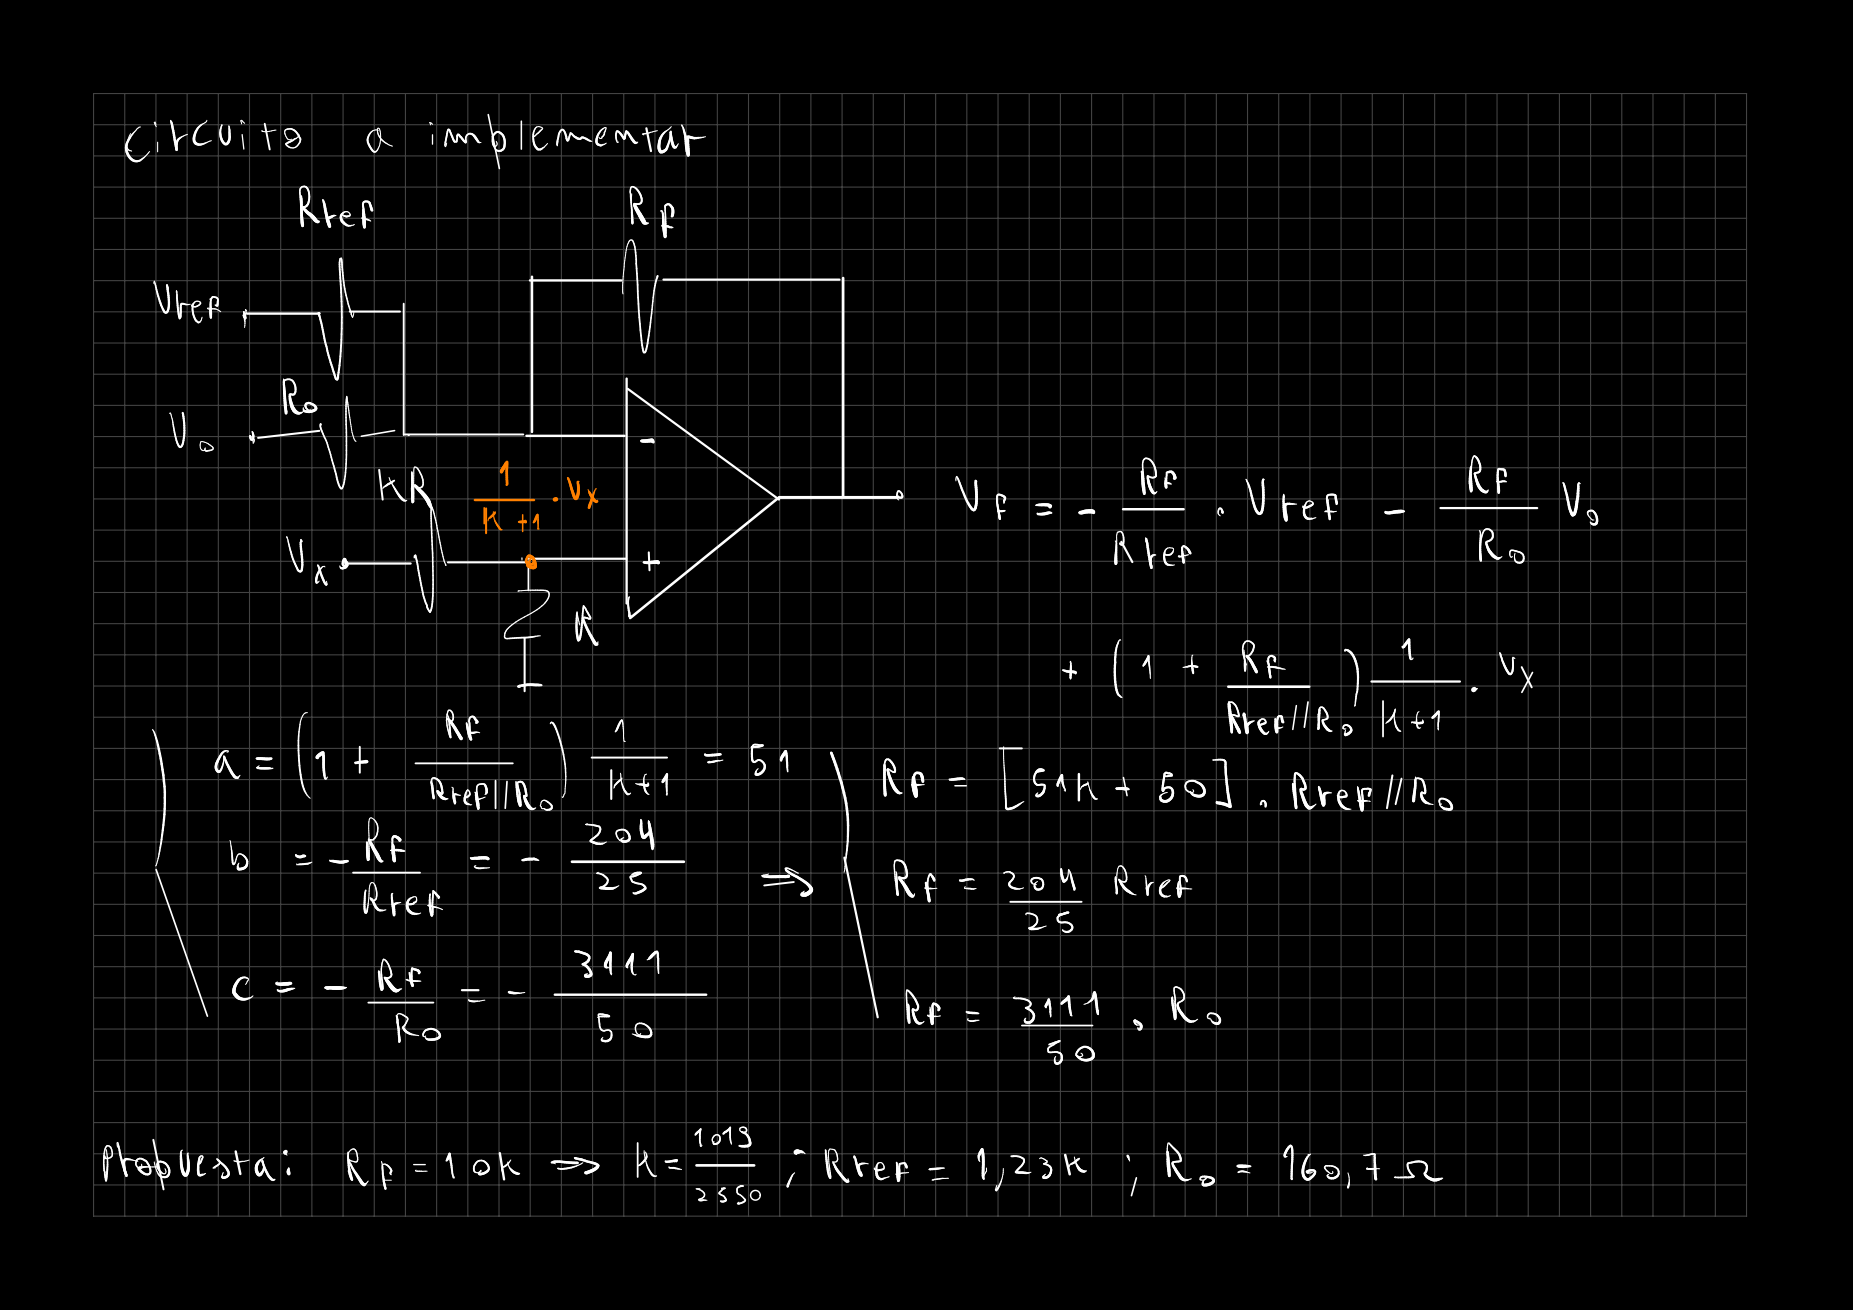
[picture p111: page 24]
