Fjmoya-uba/Taller-de-Circuitos-Grupo-5/Checkpoint 5/KiCAD/PCB-imprimir.pdf

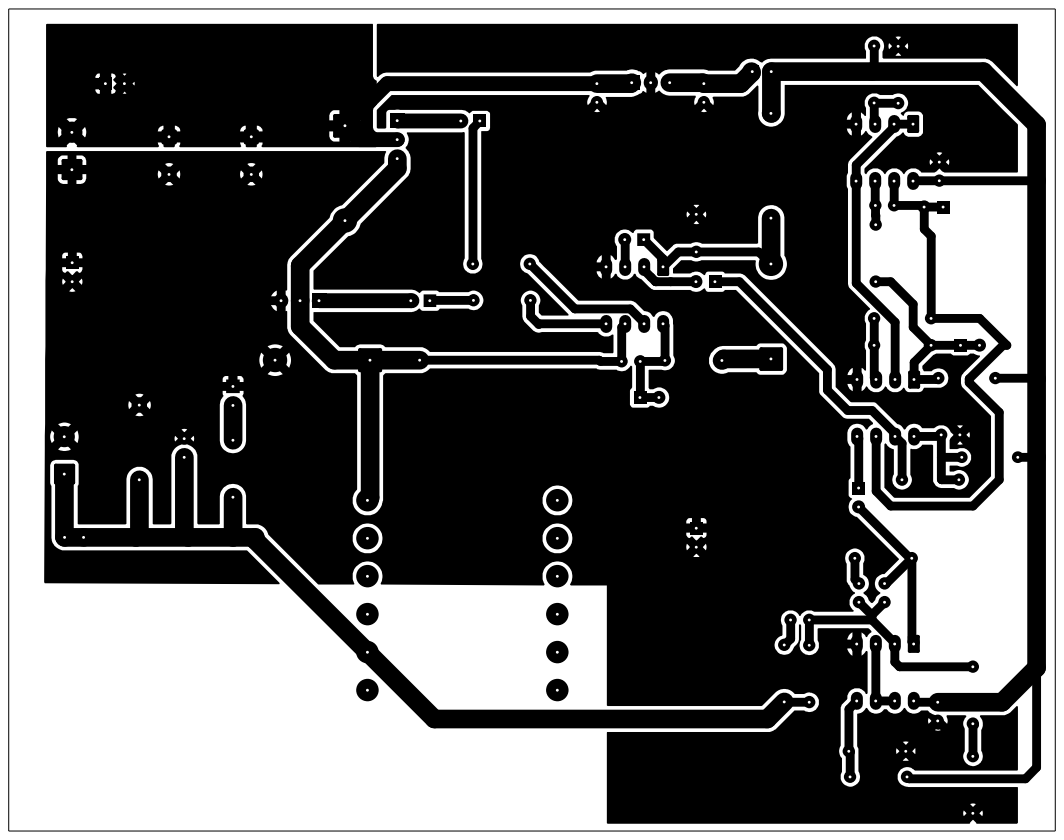
[picture p112: page 1]
