Fjmoya-uba/Taller-de-Circuitos-Grupo-5/draft-circuitos.asc

C1: cap; 1
L1: ind; 1
Q1: npn; BC848B
Q2: npn; BC848B
Q3: pnp; BC858B
Q4: pnp; BC858B
Q5: npn; BC848B
Q6: pnp; BC858B
Q7: npn; BC848B
Q8: npn; BC848B
R1: res; 10k
R2: res; 10k
R3: res; 4k4
RE3: res; 0
RE4: res; 0
RE7: res; 0
RE8: res; 0
RL: res; 50
V1: voltage; SINE(0 1m 1k); AC 1
Vref: voltage; 2.5
Vreg: voltage; 9.5
Vripple: voltage; SINE(0 200m 50)
Named nets: 0, Vref, Vreg, Vo
.op
.tran 10m
.dc Vreg 1 15 0.1
.ac dec 10 1m 1meg
