Fjmoya-uba/Taller-de-Circuitos-Grupo-5/CheckPoint1/draft-circuitos.asc

Q1: npn; BC848B
Q2: npn; BC848B
Q3: pnp; BC858B
Q4: pnp; BC858B
Q5: npn; 2N2222
Q6: pnp; D45H11
Q7: npn; BC848B
Q8: npn; BC848B
R1: res
R2: res
RE3: res
RE4: res
RE7: res
RE8: res
RL: res
U1: TLV431
Named nets: 0
