Fjmoya-uba/Taller-de-Circuitos-Grupo-5/Checkpoint 5/Simulaciones/PWM y Gate driver.asc

M1: nmos; IRFZ44N
M2: nmos; IRFZ44N
R1: res; 50
R2: res; 10
R3: res; 10
U1: PWM; VM=1, fs=100kHz
U2: Driver
U3: dead_time; Td=1000ns
U4: Driver
V1: voltage; 12
V2: voltage; 12
Vcont: voltage; 0.5
Named nets: 0, Vcc, pwm, c1, c2, H0, L0
.tran 0 40u 0 0.5u
.lib switching.lib
