Fjmoya-uba/Taller-de-Circuitos-Grupo-5/Checkpoint 5/Simulaciones/Realimentador.asc

C1: cap; 2.2n
C2: cap; 1.2n
C3: cap; 5.6n
R1: res; 68k
R2: res; 3k3
R3: res; 680
U1: opamp
V2: voltage; ""; AC 1
Named nets: 0, c
.ac dec 100 10 10Meg
.lib opamp.sub
