Fjmoya-uba/Taller-de-Circuitos-Grupo-5/Checkpoint 5/Simulaciones/Compensacion-con-triangular.asc

C1: cap; 1µ
C2: cap; 50µ
C3: cap; 1.2n
C4: cap; 22n
C5: cap; 5.6n
L1: ind; 487µ
M1: nmos; IRFZ44N
M2: nmos; IRFZ44N
R1: res; 36
R2: res; 1
R3: res; 1
R4: res; 68k
R5: res; 680
R6: res; 3k3
R7: res; 24k
U1: LT1720
U2: dead_time; Td=520ns
U3: Driver
U4: Driver
U5: LT1215
V1: voltage; 30
V2: voltage; 9
V3: voltage; 12
V4: voltage; 12
V5: voltage; 2.5; AC 0
V6: voltage; PULSE(4 5 0 3.85u 3.85u 0 0 300)
Named nets: 0, Vo, Vd, VgH, VgL, pwm, c1, c2, in, Vcc, vc, Vtrig
.tran 0 2m 0
.lib switching.lib
.lib average.lib
.include LM393.lib
