Fjmoya-uba/Taller-de-Circuitos-Grupo-5/Checkpoint 5/Simulaciones/PWM.asc

C1: cap; 56p
R1: res; 510k
R2: res; 510k
R3: res; 220k
R6: res; 5k1
R7: res; 5k1
Rf1: res; 560k
Rf2: res; 56k
U1: opamp2; TL072
U2: opamp2; TL072
U3: LT1018; LM2903B
U4: LT1018; LM2903B
V1: voltage; PULSE(0 9.1 0 1n 0 1)
V2: voltage; PULSE(3.5 5.5 0 100u 100u)
Named nets: 0, Vcc, Vref, Cuadrada, Triangular, Vref_PWM
.tran 200u
.include LM393.lib
.include TL072.301
