Fjmoya-uba/Taller-de-Circuitos-Grupo-5/Checkpoint 5/Simulaciones/Buck-converter con IR2104.asc

C1: cap; 1µ
C2: cap; 50µ
C3: cap; 0.1µ
C4: cap; 1µ
D1: schottky; MBR735
L1: ind; 487µ
M1: nmos; IRFZ44N
M2: nmos; IRFZ44N
R1: res; 6
R2: res; 1
R3: res; 1
R4: res; 1
U1: PWM; VM=1V, fs=130kHz
U2: IR2104
V1: voltage; 12
V2: voltage; 0.9; AC 1
V3: voltage; 9
Named nets: 0, Vo, VgH, VgL, pwm, in, Vcc, sw
.tran 0 500u 0
.lib switching.lib
.lib average.lib
