Fjmoya-uba/Taller-de-Circuitos-Grupo-5/Checkpoint 5/Simulaciones/Diodo rueda libre.asc

C1: cap; 1µ
C2: cap; 100µ
C3: cap; 1µ
C4: cap; 100µ
D2: diode
D3: schottky; 1N5819
L1: ind; 487µ
L2: ind; 487µ
M1: nmos
M2: nmos
M3: nmos; IRFZ46N
M4: nmos; IRFZ44N
R1: res; 30
R2: res; 3
R3: res; 1
R4: res; 1
U1: PWM; VM=1V, fs=130kHz
U2: dead_time; Td=500ns
U3: Driver
U4: Driver
V1: voltage; 12
V2: voltage; 12
V3: voltage; 12
V4: voltage; 12
V5: voltage; 0.5
Named nets: 0, Vo1, Vo2, sw2, sw1, VgH, VgL, c1, c2
.tran 0 1000u 950u
.lib switching.lib
NOTA: Cuando ambos transistores están cortados, la corriente del inductor
no tiene por donde desviarse.
Sin embargo, la simulación fuerza a M2 a conducir, a pesar de que su Vgs sea 0 V
El efecto del diodo de rueda libre se nota mejor con componentes ideales
 
El diodo disipa aprox. 500mW
