Fjmoya-uba/Taller-de-Circuitos-Grupo-5/Checkpoint 5/Simulaciones/Draft1.asc

C1: cap; 58.5n
C2: cap; 5.85n
C3: cap; 0.585n
R1: res; 27.2k
R2: res; 2.72k
R3: res; 2.72k
U1: opamp
V2: voltage; ""; AC 1
Named nets: 0
.ac dec 10 1 100Meg
.lib opamp.sub
