Fjmoya-uba/Taller-de-Circuitos-Grupo-5/Checkpoint 5/Simulaciones/IR2104.asc

C1: cap; 1µ
D1: schottky; MBR735
d: voltage; 0.5
M1: nmos; IRFZ44N
M2: nmos; IRFZ44N
R1: res; 30
R2: res; 10
R3: res; 10
U1: IR2104
U2: PWM
V1: voltage; 9
Named nets: 0, Vcc, VgH, VgL, Vsw
.inc IR2104.lib
.tran 0 50u 5u
.lib switching.lib
Repasar la teórica de julio sobre el
capacitor de boostrap y el diodo
