Fjmoya-uba/Taller-de-Circuitos-Grupo-5/Checkpoint 4/Simulaciones/Comparador-Tiempo de propagacion.asc

C1: cap; 15p
R1: res; 500k
R2: res; 1Meg
R3: res; 5k1
R4: res; 5k1
U1: LT1018; LM2903B
V1: voltage; PULSE(7 0 1u 1p 1p 10u)
V2: voltage; 9
V3: voltage; 2
Named nets: 0, Vcc, Vref, Out, Vin, V+
.include LM393.lib
.tran 10u
