Fjmoya-uba/Taller-de-Circuitos-Grupo-5/Checkpoint 5/Simulaciones/Tiempo muerto.asc

U2: dead_time
V1: voltage; PULSE(0 5 0 1n 1n 250n 500n)
Named nets: 0, in, c1, c2
.tran 3u
.lib switching.lib
