Fjmoya-uba/Taller-de-Circuitos-Grupo-5/Checkpoint2/Simulaciones Spice/Rta_al_escalon.asc

Q1: npn; BC547B
Q2: pnp; BC557B
Q3: pnp; BC557B
Q4: npn; BC547B
Q5: npn; BC547B
Q6: npn; BC547B
Q7: npn; BC547B
Q8: npn; BC547B
Qtip1: pnp
R1: res; 10k
R2: res; 10k
R3: res; 4k7
R4: res; 10k
R5: res; 1.2k
R6: res; 150
R7: res; 3.9k
R8: res; 10k
R11: res; 0
R12: res; 0
R13: res; 0
R14: res; 0
RL1: res; 30
RS1: res; 1
U1: opamp2; LM358
V1: voltage; 2.5
Vreg1: voltage; PULSE(0 9.5 10u 10n 10n 20u 40u)
Named nets: 0, Vref, Vreg, Vo, Vx, Vf
.include tip32a.lib
.lib opamp.sub
.inc lm358.lib
.include TL431.mod
Q5
.tran 0 250u 0 10n
