Fjmoya-uba/Taller-de-Circuitos-Grupo-5/Checkpoint2/Simulaciones Spice/Lazo de tension.asc

10: res; 0
C1: cap; 1000
C2: cap; {C2}
L1: ind; 1000
Q1: npn; BC547B
Q2: npn; BC547B
Q3: pnp; BC557B
Q4: pnp; BC557B
Q6: npn; BC547B
Q7: npn; BC547B
Q8: npn; BC547B
Q9: npn; BC547B
Qtip32a: pnp
R1: res; 10k
R2: res; 10k
R3: res; 4k7
R4: res; 680
R5: res; 0
R6: res; 0
R7: res; 3.9k
R8: res; 150
R9: res; 1.2k
R11: res; 0
R12: res; 10k
R13: res; 10k
RL: res; 30
RS: res; 1
U1: TL431
U2: opamp2; LM358
V1: voltage; ""; AC 1
Vreg1: voltage; 9.5
Named nets: 0, Vref, Vreg, Vo, Vx, Vf
.include tip32a.lib
.lib opamp.sub
.inc lm358.lib
.include TL431.mod
Q5
.ac dec 10 10 1G
.step param C2 list 21.68n 0
