Fjmoya-uba/Taller-de-Circuitos-Grupo-5/Ckeckpoint 1/Simulaciones/Foldback_5_opamps.asc

Q1: npn; BC848B
Q2: npn; BC848B
Q3: pnp; BC858B
Q4: pnp; BC858B
Q5: npn; BC848B
Q6: npn; BC848B
Q7: npn; BC848B
Q8: npn; BC848B
Qtip1: pnp
R1: res; 10k
R2: res; 10k
R3: res; 4k4
R4: res; 5k
R5: res; 5k
R6: res; 5k
R7: res; 5k
R8: res; 51k
R9: res; 1k
R10: res; 51k
R11: res; 1k
R12: res; 21k
R13: res; 4k
R14: res; 5k
R15: res; 5k
R16: res; 39k
R17: res; 11k
R18: res; 5k
R19: res; 5k
R21: res; 1
RL1: res; {RL}
U1: opamp
U2: opamp
U3: opamp
U4: opamp
U5: opamp
Vref1: voltage; 2.5
Vreg1: voltage; 9.5
Named nets: 0, Vref, Vreg, Vo, Vx, VrefC, Vf
.op
.step oct param RL 0.01 10 50
.include tip32a.lib
.lib opamp.sub
