Fjmoya-uba/Taller-de-Circuitos-Grupo-5/Ckeckpoint 1/Simulaciones/Mediciones TP/Regulacion de Linea.asc

Q1: npn; BC547B
Q2: pnp; BC557B
Q3: pnp; BC557B
Q4: npn; BC547B
Q5: npn; BC547B
Q6: npn; BC547B
Q7: npn; BC547B
Q8: npn; BC547B
Qtip32a: pnp
R1: res; 10k
R2: res; 10k
R3: res; 4k7
R10: res; 680
Rf: res; 10k
RL: res; 50
Ro: res; 150
Rref: res; 1.2k
RS: res; 1
Rx1: res; 3.9k
Rx2: res; 10k
U1: opamp2; LM358
U2: TL431
Vreg1: voltage; 9.5
Named nets: 0, Vref, Vreg, Vo, Vx, Vf
.include tip32a.lib
.lib opamp.sub
.include TL431.mod
.inc lm358.lib
.dc Vreg1 0 20 0.1
,meas DC VRL1 FIND V(Vo) at 7
.meas DC VRL2 FIND V(Vo) at 15
.meas DC RegLin PARAM 1000*(VRL2 - VRL1)/(15 - 7)
Regulación de línea en mV/V
Para ver el resultado, abrir el log con Ctrl + L
