Fjmoya-uba/Taller-de-Circuitos-Grupo-5/(list of files, drawings)

Other design files:
Checkpoint 5/Simulaciones/lm393.opj
