Fjmoya-uba/Taller-de-Circuitos-Grupo-5/Checkpoint 5/KiCAD/switching_v3/switching_v3.kicad_pcb

## KiCad design Checkpoint 5/KiCAD/switching_v3/switching_v3.kicad_pcb (2026-06-30)

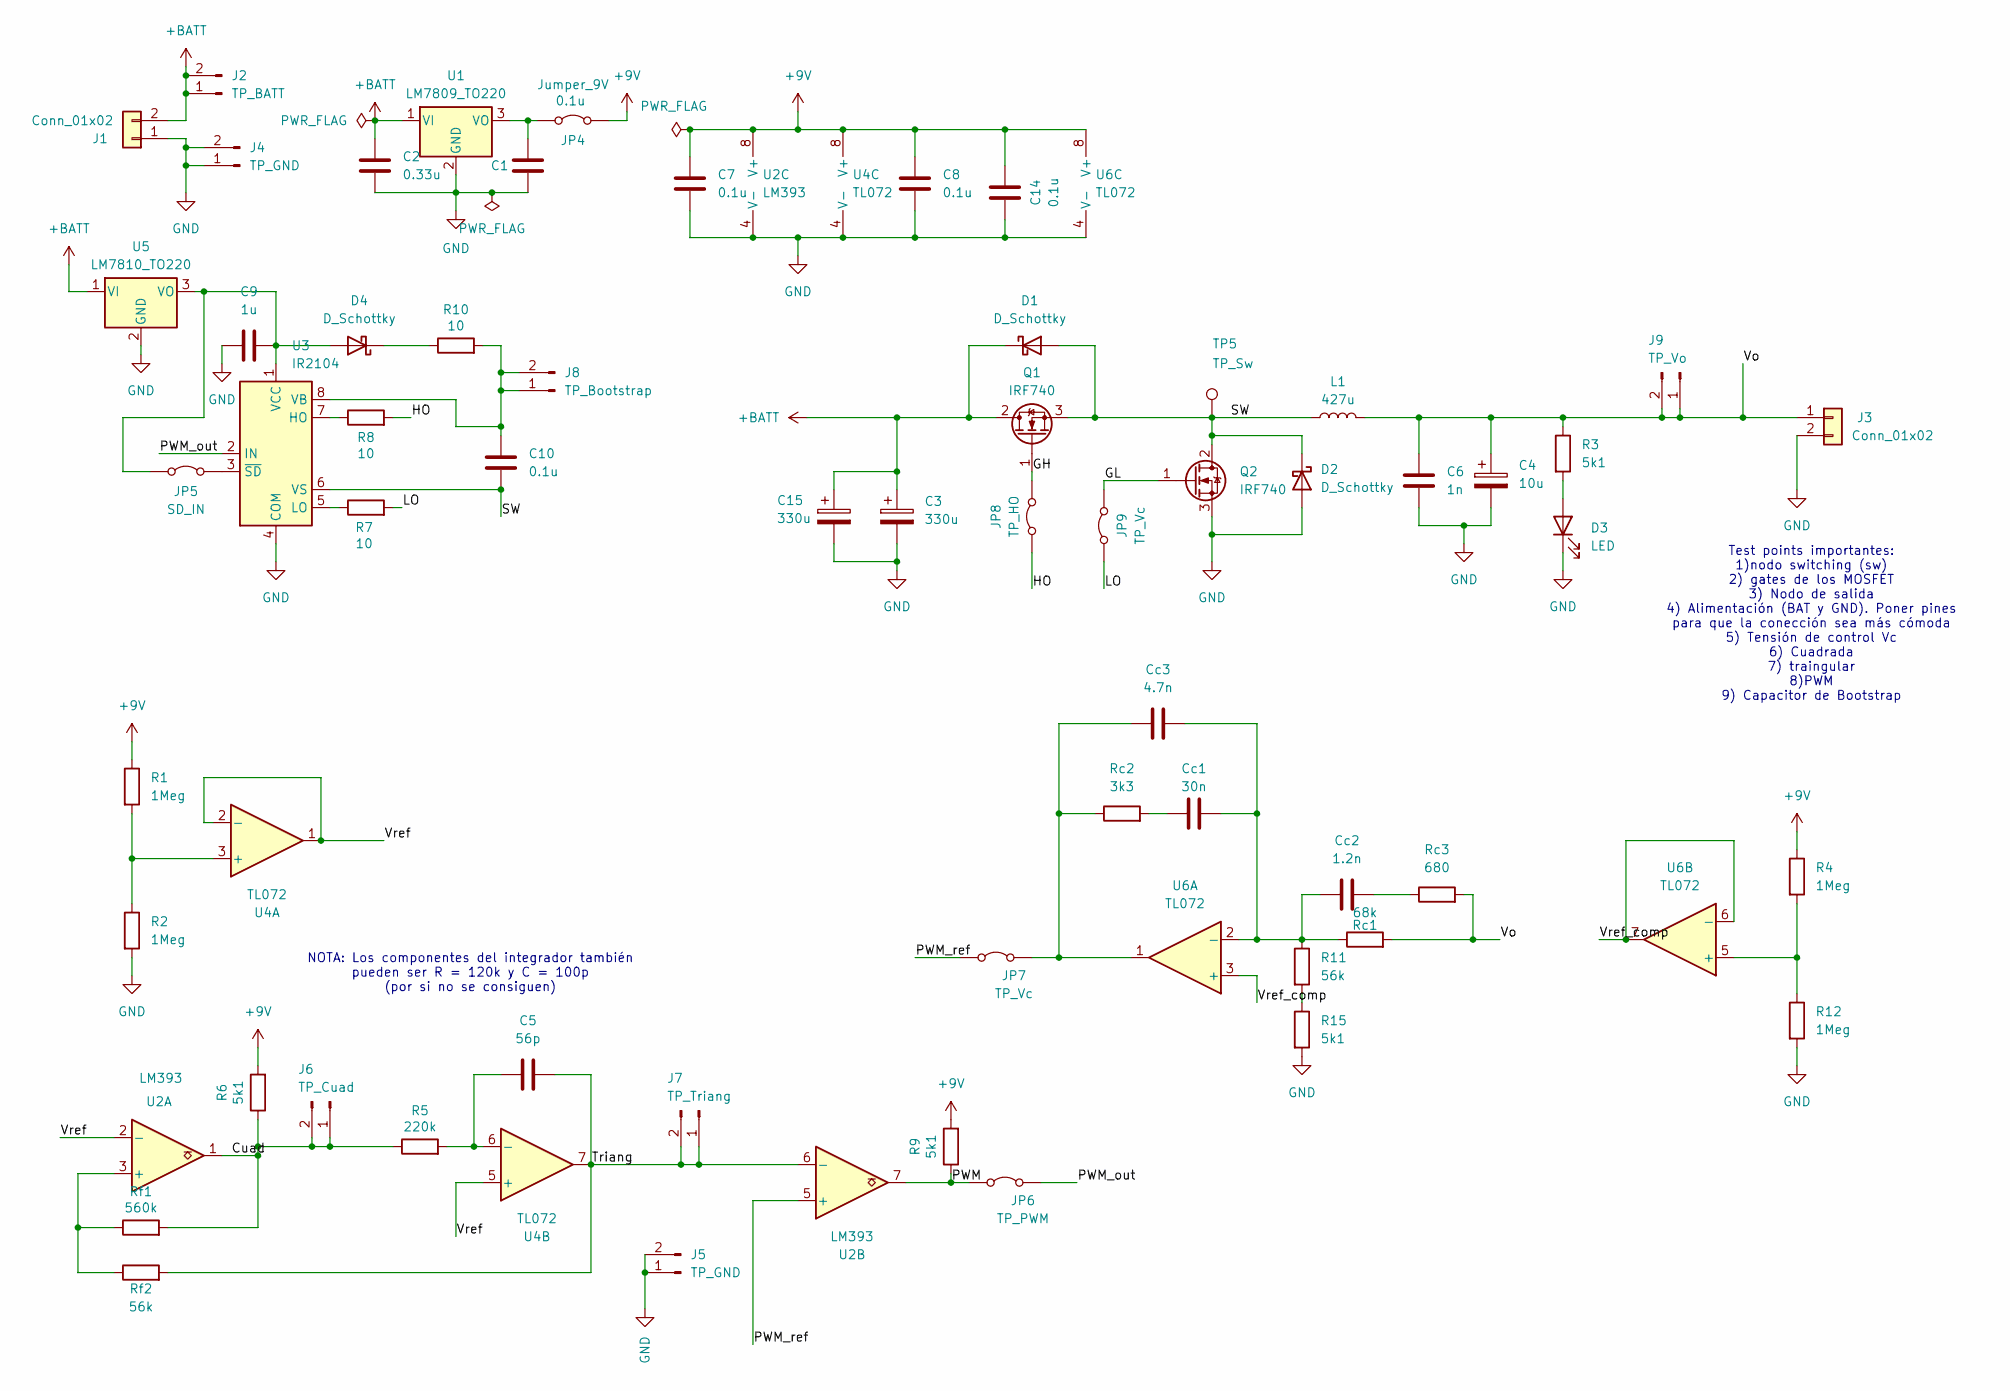
[picture p113: schematic switching_v3.kicad_sch]

Parts:
C1, C7, C8, C10, C14: 0.1u; C_Disc_D5.0mm_W2.5mm_P2.50mm
C2: 0.33u; C_Disc_D5.0mm_W2.5mm_P2.50mm
C3, C15: 330u; CP_Radial_D10.0mm_P5.00mm
C4: 10u; CP_Radial_D5.0mm_P2.50mm
C5: 56p; C_Disc_D5.0mm_W2.5mm_P2.50mm
C6: 1n; C_Disc_D14.5mm_W5.0mm_P10.00mm
C9: 1u; C_Disc_D8.0mm_W2.5mm_P5.00mm
Cc1: 30n; C_Disc_D5.0mm_W2.5mm_P2.50mm
Cc2: 1.2n; C_Disc_D5.0mm_W2.5mm_P2.50mm
Cc3: 4.7n; C_Disc_D5.0mm_W2.5mm_P2.50mm
D1, D2, D4: D_Schottky; D_DO-201AD_P12.70mm_Horizontal
D3: LED; LED_D5.0mm_IRGrey
J1, J3: Conn_01x02; TerminalBlock_MaiXu_MX126-5.0-02P_1x02_P5.00mm
J2: TP_BATT; PinHeader_1x02_P2.54mm_Vertical
J4, J5: TP_GND; PinHeader_1x02_P2.54mm_Vertical
J6: TP_Cuad; PinHeader_1x02_P2.54mm_Vertical
J7: TP_Triang; PinHeader_1x02_P2.54mm_Vertical
J8: TP_Bootstrap; PinHeader_1x02_P2.54mm_Vertical
J9: TP_Vo; PinHeader_1x02_P2.54mm_Vertical
JP4: Jumper_9V; PinHeader_1x02_P2.54mm_Vertical
JP5: SD_IN; PinHeader_1x02_P2.54mm_Vertical
JP6: TP_PWM; PinHeader_1x02_P2.54mm_Vertical
JP7, JP9: TP_Vc; PinHeader_1x02_P2.54mm_Vertical
JP8: TP_HO; PinHeader_1x02_P2.54mm_Vertical
L1: 427u; Transformer_37x44
Q1, Q2: IRF740; TO-220-3_Vertical
R1, R2, R4, R12: 1Meg; R_Axial_DIN0207_L6.3mm_D2.5mm_P7.62mm_Horizontal
R3, R6, R9, R15: 5k1; R_Axial_DIN0207_L6.3mm_D2.5mm_P7.62mm_Horizontal
R5: 220k; R_Axial_DIN0207_L6.3mm_D2.5mm_P7.62mm_Horizontal
R7, R8, R10: 10; R_Axial_DIN0207_L6.3mm_D2.5mm_P7.62mm_Horizontal
R11: 56k; R_Axial_DIN0207_L6.3mm_D2.5mm_P7.62mm_Horizontal
Rc1: 68k; R_Axial_DIN0207_L6.3mm_D2.5mm_P7.62mm_Horizontal
Rc2: 3k3; R_Axial_DIN0207_L6.3mm_D2.5mm_P7.62mm_Horizontal
Rc3: 680; R_Axial_DIN0207_L6.3mm_D2.5mm_P7.62mm_Horizontal
Rf1: 560k; R_Axial_DIN0207_L6.3mm_D2.5mm_P7.62mm_Horizontal
Rf2: 56k; R_Axial_DIN0207_L6.3mm_D2.5mm_P7.62mm_Horizontal
TP5: TP_Sw; PinHeader_1x01_P2.54mm_Vertical
U1: LM7809_TO220; TO-220-3_Vertical
U2: LM393; DIP-8_W7.62mm_Socket_LongPads
U3: IR2104; DIP-8_W7.62mm_Socket_LongPads
U4, U6: TL072; DIP-8_W7.62mm_Socket_LongPads
U5: LM7810_TO220; TO-220-3_Vertical

Connections:
+9V: C7.1, C8.1, C14.1, JP4.2 (B), R1.1, R4.1, R6.2, R9.2, U2.8 (V+), U4.8 (V+), U6.8 (V+)
+BATT: C2.1, C3.1, C15.1, D1.1 (K), J1.2, J2.1, J2.2, Q1.2 (D), U1.1 (VI), U5.1 (VI)
/Cuad: J6.1, J6.2, R5.1, R6.1, Rf1.2, U2.1
/GH: JP8.2 (B), Q1.1 (G)
/GL: JP9.2 (B), Q2.1 (G)
/HO: JP8.1 (A), R8.2
/LO: JP9.1 (A), R7.2
/PWM: JP6.1 (A), R9.1, U2.7
/PWM_out: JP6.2 (B), U3.2 (IN)
/PWM_ref: JP7.1 (A), U2.5 (+)
/SW: C10.2, D1.2 (A), D2.1 (K), L1.1, Q1.3 (S), Q2.2 (D), TP5.1 (1_1), U3.6 (VS)
/Triang: C5.1, J7.1, J7.2, Rf2.2, U2.6 (-), U4.7
/Vo: C4.1, C6.1, J3.1, J9.1, J9.2, L1.2, R3.1, Rc1.2, Rc3.2
/Vref: U2.2 (-), U4.1, U4.2 (-), U4.5 (+)
/Vref_comp: U6.3 (+), U6.6 (-), U6.7
GND: C1.2, C2.2, C3.2, C4.2, C6.2, C7.2, C8.2, C9.1, C14.2, C15.2, D2.2 (A), D3.1 (K), J1.1, J3.2, J4.1, J4.2, J5.1, J5.2, Q2.3 (S), R2.2, R12.2, R15.2, U1.2 (GND), U2.4 (V-), U3.4 (COM), U4.4 (V-), U5.2 (GND), U6.4 (V-)
unnamed: Cc1.1, Rc2.2
unnamed: Cc2.2, Rc3.1
unnamed: D3.2 (A), R3.2
unnamed: C9.2, D4.2 (A), JP5.1 (A), U3.1 (VCC), U5.3 (VO)
unnamed: D4.1 (K), R10.1
unnamed: C10.1, J8.1, J8.2, R10.2, U3.8 (VB)
unnamed: C1.1, JP4.1 (A), U1.3 (VO)
unnamed: JP5.2 (B), U3.3 (~SD)
unnamed: Cc3.1, JP7.2 (B), Rc2.1, U6.1
unnamed: R11.2, R15.1
unnamed: Rf1.1, Rf2.1, U2.3 (+)
unnamed: R8.1, U3.7 (HO)
unnamed: R7.1, U3.5 (LO)
unnamed: R1.2, R2.1, U4.3 (+)
unnamed: C5.2, R5.2, U4.6 (-)
unnamed: Cc1.2, Cc2.1, Cc3.2, R11.1, Rc1.1, U6.2 (-)
unnamed: R4.2, R12.1, U6.5 (+)

Notes on the sheet:
Test points importantes: 1)nodo switching (sw) 2) gates de los MOSFET 3) Nodo de salida 4) Alimentación (BAT y GND). Poner pines para que la conección sea más cómoda 5) Tensión de control Vc 6) Cuadrada 7) traingular 8)PWM 9) Capacitor de Bootstrap
NOTA: Los componentes del integrador también pueden ser R = 120k y C = 100p (por si no se consiguen)

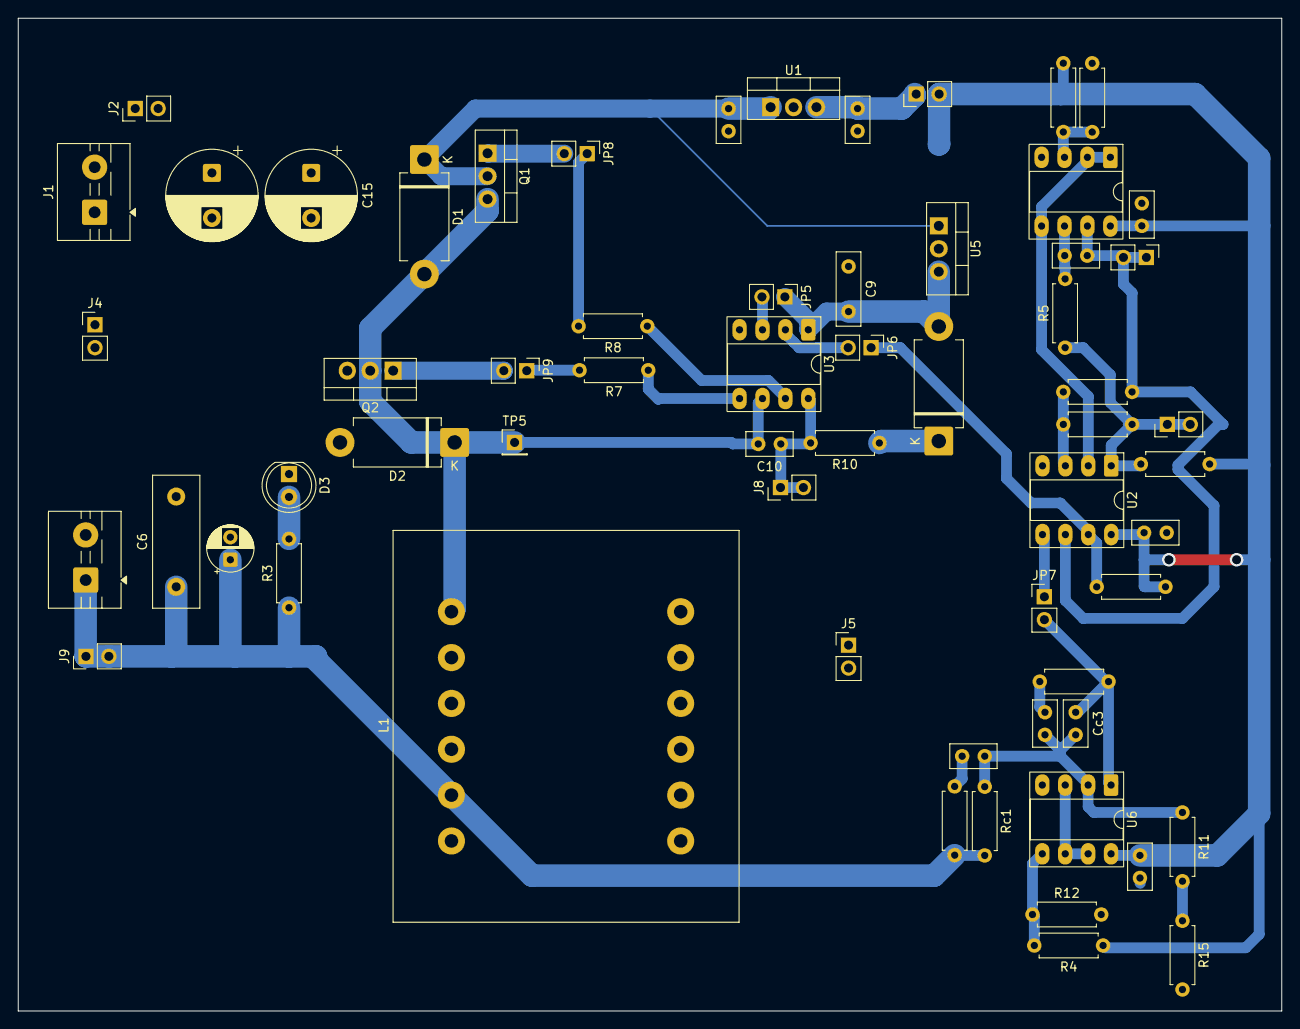
[picture p114: board switching_v3.kicad_pcb from above]

Board: 2 copper layers, 140.0 x 110.0 mm, 62 parts (0 on the bottom side), 33 nets.
