Fjmoya-uba/Taller-de-Circuitos-Grupo-5/Checkpoint2/KiCAD/Diseño/Diseño.kicad_pcb

## KiCad design Checkpoint2/KiCAD/Diseño/Diseño.kicad_pcb (2026-04-16)

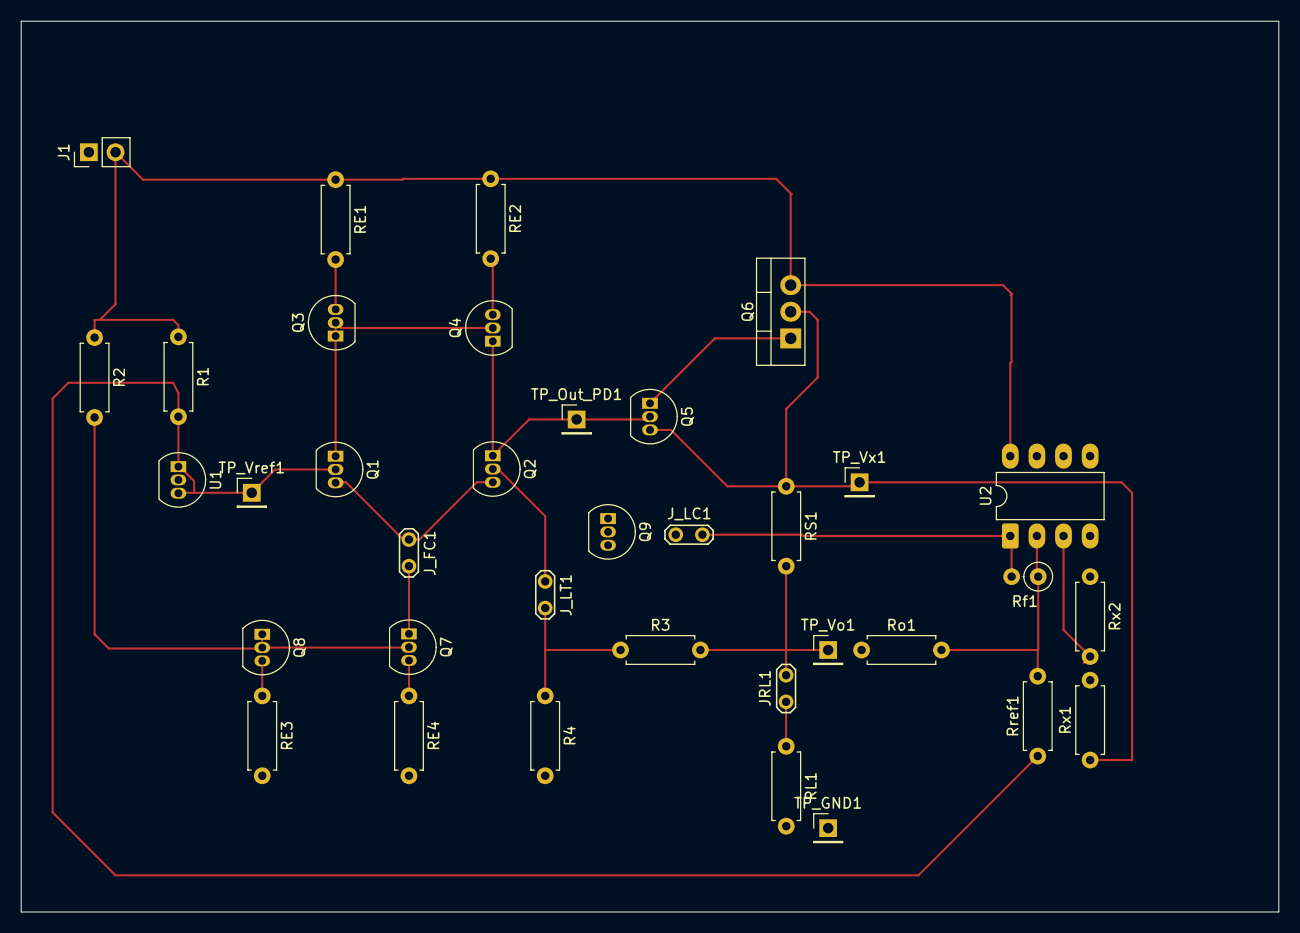
[picture p115: board Diseño.kicad_pcb from above]

Board: 2 copper layers, 120.0 x 85.0 mm, 36 parts (0 on the bottom side), 22 nets.

Parts:
J1: Conn_01x02; PinHeader_1x02_P2.54mm_Vertical
JRL1: TestPoint_2Pads_Pitch2.54mm_Drill0.8mm
J_FC1: TestPoint_2Pads_Pitch2.54mm_Drill0.8mm
J_LC1: TestPoint_2Pads_Pitch2.54mm_Drill0.8mm
J_LT1: TestPoint_2Pads_Pitch2.54mm_Drill0.8mm
Q1, Q2, Q5, Q7, Q8, Q9: BC547; TO-92_Inline
Q3, Q4: BC557; TO-92_Inline
Q6: TIP32A; TO-220-3_Vertical
R1: 680; R_Axial_DIN0207_L6.3mm_D2.5mm_P7.62mm_Horizontal
R2: 4k7; R_Axial_DIN0207_L6.3mm_D2.5mm_P7.62mm_Horizontal
R3, R4: 10k; R_Axial_DIN0207_L6.3mm_D2.5mm_P7.62mm_Horizontal
RE1, RE2, RE3, RE4: 680; R_Axial_DIN0207_L6.3mm_D2.5mm_P7.62mm_Horizontal
RL1: R_Axial_DIN0207_L6.3mm_D2.5mm_P7.62mm_Horizontal
RS1: R_Axial_DIN0207_L6.3mm_D2.5mm_P7.62mm_Horizontal
Rf1: 10k; R_Axial_DIN0207_L6.3mm_D2.5mm_P2.54mm_Vertical
Ro1: 150; R_Axial_DIN0207_L6.3mm_D2.5mm_P7.62mm_Horizontal
Rref1: 1k2; R_Axial_DIN0207_L6.3mm_D2.5mm_P7.62mm_Horizontal
Rx1: 10k; R_Axial_DIN0207_L6.3mm_D2.5mm_P7.62mm_Horizontal
Rx2: 3k9; R_Axial_DIN0207_L6.3mm_D2.5mm_P7.62mm_Horizontal
TP_GND1: PinHeader_1x01_P2.54mm_Vertical
TP_Out_PD1: PinHeader_1x01_P2.54mm_Vertical
TP_Vo1: PinHeader_1x01_P2.54mm_Vertical
TP_Vref1: PinHeader_1x01_P2.54mm_Vertical
TP_Vx1: PinHeader_1x01_P2.54mm_Vertical
U1: TL431LP; TO-92_Inline
U2: LM358; DIP-8_W7.62mm_LongPads

Connections:
/Vf: J_LC1.2 (B), Rf1.2, U2.1
/Vo: JRL1.2 (B), R3.2, RS1.2, Ro1.1, TP_Vo1.1 (1_1)
/Vref: Q1.2 (B), R1.2, Rref1.1, TP_Vref1.1 (1_1), U1.1 (REF), U1.3 (K)
/Vx: Q5.3 (E), Q6.2 (C), RS1.1, Rx1.1, TP_Vx1.1 (1_1)
GND: J1.1, Q9.3 (E), R4.2, RE3.2, RE4.2, RL1.2, Rx2.1, TP_GND1.1 (1_1), U1.2 (A), U2.4 (V-)
unnamed: J1.2, Q6.3 (E), R1.1, R2.1, RE1.1, RE2.1, U2.8 (V+)
unnamed: JRL1.1 (A), RL1.1
unnamed: J_FC1.1 (A), Q1.3 (E), Q2.3 (E)
unnamed: J_FC1.2 (B), Q7.1 (C)
unnamed: J_LC1.1 (A), Q9.2 (B)
unnamed: J_LT1.1 (A), Q2.2 (B)
unnamed: J_LT1.2 (B), R3.1, R4.1
unnamed: Q1.1 (C), Q3.1 (C), Q3.2 (B), Q4.2 (B)
unnamed: Q2.1 (C), Q4.1 (C), Q5.2 (B), Q9.1 (C), TP_Out_PD1.1 (1_1)
unnamed: Q3.3 (E), RE1.2
unnamed: Q4.3 (E), RE2.2
unnamed: Q5.1 (C), Q6.1 (B)
unnamed: Q7.2 (B), Q8.1 (C), Q8.2 (B), R2.2
unnamed: Q7.3 (E), RE4.1
unnamed: Q8.3 (E), RE3.1
unnamed: Rx1.2, Rx2.2, U2.3 (+)
unnamed: Rf1.1, Ro1.2, Rref1.2, U2.2 (-)
