Fjmoya-uba/Taller-de-Circuitos-Grupo-5/CheckPoint1/KiCAD/probando/probando.kicad_sch

## KiCad design CheckPoint1/KiCAD/probando/probando.kicad_sch (2026-04-09)

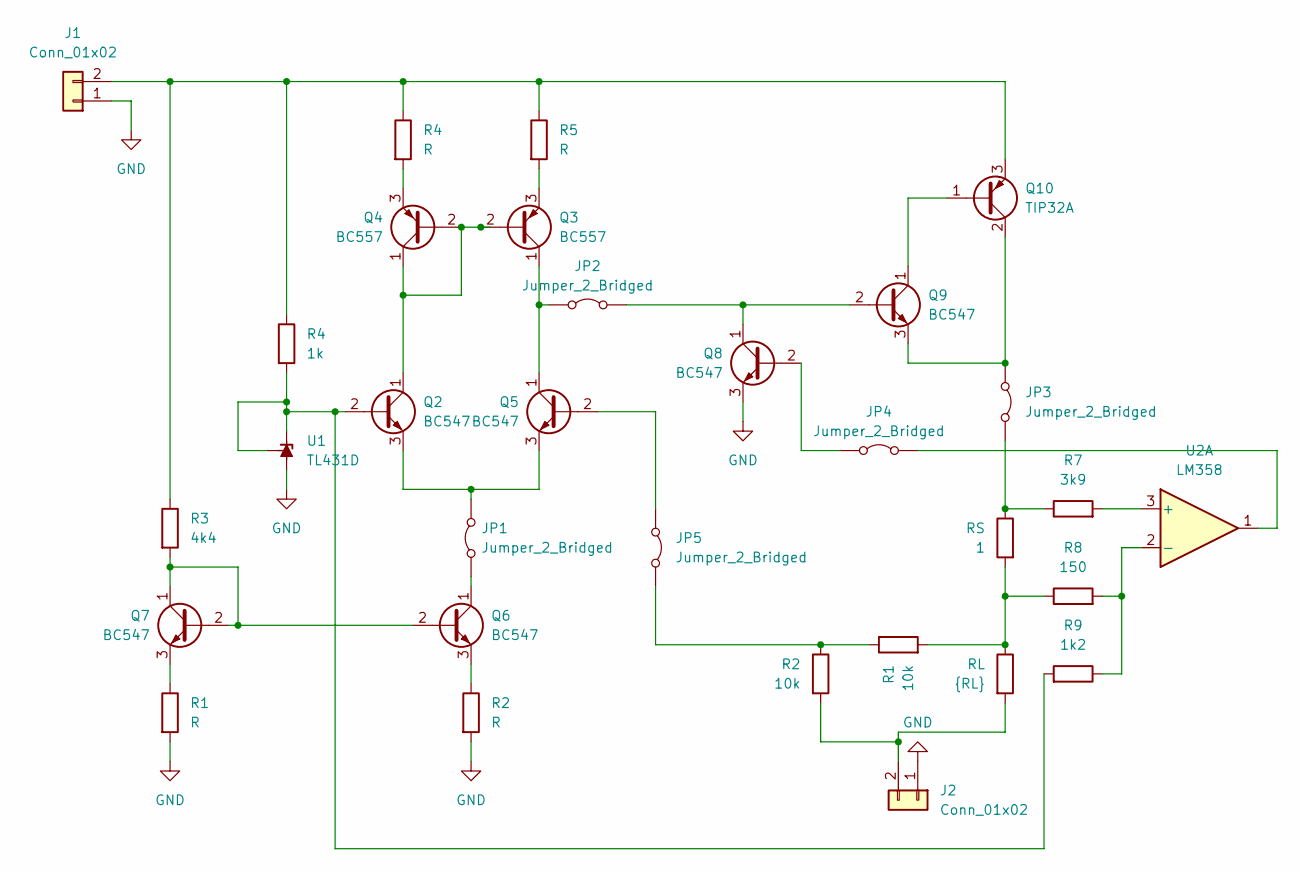
[picture p116: schematic probando.kicad_sch]

Parts:
J1, J2: Conn_01x02; Samtec_HPM-02-01-x-S_Straight_1x02_Pitch5.08mm
JP1, JP2, JP3, JP4, JP5: Jumper_2_Bridged
Q2, Q5, Q6, Q7, Q8, Q9: BC547; TO-92_Inline
Q3, Q4: BC557; TO-92_Inline
Q10: TIP32A
R1: 10k
R2, R4, R5: R
R3: 4k4
R7: 3k9
R8: 150
R9: 1k2
RL: {RL}
RS: 1
U1: TL431D; SOIC-8_3.9x4.9mm_P1.27mm
U2: LM358

Connections:
GND: J1.1, J2.1, Q8.3 (E), R1.2, R2.2, U1.2 (A), U1.3 (A), U1.6 (A), U1.7 (A)
unnamed: J1.2, Q10.3 (E), R3.1, R4.1, R5.1
unnamed: J2.2, R2.2, RL.2
unnamed: JP1.1 (A), Q6.1 (C)
unnamed: JP1.2 (B), Q2.3 (E), Q5.3 (E)
unnamed: JP2.1 (A), Q3.1 (C), Q5.1 (C)
unnamed: JP2.2 (B), Q8.1 (C), Q9.2 (B)
unnamed: JP3.1 (A), Q9.3 (E), Q10.2 (C)
unnamed: JP3.2 (B), R7.1, RS.1
unnamed: JP4.1 (A), Q8.2 (B)
unnamed: JP4.2 (B), U2.1
unnamed: JP5.1 (A), Q5.2 (B)
unnamed: JP5.2 (B), R1.1, R2.1
unnamed: Q2.1 (C), Q3.2 (B), Q4.1 (C), Q4.2 (B)
unnamed: Q2.2 (B), R4.2, R9.2, U1.1 (K), U1.8 (REF)
unnamed: Q3.3 (E), R5.2
unnamed: Q4.3 (E), R4.2
unnamed: Q6.2 (B), Q7.1 (C), Q7.2 (B), R3.2
unnamed: Q6.3 (E), R2.1
unnamed: Q7.3 (E), R1.1
unnamed: Q9.1 (C), Q10.1 (B)
unnamed: R1.2, R8.1, RL.1, RS.2
unnamed: R7.2, U2.3 (+)
unnamed: R8.2, R9.1, U2.2 (-)
