Fjmoya-uba/Taller-de-Circuitos-Grupo-5/(commit log)

2026-04-08 Archivos de KiCAD
    [probando.kicad_pcb, probando.kicad_sch]
2026-04-09 hice cositas
    [probando.kicad_sch]
2026-04-09 Arreglando cosas
    [esquematico.kicad_sch]
2026-04-10 Correcciones de las simulaciones
2026-04-11 ganancia de lazo para varias cargas
2026-04-12 Reorganización
    [esquematico.kicad_pcb, esquematico.kicad_sch]
2026-04-16 Agrego el .gitignore para filtrar archivos de KiCAD
2026-04-16 Primer diseño. Muchas dudas
    [Diseño.kicad_pcb, Diseño.kicad_sch]
2026-04-17 vamos a ver dijo el ciego
2026-06-03 Papers sobre la buck
2026-06-08 le cambié el nombre a una simulación
2026-06-09 Anotaciones sobre la hoja de datos de TI
2026-06-14 Cuentas sobre la compensación
2026-06-18 circuito bootstrap + nota de aplicación
2026-06-19 intentando hacer el pcb
    [checkpoint5.kicad_pcb, checkpoint5.kicad_sch]
2026-06-19 agregué PWM a cp5
    [checkpoint5.kicad_pcb, checkpoint5.kicad_sch, lm393.opj, switching_v1.kicad_pcb, switching_v1.kicad_sch]
2026-06-20 avances CP5
    [switching_v1.kicad_sch]
2026-06-20 PWM arreglado
2026-06-21 corregí el cálculo del inductor
2026-06-21 Corregí el valor del inductor
2026-06-21 avances PCB
    [switching_v1.kicad_pcb, switching_v1.kicad_sch]
2026-06-22 correción PCB
    [switching_v1.kicad_pcb, switching_v2.kicad_pcb, switching_v2.kicad_sch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]
2026-06-23 lista de materiales
    [switching_v3.csv, switching_v3.kicad_sch]
2026-06-24 nueva salida de frabricacion
    [switching_v3-B_Cu.gbr, switching_v3-B_Mask.gbr, switching_v3-B_Paste.gbr, switching_v3-B_Silkscreen.gbr, switching_v3-Edge_Cuts.gbr, switching_v3-F_Cu.gbr, switching_v3-F_Mask.gbr, switching_v3-F_Paste.gbr]
2026-06-25 agregué el LM7810
    [switching_v3.kicad_pcb, switching_v3.kicad_sch]
2026-06-25 PWM change
2026-06-27 Agrego informe
    [Diseño_v3-B_Cu.gbr, Diseño_v3-B_Mask.gbr, Diseño_v3-B_Paste.gbr, Diseño_v3-B_Silkscreen.gbr, Diseño_v3-Edge_Cuts.gbr, Diseño_v3-F_Cu.gbr, Diseño_v3-F_Mask.gbr, Diseño_v3-F_Paste.gbr]
2026-06-30 commit final
    [switching_v3.kicad_pcb, switching_v3.kicad_sch]
